Kvantorium-33/optimal_gripper/hardware/Документация/Для отбытия/List of things.docx

Наименование вещи | Количество, штука | Инвентарный номер (если имеется)
Ноутбук Lenovo
Ноутбук Lenovo
Паяльная станция <Название> | 1
