Kvantorium-33/optimal_gripper/hardware/Документация/Изображения/Структурная схема.jpg

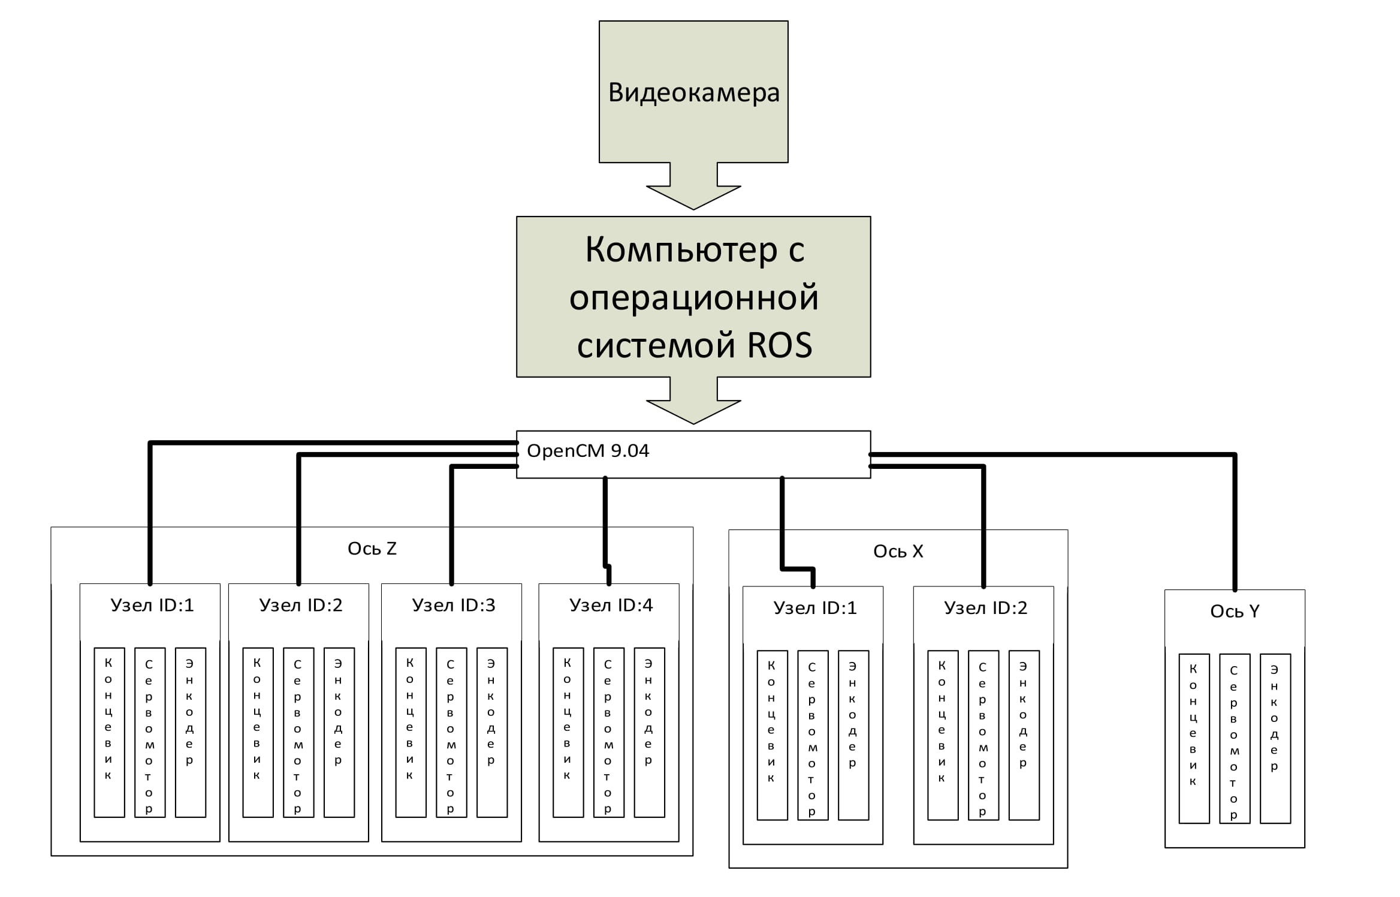
hardware/Документация/Изображения/Структурная схема.jpg
