Kvantorium-33/optimal_gripper/hardware/Документация/Чертежи/КВ33.044.000 - Сортирующая ячейка/КВ33.044.000 - Сортирующая ячейка.jpg

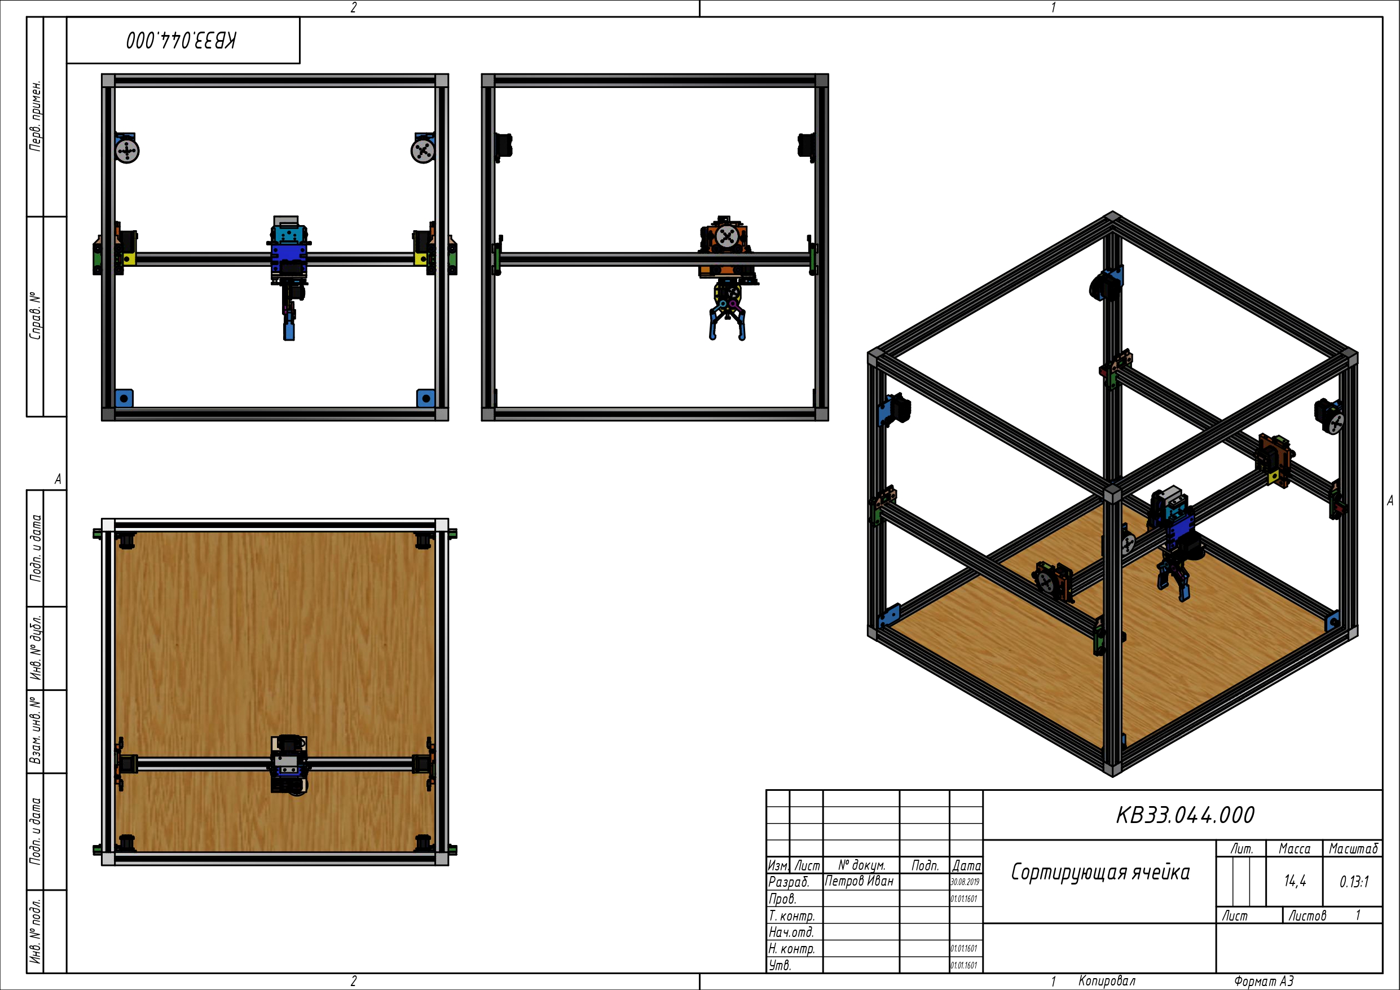
hardware/Документация/Чертежи/КВ33.044.000 - Сортирующая ячейка/КВ33.044.000 - Сортирующая ячейка.jpg
