Kvantorium-33/optimal_gripper/hardware/Документация/Чертежи/КВ33.044.300 - Каретка оси Z/КВ33.044.300 - Каретка оси Z_page-0001.jpg

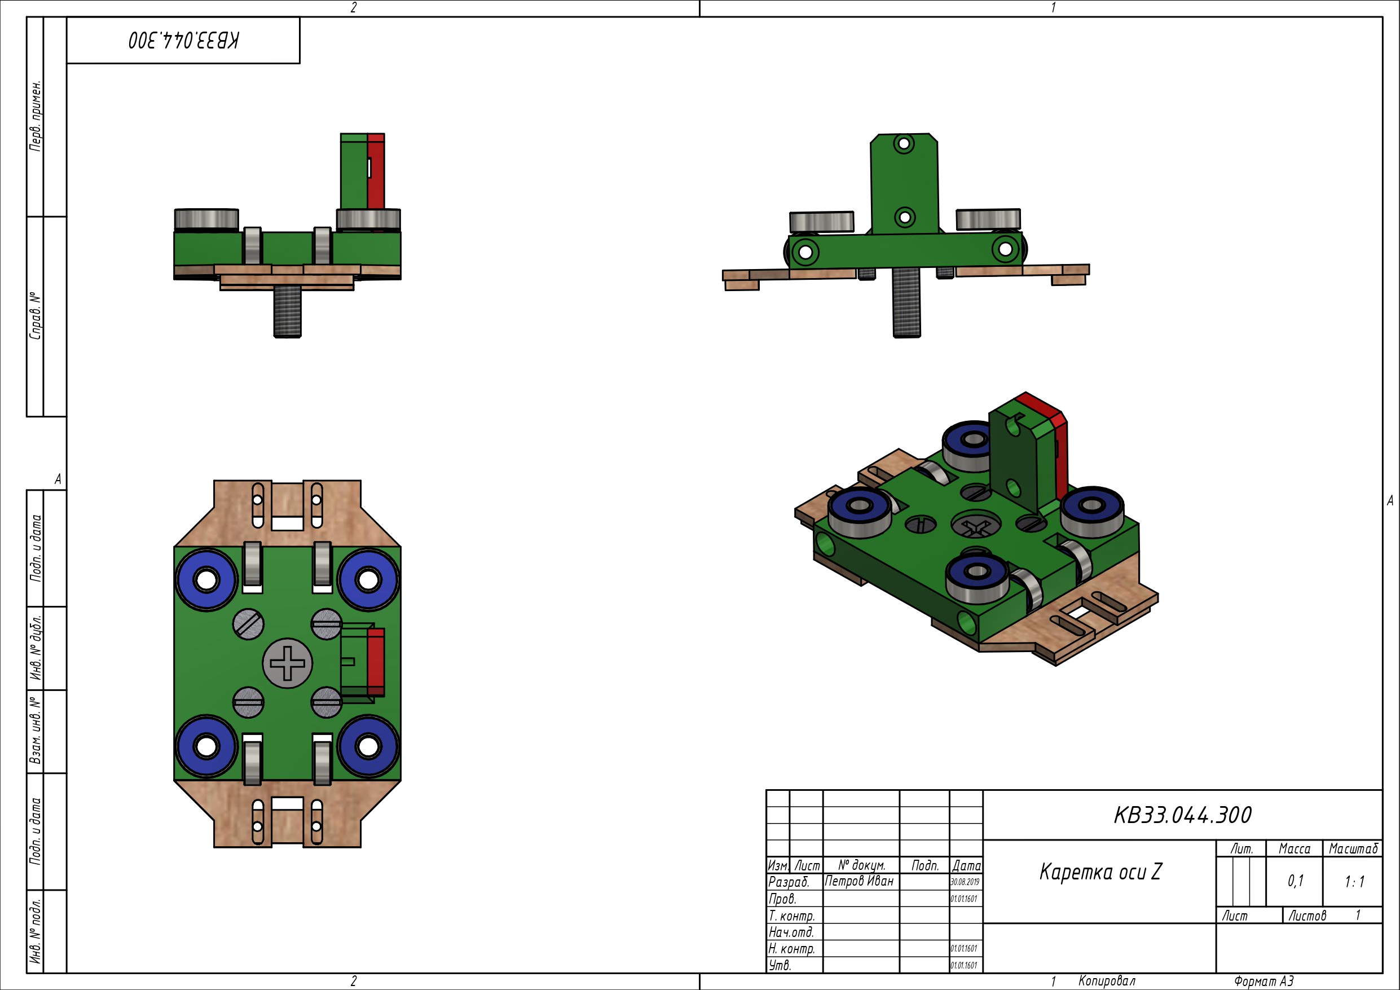
hardware/Документация/Чертежи/КВ33.044.300 - Каретка оси Z/КВ33.044.300 - Каретка оси Z_page-0001.jpg
