Kvantorium-33/optimal_gripper/hardware/Документация/Чертежи/КВ33.044.400 - Каретка оси Х/КВ33.044.400 - Каретка оси X_page-0001.jpg

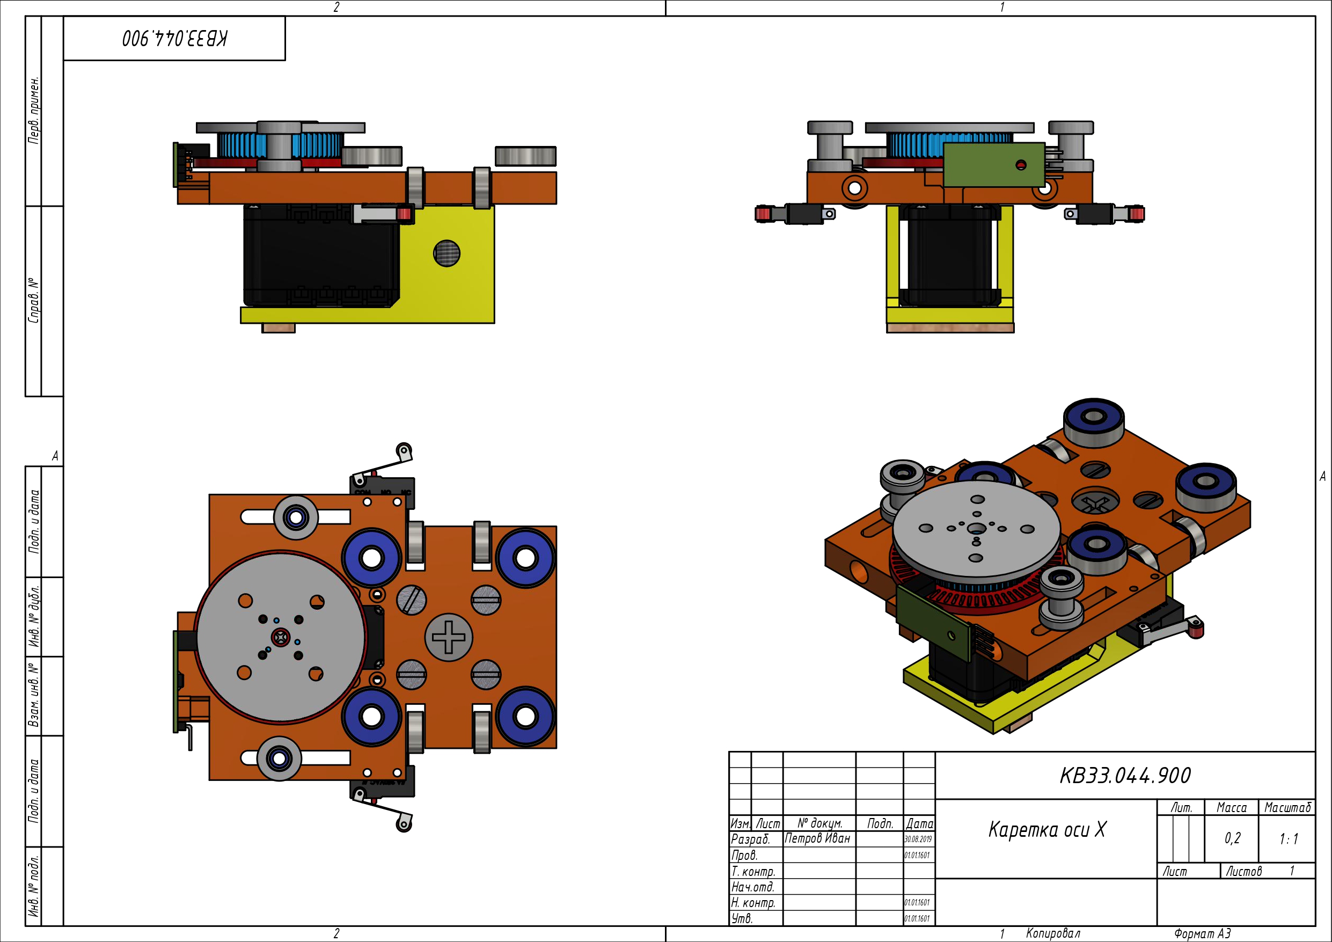
hardware/Документация/Чертежи/КВ33.044.400 - Каретка оси Х/КВ33.044.400 - Каретка оси X_page-0001.jpg
