Kvantorium-33/optimal_gripper/hardware/Документация/Чертежи/КВ33.044.500 - Сборка сервомотора с креплением/КВ33.044.500 -  Сборка сервомотора Dynamixel с крепление_page-0001.jpg

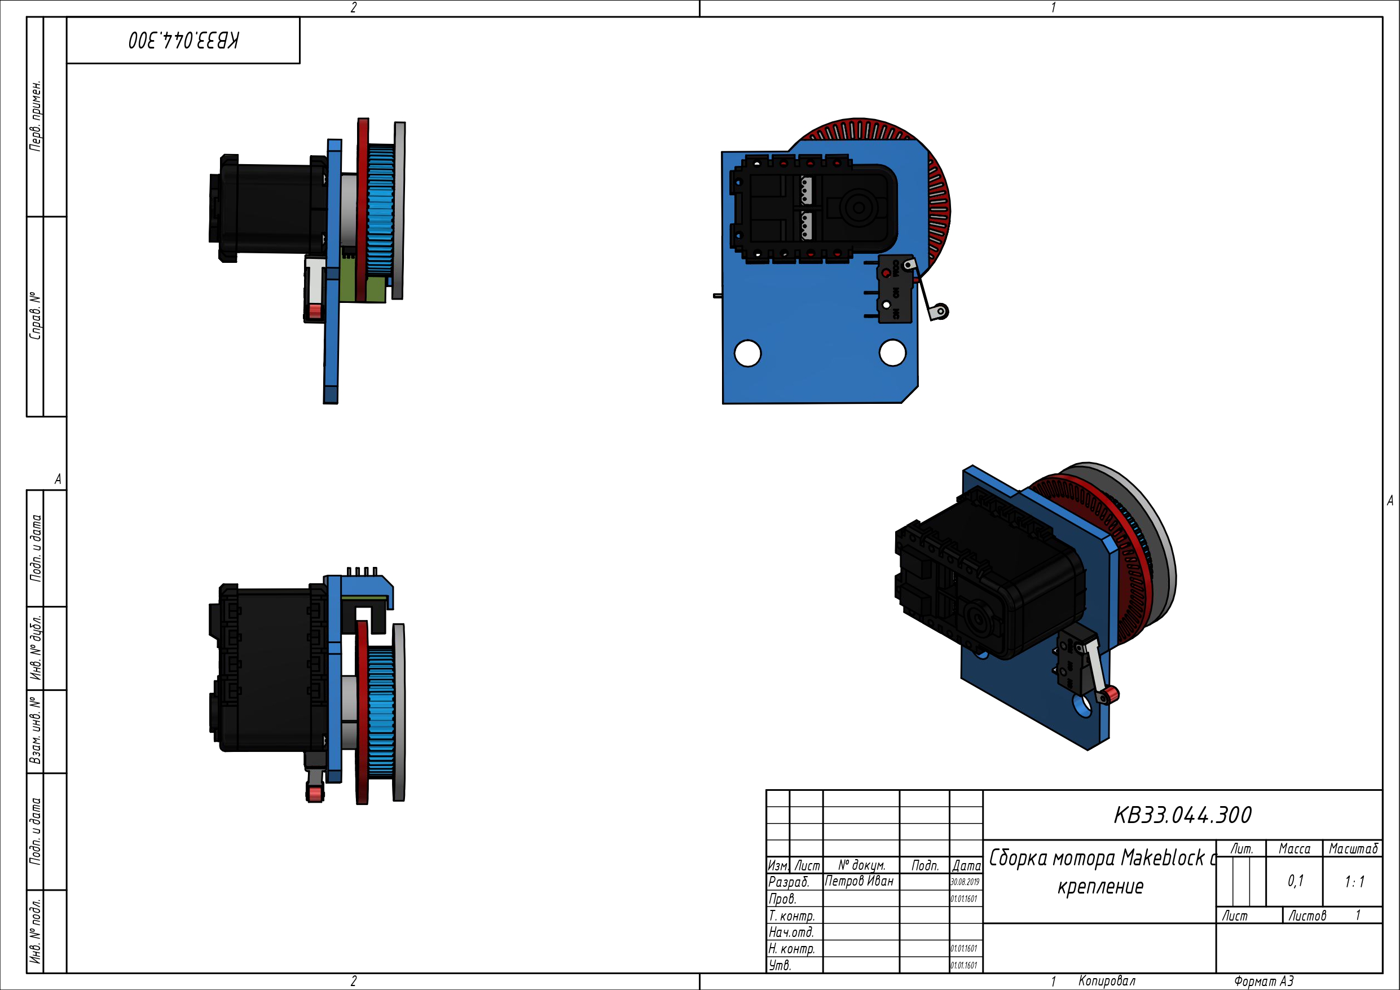
hardware/Документация/Чертежи/КВ33.044.500 - Сборка сервомотора с креплением/КВ33.044.500 - Сборка сервомотора Dynamixel с крепление_page-0001.jpg
