Kvantorium-33/optimal_gripper/hardware/Документация/Чертежи/КВ33.044.600 - Сборка сервомотора с креплением обратная/КВ33.044.600 -  Сборка сервомотора Dynamixel с крепление обратный_page-0001.jpg

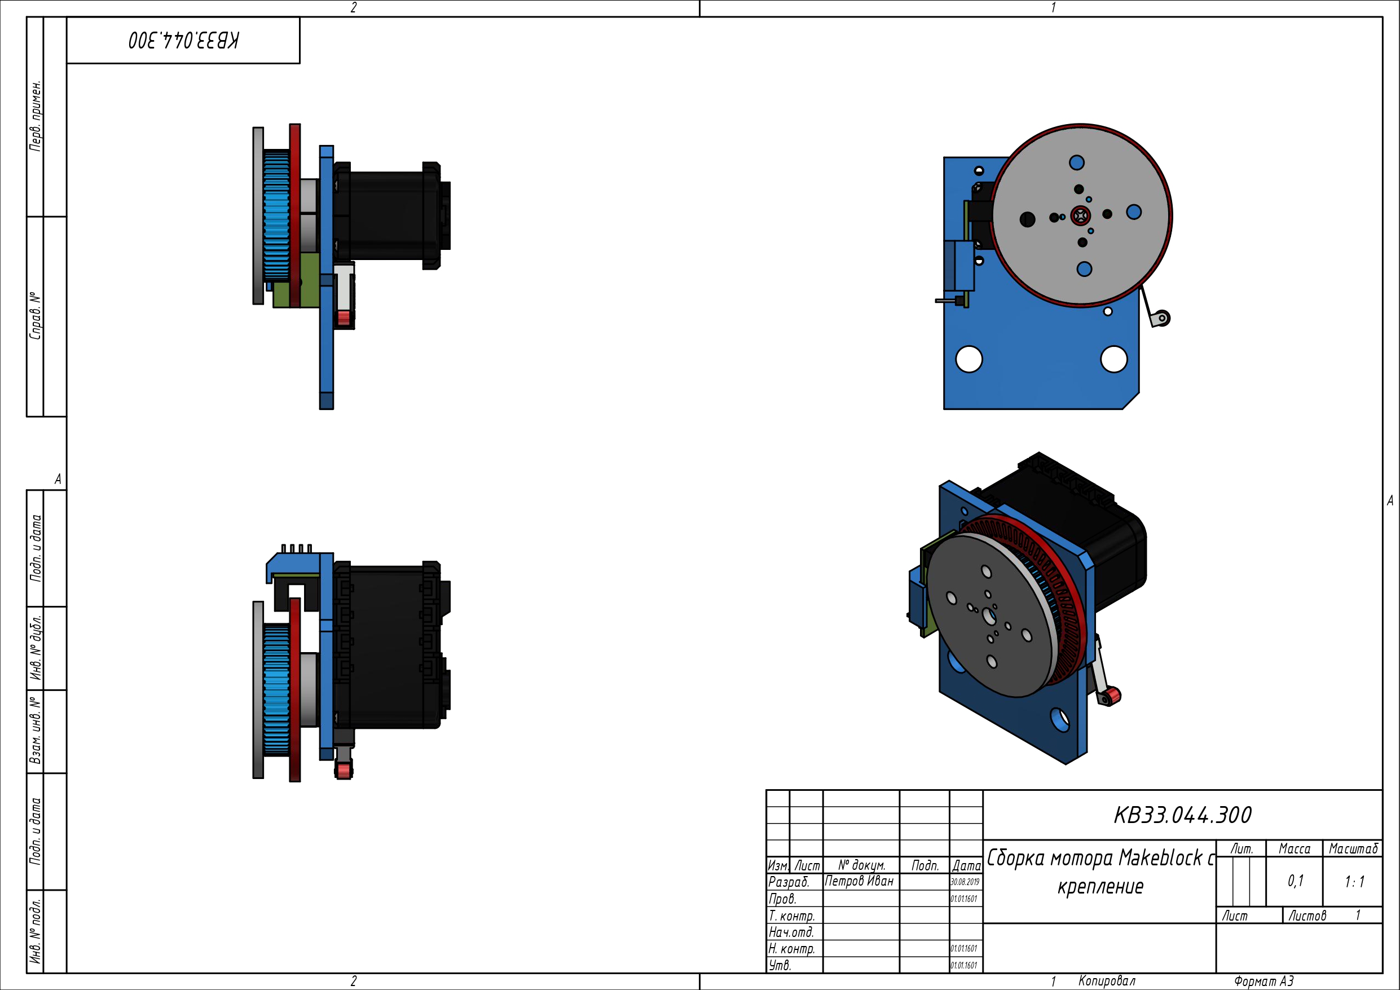
hardware/Документация/Чертежи/КВ33.044.600 - Сборка сервомотора с креплением обратная/КВ33.044.600 - Сборка сервомотора Dynamixel с крепление обратный_page-0001.jpg
