Kvantorium-33/optimal_gripper/hardware/Документация/Чертежи/КВ33.044.700 - Каретка оси Y/КВ33.044.700 - Каретка оси Y_page-0001.jpg

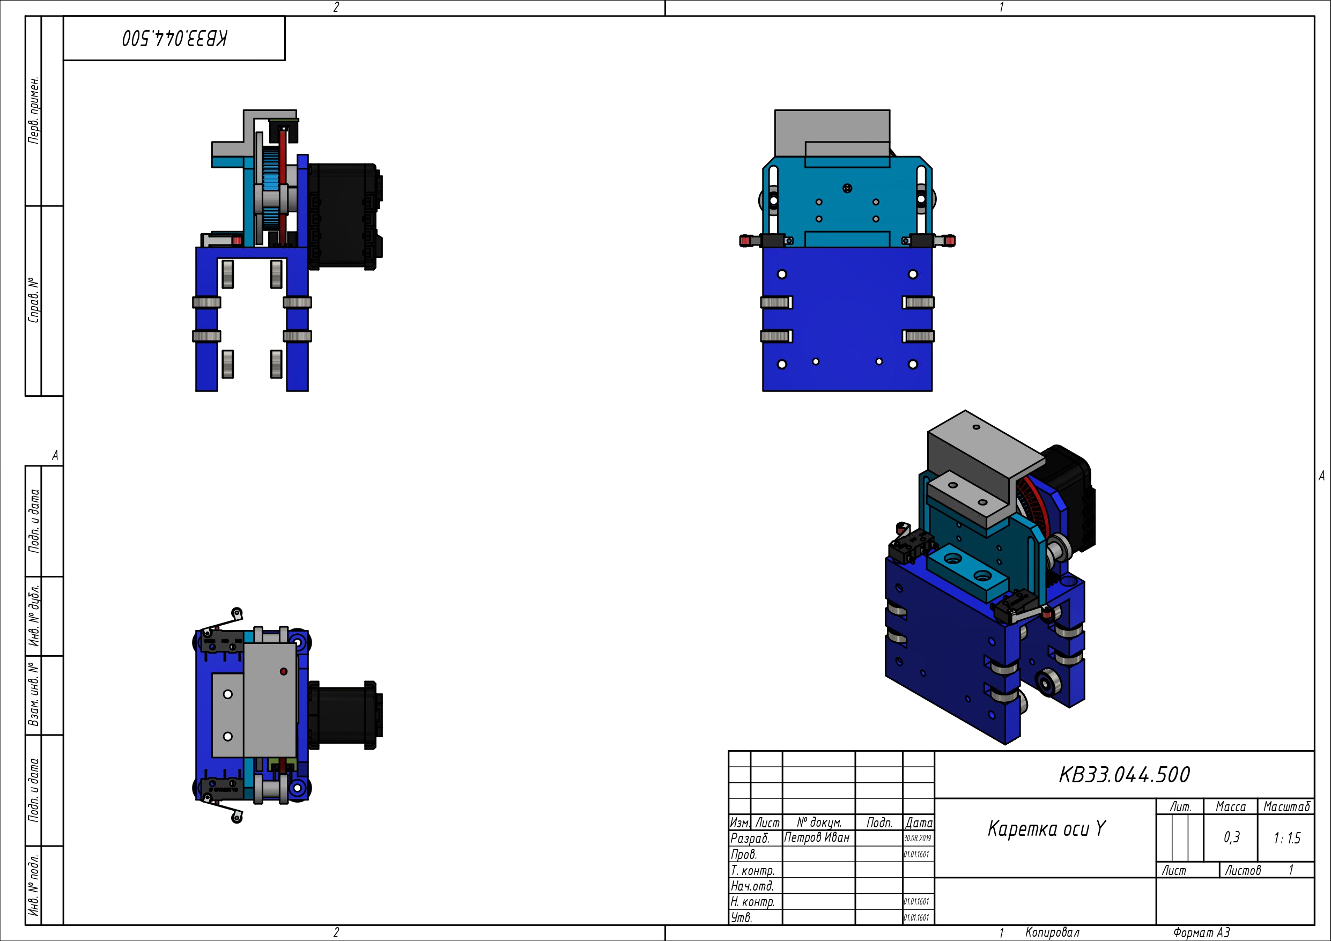
hardware/Документация/Чертежи/КВ33.044.700 - Каретка оси Y/КВ33.044.700 - Каретка оси Y_page-0001.jpg
