Kvantorium-33/optimal_gripper/hardware/Документация/Чертежи/КВ33.044.800 - Каретка оси Y/КВ33.044.800 - Сборка держателя катка_page-0001.jpg

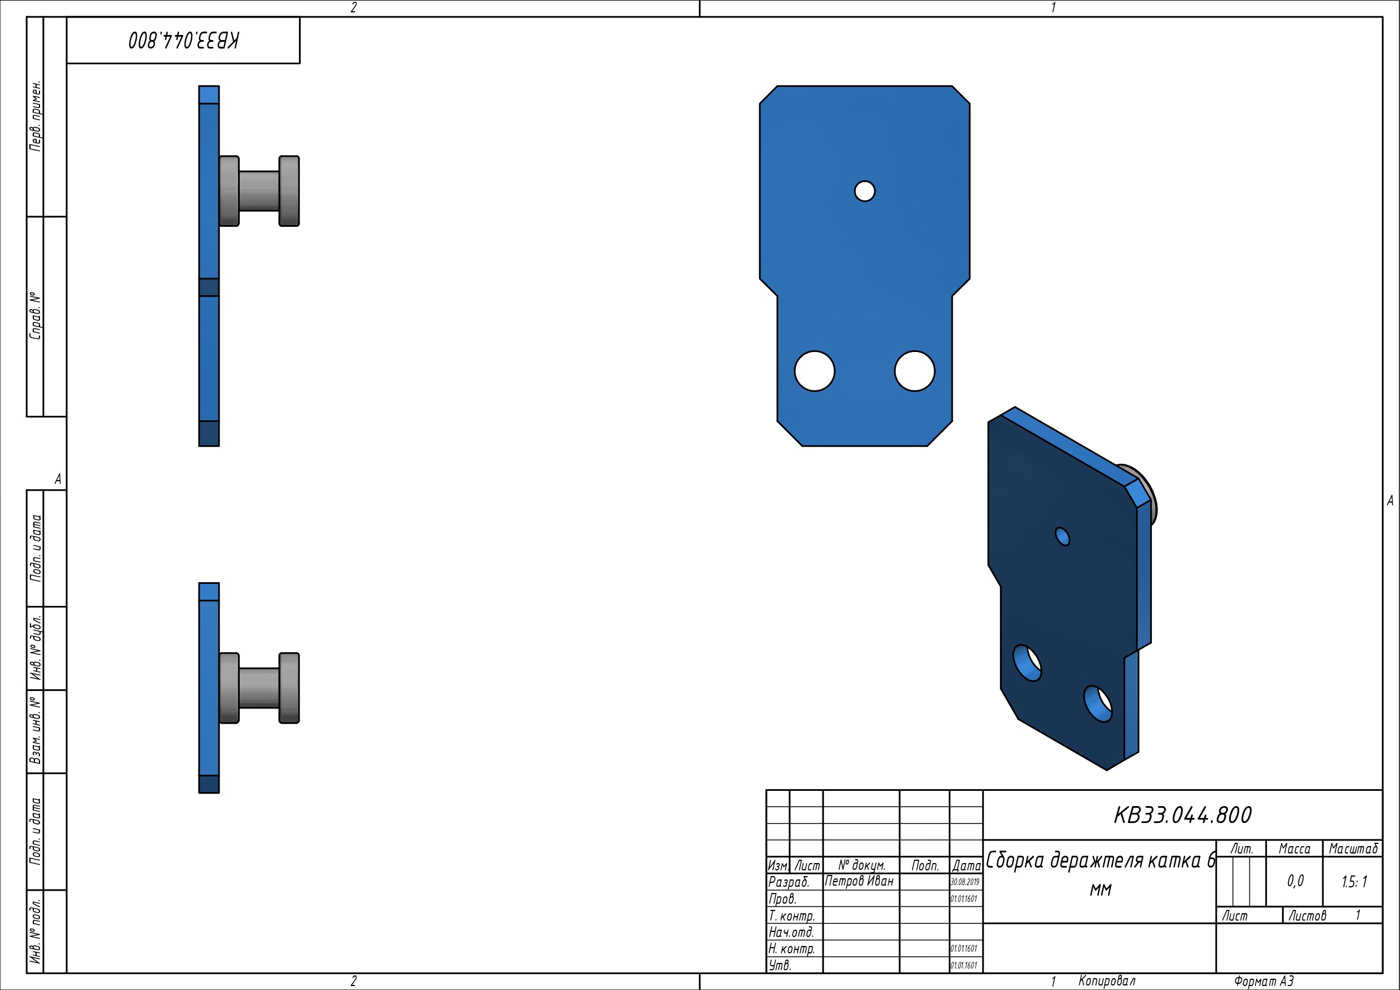
hardware/Документация/Чертежи/КВ33.044.800 - Каретка оси Y/КВ33.044.800 - Сборка держателя катка_page-0001.jpg
