Kvantorium-33/optimal_gripper/hardware/Документация/Чертежи/КВ33.044.900 - Клапан присоски впускной/КВ33.044.900 - Клапан присоски впускной_page-0001.jpg

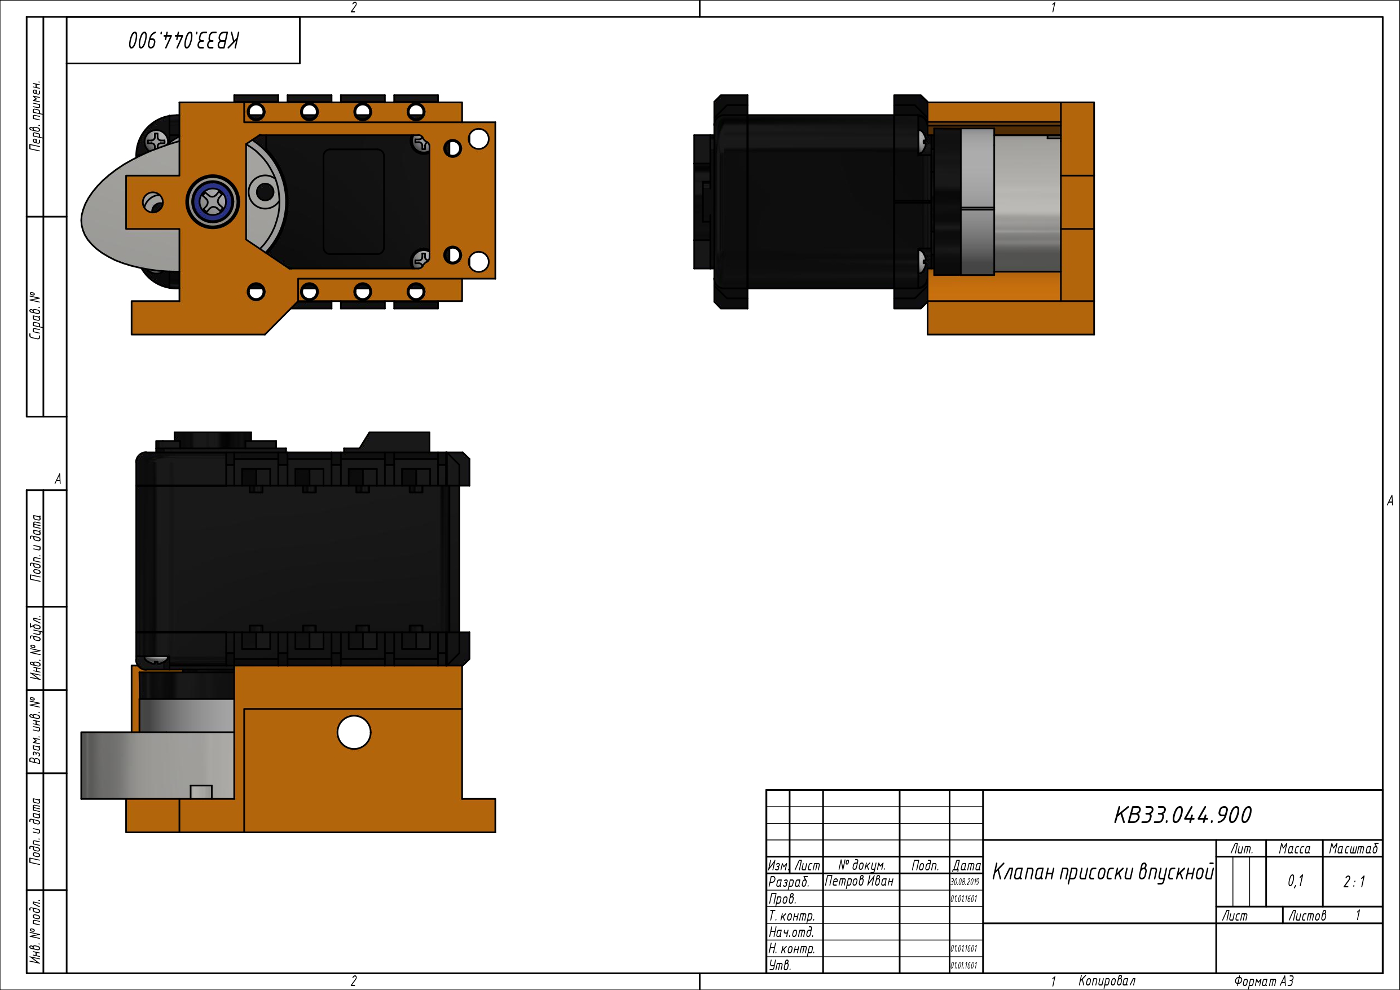
hardware/Документация/Чертежи/КВ33.044.900 - Клапан присоски впускной/КВ33.044.900 - Клапан присоски впускной_page-0001.jpg
