Kvantorium-33/optimal_gripper/hardware/Для изготовления/Cura проекты/UM2_КВ33_044_304  - Z KiT.3mf

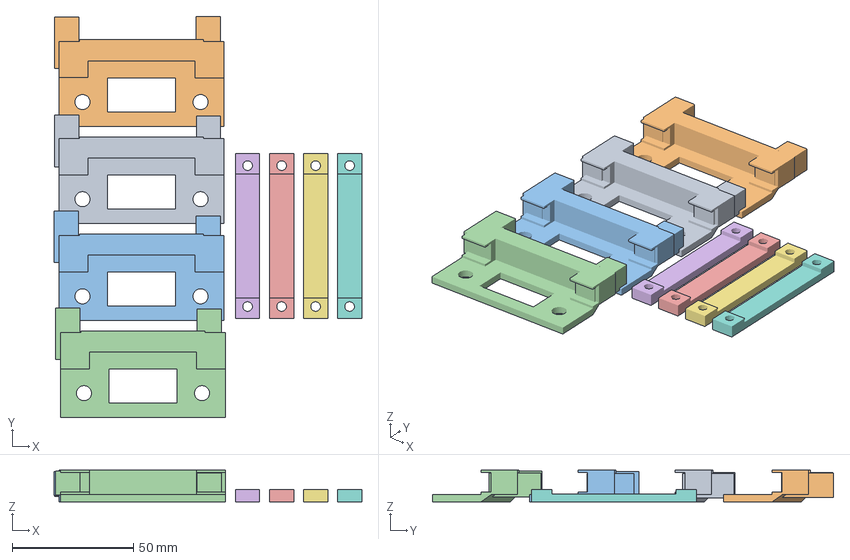
[picture p17: CAD file, 2019-10-25]
hardware/Для изготовления/Cura проекты/UM2_КВ33_044_304 - Z KiT.3mf
126.6 x 165.1 x 13.0 mm
