Kvantorium-33/optimal_gripper/hardware/Для изготовления/DXF (резка)/дно плат.dxf

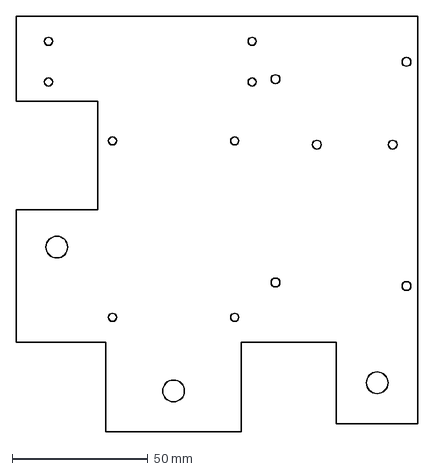
[picture p18: CAD file, 2019-10-30]
hardware/Для изготовления/DXF (резка)/дно плат.dxf
148.0 x 153.0 mm
