Kvantorium-33/optimal_gripper/hardware/Для изготовления/STL (печать)/КВ33.044.406 - Прижим ремня.stl

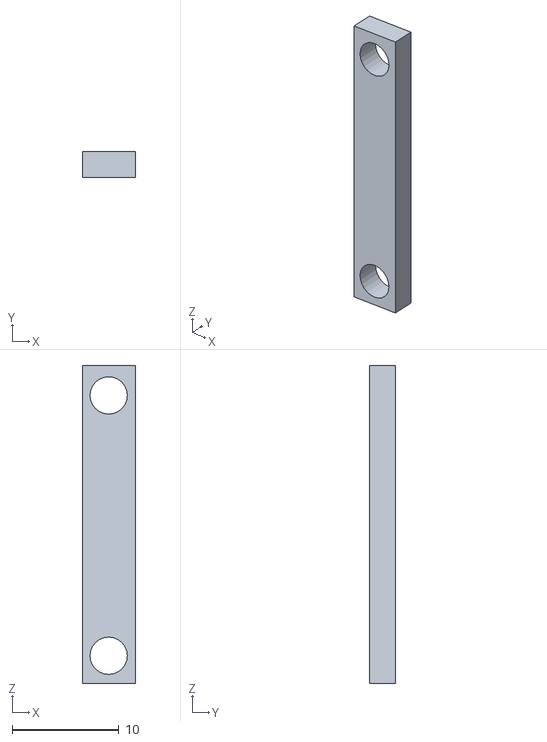
[picture p19: CAD file, 2019-10-25]
hardware/Для изготовления/STL (печать)/КВ33.044.406 - Прижим ремня.stl
5.00 x 2.40 x 29.8
