Kvantorium-33/optimal_gripper/hardware/Для изготовления/Печатная плата/Печатная плата управляющая/Печатная плата управляющая.dxf

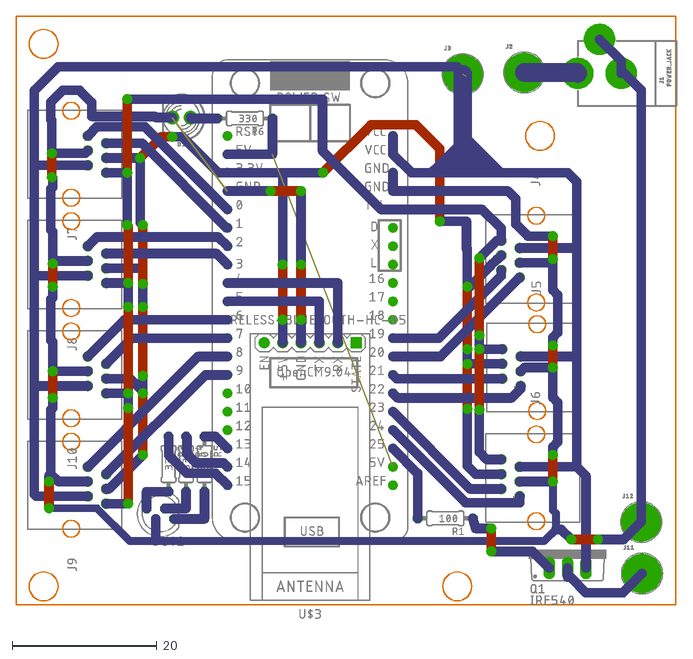
[picture p20: CAD file, 2019-10-25]
hardware/Для изготовления/Печатная плата/Печатная плата управляющая/Печатная плата управляющая.dxf
91.3 x 83.2
