Kvantorium-33/optimal_gripper/hardware/Для изготовления/Cura проекты/UM2_КВ33.044. - krepegi remna oci y.3mf

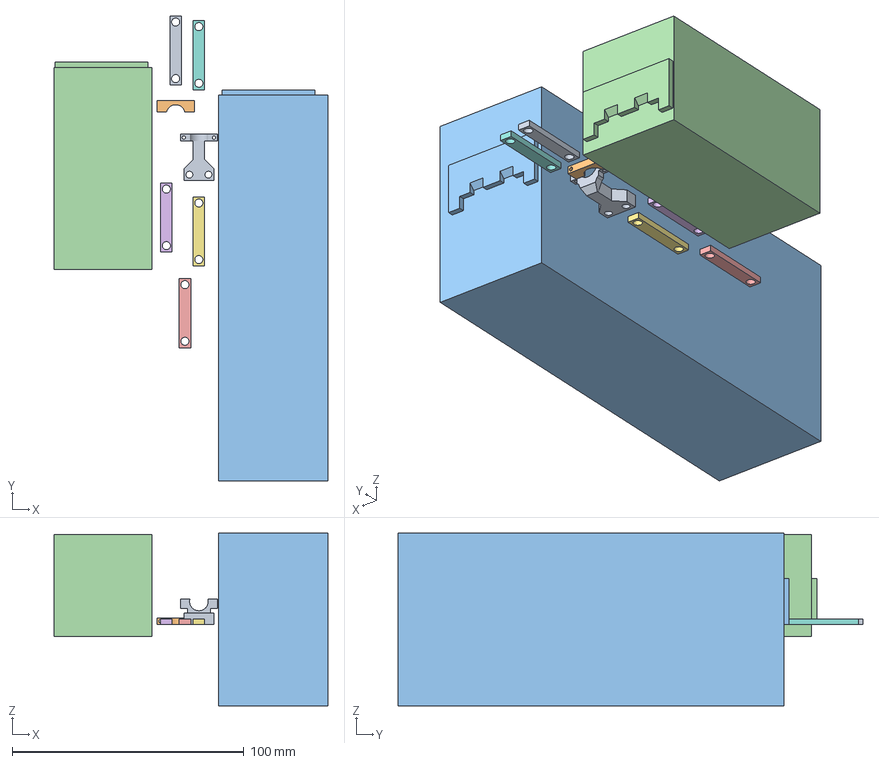
[picture p21: CAD file, 2019-10-25]
hardware/Для изготовления/Cura проекты/UM2_КВ33.044. - krepegi remna oci y.3mf
118.1 x 200.4 x 74.5 mm
