Kvantorium-33/optimal_gripper/hardware/Для изготовления/DXF (резка)/Боковина шкива уменьшанная.dxf

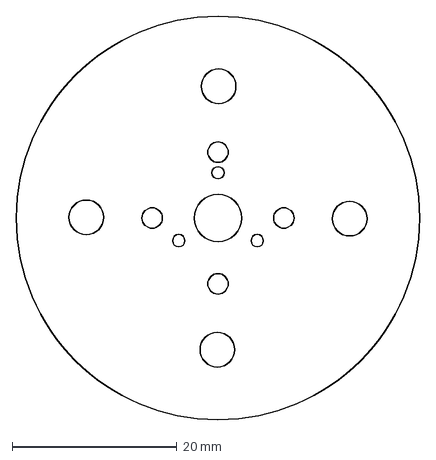
[picture p22: CAD file, 2019-08-26]
hardware/Для изготовления/DXF (резка)/Боковина шкива уменьшанная.dxf
49.0 x 49.0 mm
