Kvantorium-33/optimal_gripper/hardware/Для изготовления/STL (печать)/КВ33.044.208 - Зажим вакумной присоски.stl

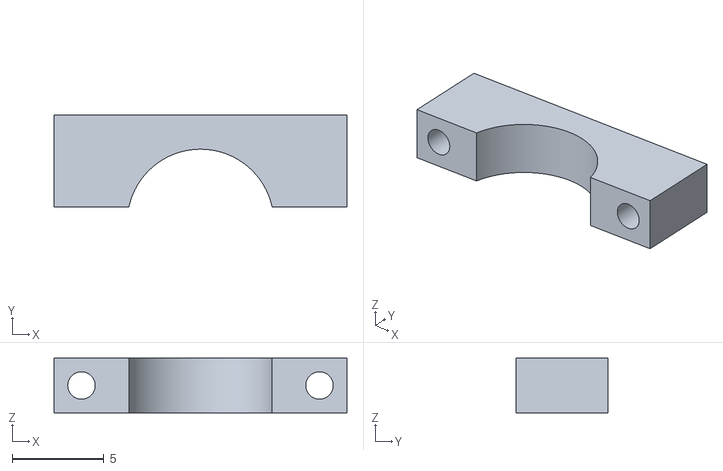
[picture p23: CAD file, 2019-10-25]
hardware/Для изготовления/STL (печать)/КВ33.044.208 - Зажим вакумной присоски.stl
16.0 x 5.00 x 3.00
