Kvantorium-33/optimal_gripper/hardware/Для изготовления/Cura проекты/UM2_КВ33.044.304 - Держатель ремня.3mf

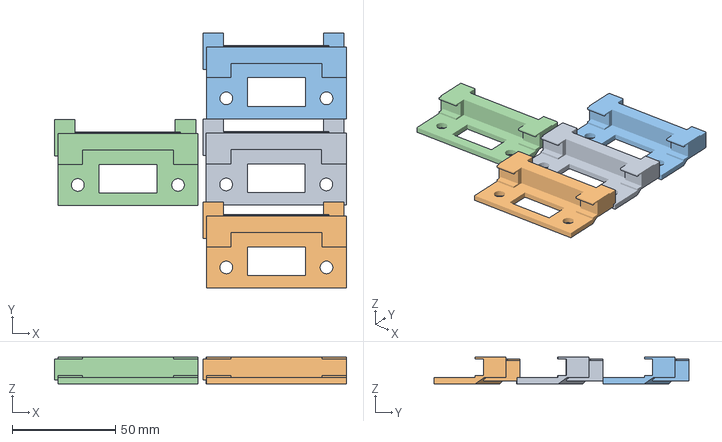
[picture p24: CAD file, 2019-10-25]
hardware/Для изготовления/Cura проекты/UM2_КВ33.044.304 - Держатель ремня.3mf
141.6 x 123.7 x 13.0 mm
