Kvantorium-33/optimal_gripper/hardware/Для изготовления/DXF (резка)/КВ33.044.204 - Крепеж ремня.dxf

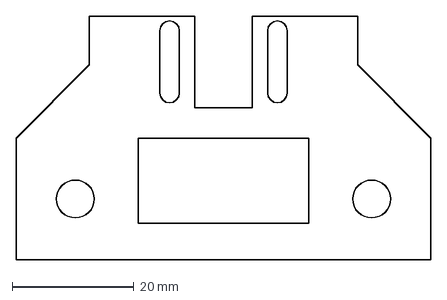
[picture p25: CAD file, 2019-08-19]
hardware/Для изготовления/DXF (резка)/КВ33.044.204 - Крепеж ремня.dxf
68.0 x 40.0 mm
