Kvantorium-33/optimal_gripper/hardware/Для изготовления/STL (печать)/КВ33.044.305 - Прижим ремня.stl

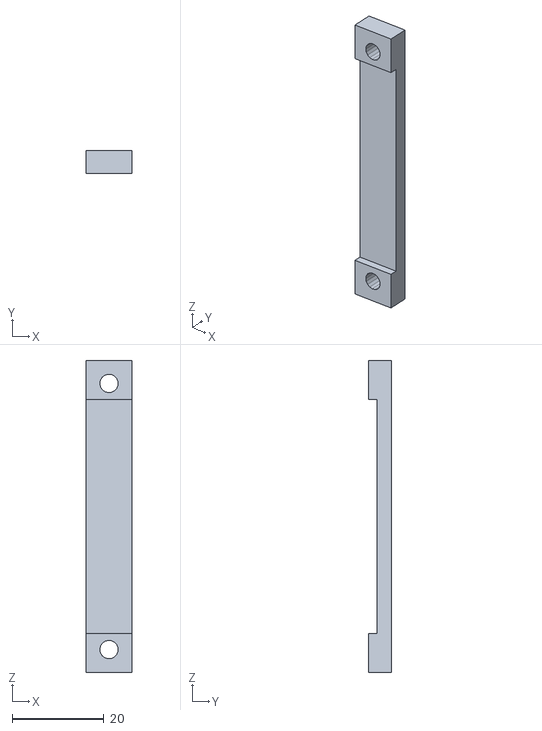
[picture p26: CAD file, 2019-10-25]
hardware/Для изготовления/STL (печать)/КВ33.044.305 - Прижим ремня.stl
10.0 x 5.00 x 68.0
