Kvantorium-33/optimal_gripper/hardware/Для изготовления/Cura проекты/UM2_КВ33.044.900 - Клапан впускной.3mf

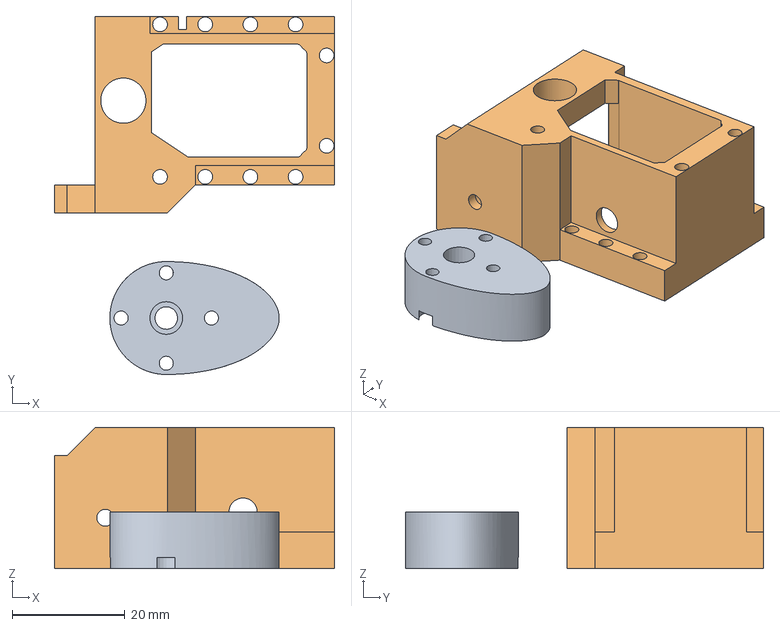
[picture p27: CAD file, 2019-08-25]
hardware/Для изготовления/Cura проекты/UM2_КВ33.044.900 - Клапан впускной.3mf
49.6 x 63.4 x 25.0 mm
