Kvantorium-33/optimal_gripper/hardware/Для изготовления/DXF (резка)/Боковина шкива.dxf

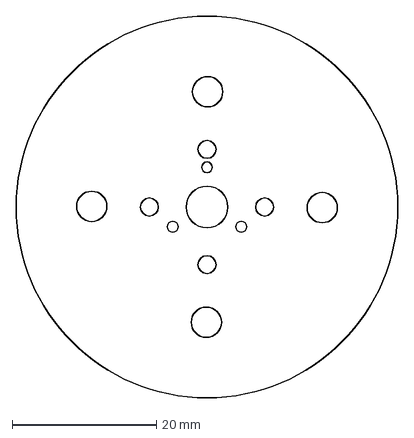
[picture p28: CAD file, 2019-08-08]
hardware/Для изготовления/DXF (резка)/Боковина шкива.dxf
53.0 x 53.0 mm
