Kvantorium-33/optimal_gripper/hardware/Для изготовления/STL (печать)/КВ33.044.405 - Крепеж ремня оси Y.stl

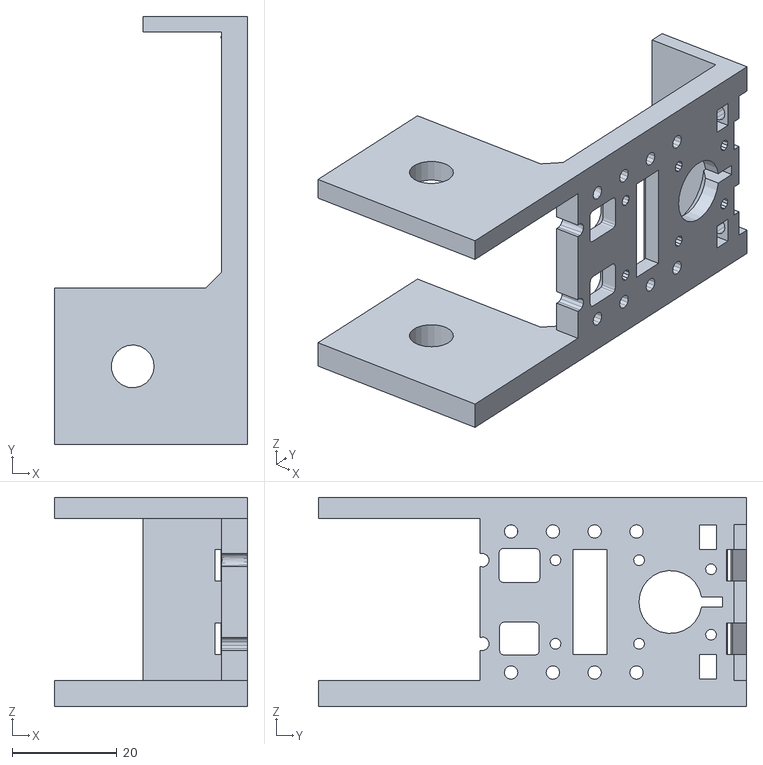
[picture p29: CAD file, 2019-10-25]
hardware/Для изготовления/STL (печать)/КВ33.044.405 - Крепеж ремня оси Y.stl
37.0 x 82.0 x 40.0
