Kvantorium-33/optimal_gripper/hardware/Для изготовления/Cura проекты/UM2_KV33_044 - zahvat.3mf

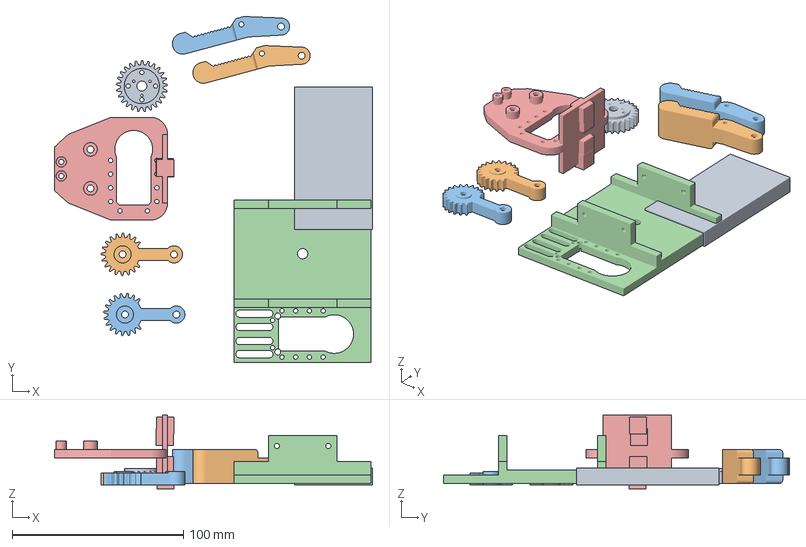
[picture p30: CAD file, 2019-08-22]
hardware/Для изготовления/Cura проекты/UM2_KV33_044 - zahvat.3mf
185.6 x 202.0 x 43.0 mm
