Kvantorium-33/optimal_gripper/hardware/Для изготовления/DXF (резка)/Колесо оптического датчика.dxf

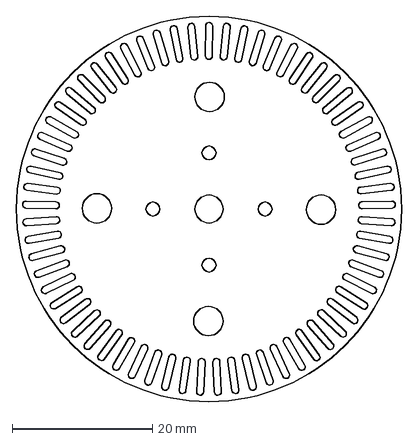
[picture p31: CAD file, 2019-08-08]
hardware/Для изготовления/DXF (резка)/Колесо оптического датчика.dxf
55.0 x 55.0 mm
