Kvantorium-33/optimal_gripper/hardware/Для изготовления/STL (печать)/КВ33.044.207 - Крепление вакумной присоски.stl

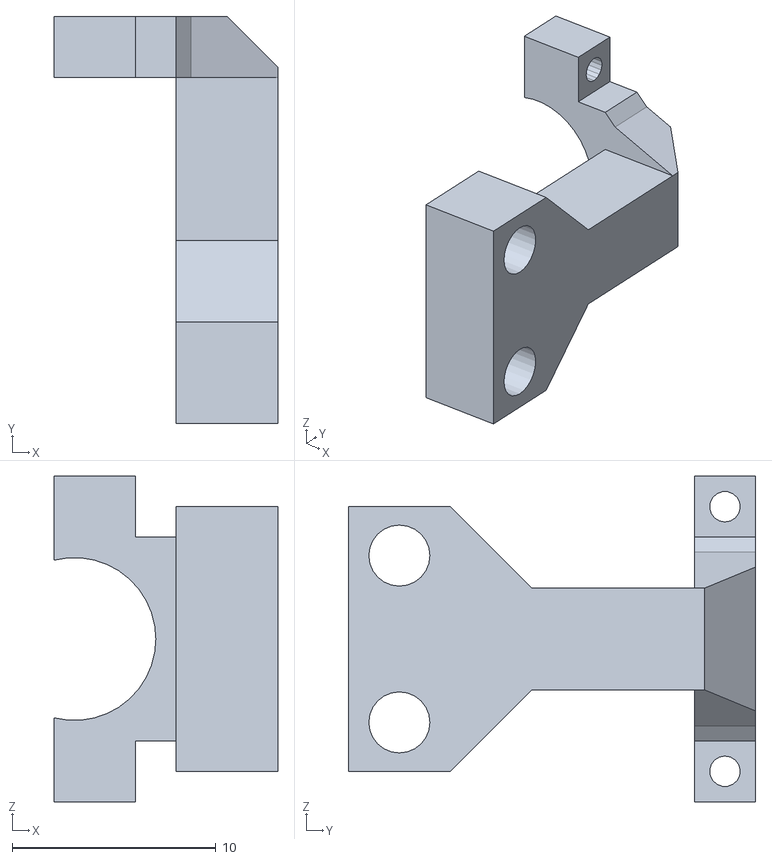
[picture p32: CAD file, 2019-10-25]
hardware/Для изготовления/STL (печать)/КВ33.044.207 - Крепление вакумной присоски.stl
11.0 x 20.0 x 16.0
