Kvantorium-33/optimal_gripper/hardware/Для изготовления/Cura проекты/UM2_КВ33.044.701 - Щека каретка оси Y.3mf

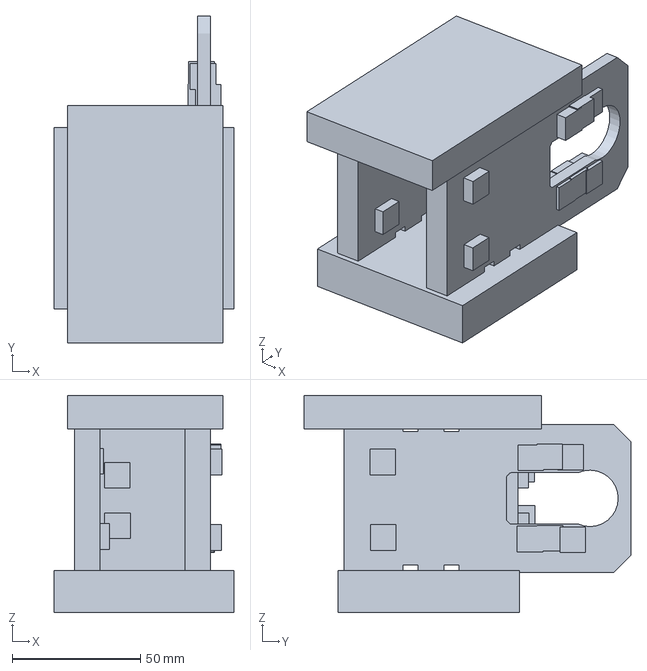
[picture p33: CAD file, 2019-08-19]
hardware/Для изготовления/Cura проекты/UM2_КВ33.044.701 - Щека каретка оси Y.3mf
70.1 x 127.5 x 84.7 mm
