Kvantorium-33/optimal_gripper/hardware/Для изготовления/STL (печать)/КВ33.044.304 - Держатель ремня.stl

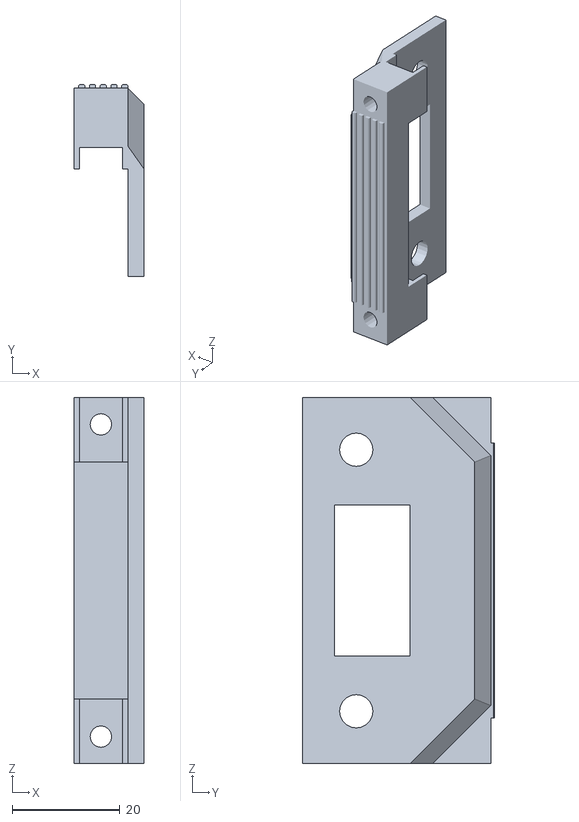
[picture p34: CAD file, 2019-10-25]
hardware/Для изготовления/STL (печать)/КВ33.044.304 - Держатель ремня.stl
13.0 x 35.7 x 68.0
