Kvantorium-33/optimal_gripper/hardware/Для изготовления/Cura проекты/UM2_КВ33.044.601 - Щека каретка оси Y.3mf

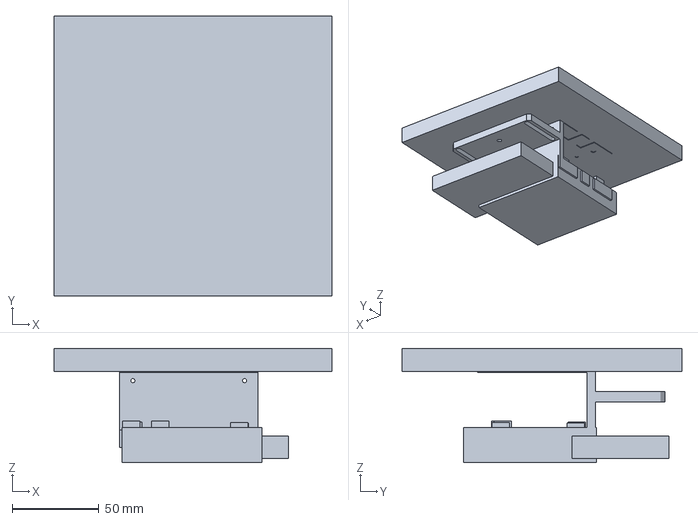
[picture p35: CAD file, 2019-08-15]
hardware/Для изготовления/Cura проекты/UM2_КВ33.044.601 - Щека каретка оси Y.3mf
160.2 x 161.3 x 65.8 mm
