Kvantorium-33/optimal_gripper/hardware/Для изготовления/STL (печать)/КВ33.044.703 - Стойка оптического датчика оси Y.stl

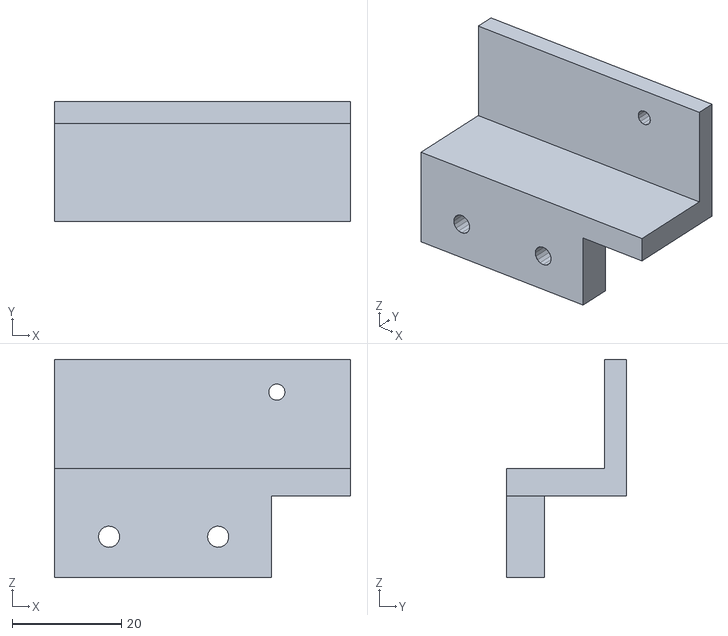
[picture p36: CAD file, 2019-08-26]
hardware/Для изготовления/STL (печать)/КВ33.044.703 - Стойка оптического датчика оси Y.stl
54.2 x 22.0 x 40.0
