Kvantorium-33/optimal_gripper/hardware/Для изготовления/Cura проекты/UM2_КВ33.044.201 - Щека каретки Z.3mf

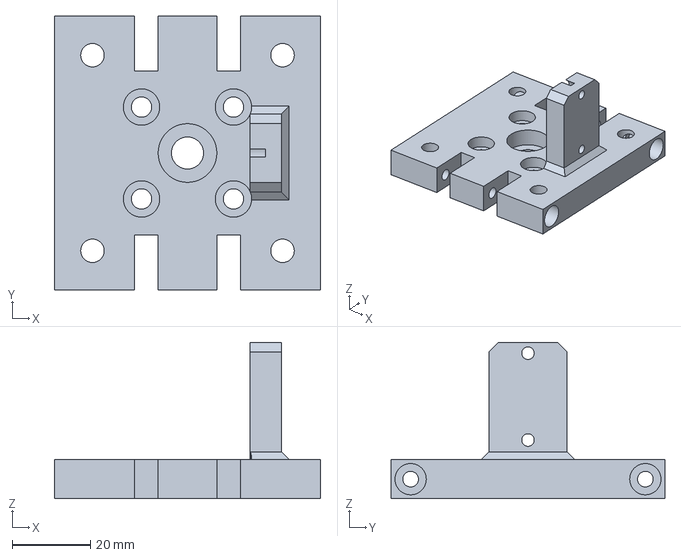
[picture p37: CAD file, 2019-08-14]
hardware/Для изготовления/Cura проекты/UM2_КВ33.044.201 - Щека каретки Z.3mf
68.0 x 70.0 x 40.0 mm
