Kvantorium-33/optimal_gripper/hardware/Для изготовления/STL (печать)/КВ33.044.702 - Стойка натягивающих роликов оси Y.stl

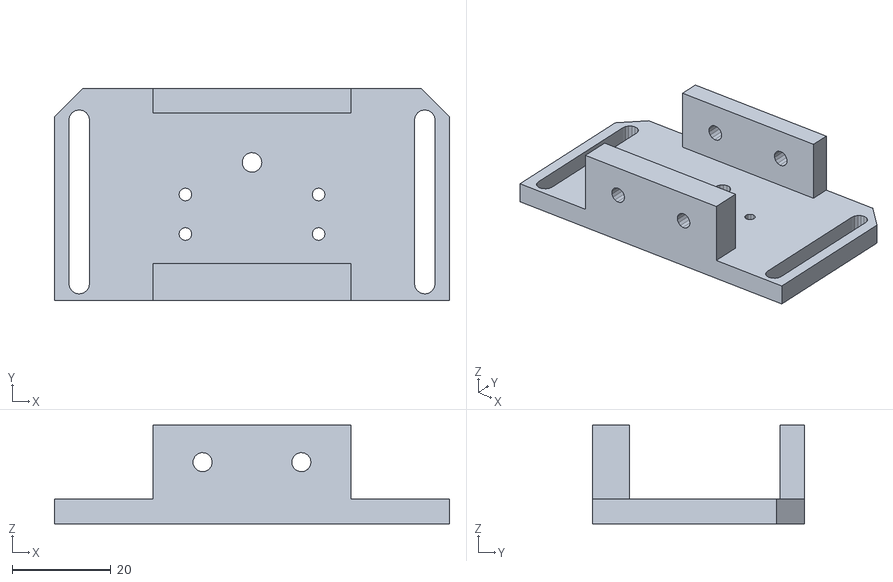
[picture p38: CAD file, 2019-08-26]
hardware/Для изготовления/STL (печать)/КВ33.044.702 - Стойка натягивающих роликов оси Y.stl
80.0 x 43.0 x 20.0
