Kvantorium-33/optimal_gripper/hardware/Для изготовления/STL (печать)/КВ33.044.901  - Опора клапана присоски.stl

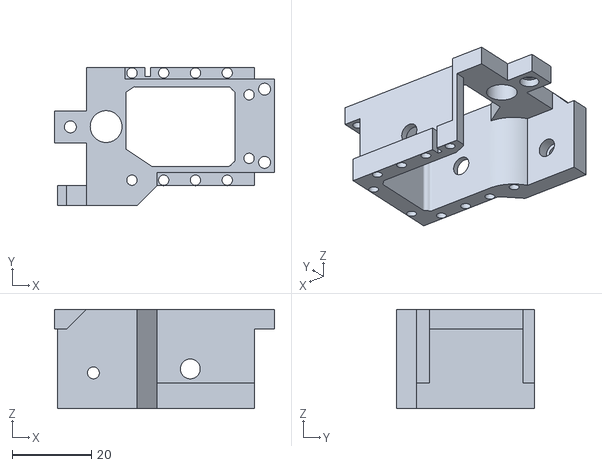
[picture p39: CAD file, 2019-08-26]
hardware/Для изготовления/STL (печать)/КВ33.044.901 - Опора клапана присоски.stl
55.4 x 34.8 x 25.0
