Kvantorium-33/optimal_gripper/hardware/Для изготовления/STL (печать)/КВ33.044.902 - Кулачок дисковый.stl

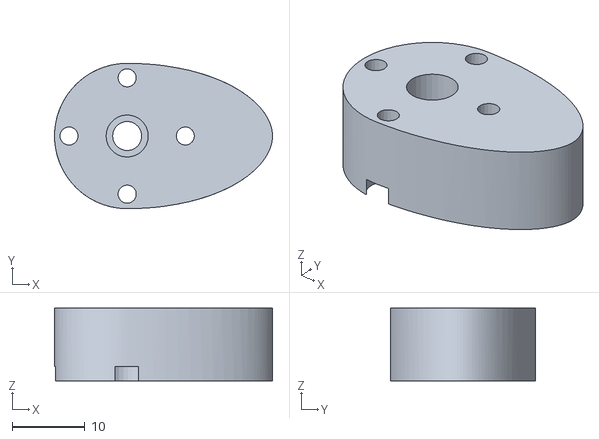
[picture p40: CAD file, 2019-08-25]
hardware/Для изготовления/STL (печать)/КВ33.044.902 - Кулачок дисковый.stl
30.0 x 20.0 x 10.0
