Kvantorium-33/optimal_gripper/hardware/Для изготовления/STL (печать)/КВ33.044.205-  Рычаг приводной 17 зубьев.stl

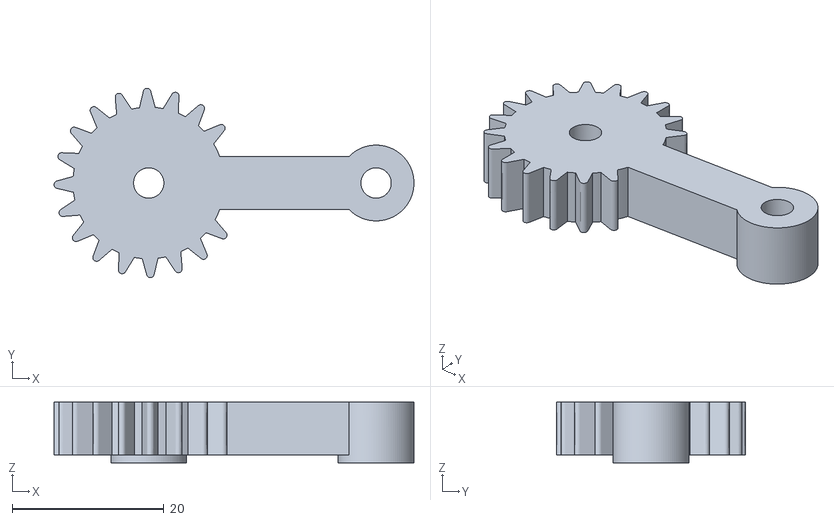
[picture p41: CAD file, 2019-08-22]
hardware/Для изготовления/STL (печать)/КВ33.044.205- Рычаг приводной 17 зубьев.stl
47.5 x 25.0 x 8.00
