Kvantorium-33/optimal_gripper/hardware/Для изготовления/STL (печать)/КВ33.044.102 - Колесо зубчатое сервомотора.stl

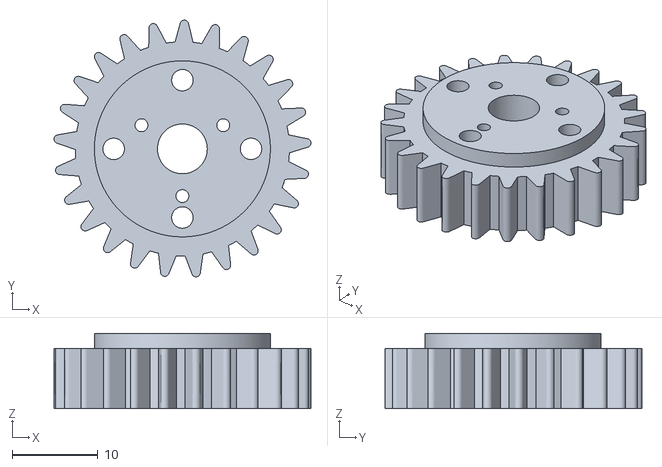
[picture p42: CAD file, 2019-08-22]
hardware/Для изготовления/STL (печать)/КВ33.044.102 - Колесо зубчатое сервомотора.stl
29.9 x 29.9 x 8.76
