Kvantorium-33/optimal_gripper/hardware/Для изготовления/STL (печать)/КВ33.044.202 - Прихват.stl

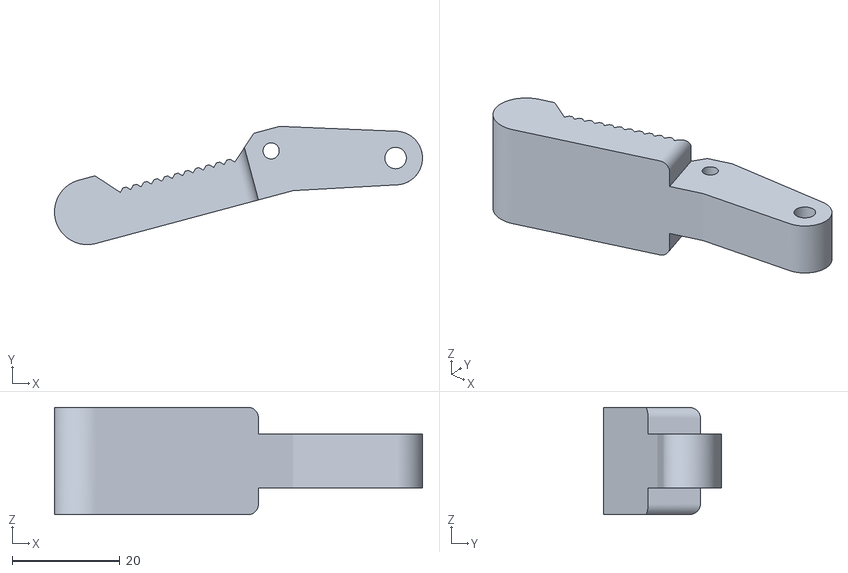
[picture p43: CAD file, 2019-08-22]
hardware/Для изготовления/STL (печать)/КВ33.044.202 - Прихват.stl
68.5 x 22.0 x 20.0
