Kvantorium-33/optimal_gripper/hardware/Для изготовления/STL (печать)/КВ33.044.203 - Рычаг толстый.stl

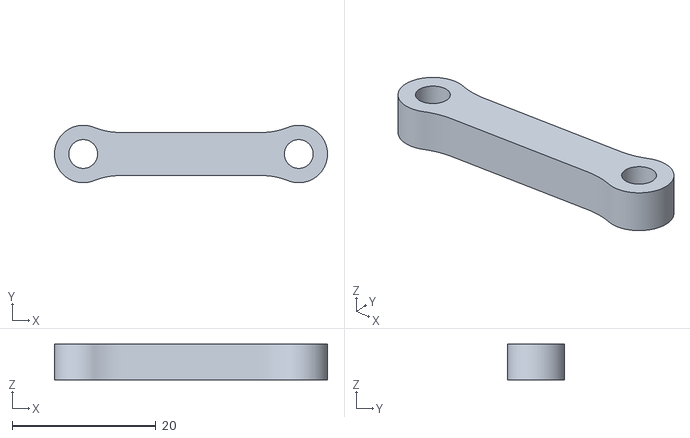
[picture p44: CAD file, 2019-08-22]
hardware/Для изготовления/STL (печать)/КВ33.044.203 - Рычаг толстый.stl
38.0 x 8.00 x 5.00
