Kvantorium-33/optimal_gripper/hardware/Для изготовления/STL (печать)/КВ33.044.201 - Опора прижимного захвата.stl

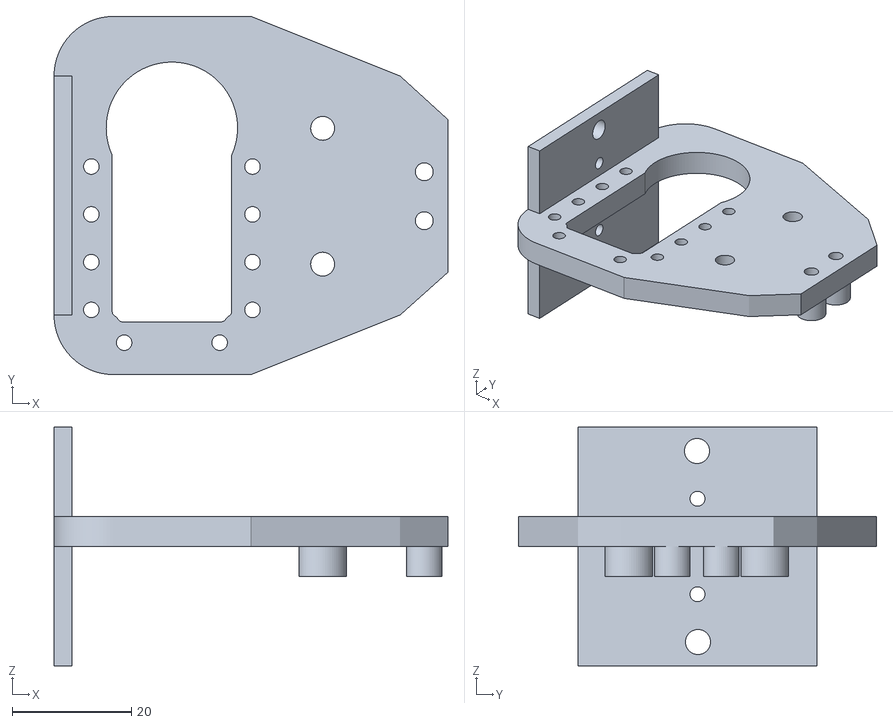
[picture p45: CAD file, 2019-08-22]
hardware/Для изготовления/STL (печать)/КВ33.044.201 - Опора прижимного захвата.stl
66.0 x 60.0 x 40.0
