Kvantorium-33/optimal_gripper/hardware/Для изготовления/STL (печать)/КВ33.044.204 - Рычг тонкий.stl

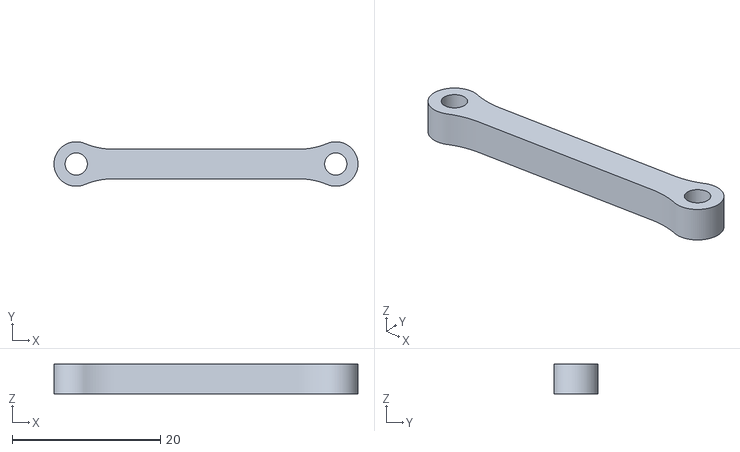
[picture p46: CAD file, 2019-08-22]
hardware/Для изготовления/STL (печать)/КВ33.044.204 - Рычг тонкий.stl
41.0 x 6.00 x 4.00
