Kvantorium-33/optimal_gripper/hardware/Для изготовления/STL (печать)/КВ33.044.101 - Опора захвата.stl

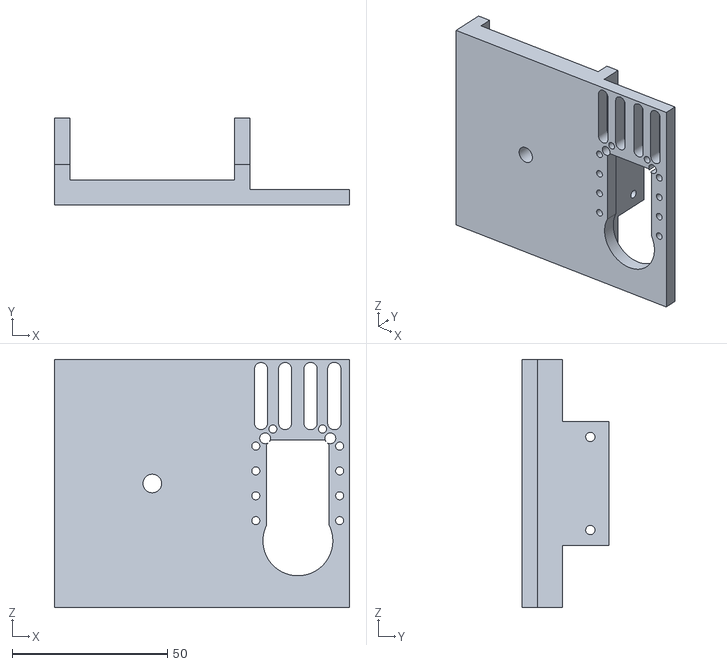
[picture p47: CAD file, 2019-08-22]
hardware/Для изготовления/STL (печать)/КВ33.044.101 - Опора захвата.stl
95.0 x 28.0 x 80.0
