Kvantorium-33/optimal_gripper/hardware/Для изготовления/STL (печать)/КВ33.044.206 - Рычаг приводной 16 зубьев.stl

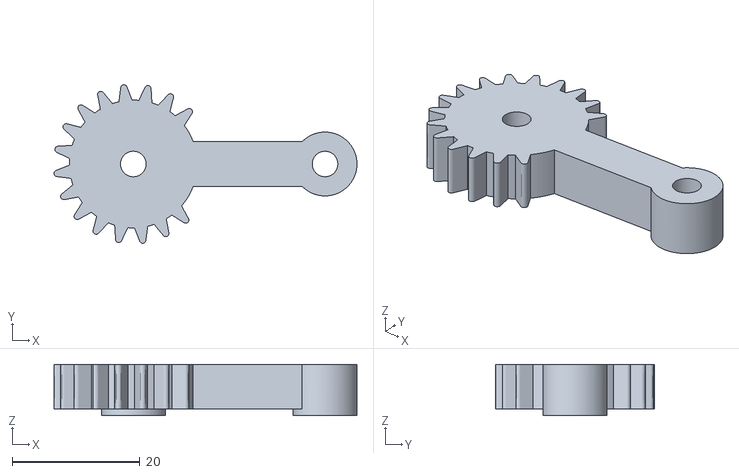
[picture p48: CAD file, 2019-08-22]
hardware/Для изготовления/STL (печать)/КВ33.044.206 - Рычаг приводной 16 зубьев.stl
47.4 x 24.8 x 8.00
