Kvantorium-33/optimal_gripper/hardware/Для изготовления/STL (печать)/Проставка 5.5 мм.stl

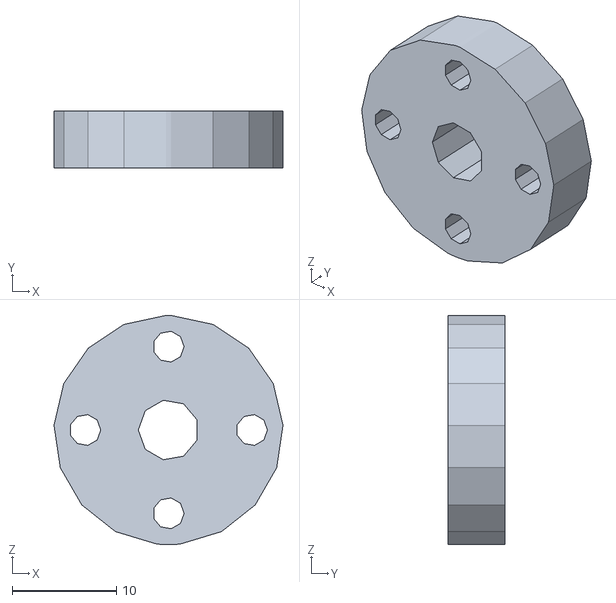
[picture p49: CAD file, 2019-08-19]
hardware/Для изготовления/STL (печать)/Проставка 5.5 мм.stl
22.0 x 5.50 x 22.0
