Kvantorium-33/optimal_gripper/hardware/Для изготовления/STL (печать)/Проставка 6.5 мм.stl

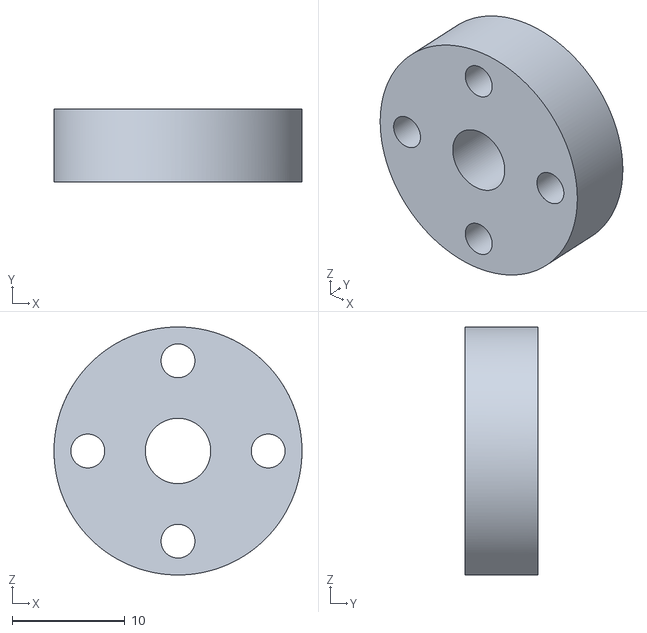
[picture p50: CAD file, 2019-08-12]
hardware/Для изготовления/STL (печать)/Проставка 6.5 мм.stl
22.0 x 6.50 x 22.0
