Kvantorium-33/optimal_gripper/hardware/Для изготовления/STL (печать)/КВ33.044.203 - Прижим ремня каретки X.stl

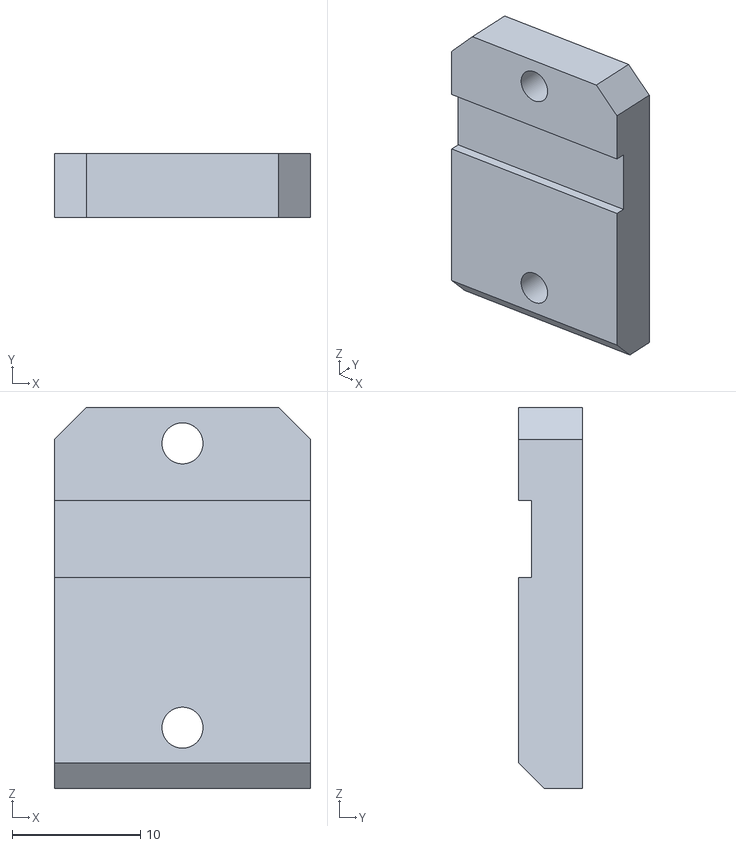
[picture p51: CAD file, 2019-08-08]
hardware/Для изготовления/STL (печать)/КВ33.044.203 - Прижим ремня каретки X.stl
20.0 x 5.00 x 29.8
