Kvantorium-33/optimal_gripper/hardware/Для изготовления/STL (печать)/Проставка 4 мм.stl

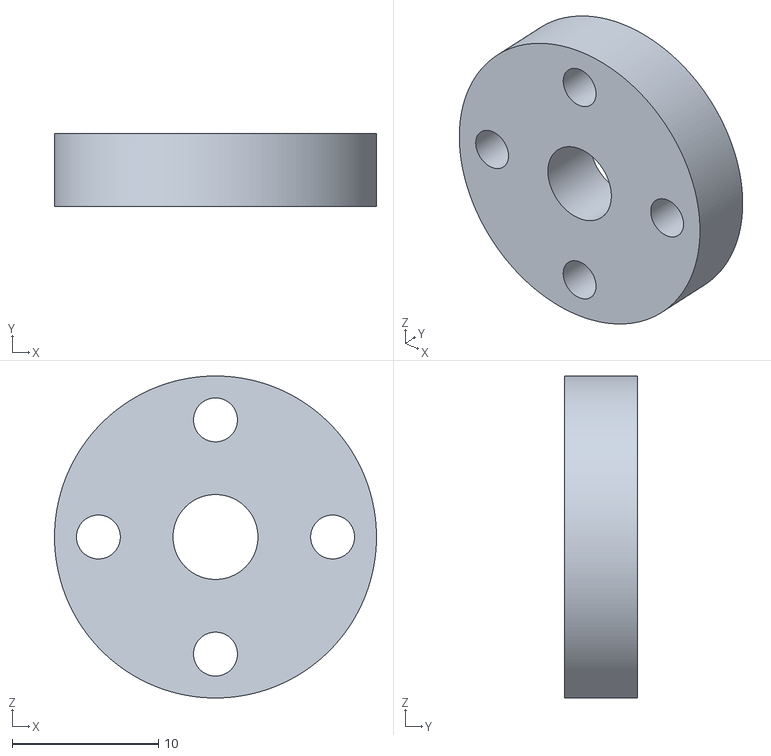
[picture p52: CAD file, 2019-08-08]
hardware/Для изготовления/STL (печать)/Проставка 4 мм.stl
22.0 x 5.00 x 22.0
