Kvantorium-33/optimal_gripper/(list of files, cad)

Other CAD files:
hardware/Документация/Чертежи/КВ33.044.100 - Захват/КВ33.044.100 - Захват.dwg
hardware/Документация/Чертежи/КВ33.044.200 - Сборка зажима/КВ33.044.203 - Рычаг толстый.dwg
hardware/Документация/Чертежи/КВ33.044.300 - Каретка оси Z/КВ33.044.300 - Каретка оси Z.dwg
hardware/Документация/Чертежи/КВ33.044.400 - Каретка оси Х/КВ33.044.400 - Каретка оси X.dwg
hardware/Документация/Чертежи/КВ33.044.500 - Сборка сервомотора с креплением/КВ33.044.500 - Сборка сервомотора Dynamixel с крепление.dwg
hardware/Документация/Чертежи/КВ33.044.600 - Сборка сервомотора с креплением обратная/КВ33.044.600 - Сборка сервомотора Dynamixel с крепление обратный.dwg
hardware/Документация/Чертежи/КВ33.044.700 - Каретка оси Y/КВ33.044.700 - Каретка оси Y.dwg
hardware/Документация/Чертежи/КВ33.044.800 - Каретка оси Y/КВ33.044.800 - Сборка держателя катка.dwg
hardware/Документация/Чертежи/КВ33.044.900 - Клапан присоски впускной/КВ33.044.900 - Клапан присоски впускной.dwg
hardware/Документация/Чертежи/Проставка 5 мм.dwg
hardware/Документация/Чертежи/КВ33.044.100 - Захват/Боковина шкива уменьшанная.dwg
hardware/Документация/Чертежи/КВ33.044.200 - Сборка зажима/КВ33.044.201 - Опора зажимного механизма.dwg
hardware/Документация/Чертежи/КВ33.044.400 - Каретка оси Х/КВ33.044.401 - Щека каретки X.dwg
hardware/Документация/Чертежи/КВ33.044.900 - Клапан присоски впускной/КВ33.044.902 - Кулачок дисковый.dwg
hardware/Документация/Чертежи/КВ33.044.200 - Сборка зажима/КВ33.044.206 - Рычаг приводной 16 зубьев.dwg
hardware/Документация/Чертежи/КВ33.044.900 - Клапан присоски впускной/КВ33.044.901 - Опора клапана присоски.dwg
hardware/Документация/Чертежи/КВ33.044.200 - Сборка зажима/КВ33.044.205 - Рычаг приводной 17 зубьев.dwg
hardware/Документация/Чертежи/КВ33.044.200 - Сборка зажима/КВ33.044.102 - Колесо зубчатое сервомотора.dwg
hardware/Документация/Чертежи/КВ33.044.200 - Сборка зажима/КВ33.044.202 -Прихват.dwg
hardware/Документация/Чертежи/КВ33.044.200 - Сборка зажима/КВ33.044.200 - Сборка зажима.dwg
hardware/Документация/Чертежи/КВ33.044.200 - Сборка зажима/КВ33.044.204 -Рычаг тонкий.dwg
hardware/Для изготовления/STL (печать)/КВ33.044.201 - Щека каретки Z.stl
hardware/Для изготовления/Печатная плата/Печатная плата управляющая/Печатная плата управляющая.ipt
hardware/Документация/Чертежи/OldVersions/Проставка 5 мм.0001.dwg
hardware/Документация/Чертежи/КВ33.044.100 - Захват/OldVersions/Боковина шкива уменьшанная.0001.dwg
hardware/Документация/Чертежи/КВ33.044.100 - Захват/OldVersions/КВ33.044.100 - Захват.0001.dwg
hardware/Документация/Чертежи/КВ33.044.100 - Захват/КВ33.044.101 - Опора захвата.idw
hardware/Документация/Чертежи/КВ33.044.200 - Сборка зажима/OldVersions/КВ33.044.102 - Колесо зубчатое сервомотора.0002.dwg
hardware/Документация/Чертежи/КВ33.044.200 - Сборка зажима/OldVersions/КВ33.044.201 - Опора зажимного механизма.0005.dwg
hardware/Документация/Чертежи/КВ33.044.200 - Сборка зажима/OldVersions/КВ33.044.202 -Прихват.0001.dwg
hardware/Документация/Чертежи/КВ33.044.200 - Сборка зажима/OldVersions/КВ33.044.203 - Рычаг толстый.0001.dwg
hardware/Документация/Чертежи/КВ33.044.200 - Сборка зажима/OldVersions/КВ33.044.206 - Рычаг приводной 16 зубьев.0001.dwg
hardware/Документация/Чертежи/КВ33.044.400 - Каретка оси Х/OldVersions/КВ33.044.401 - Щека каретки X.0002.dwg
hardware/Документация/Чертежи/КВ33.044.700 - Каретка оси Y/OldVersions/КВ33.044.700 - Каретка оси Y.0001.dwg
hardware/Документация/Чертежи/КВ33.044.800 - Каретка оси Y/OldVersions/КВ33.044.800 - Сборка держателя катка.0001.dwg
hardware/Документация/Чертежи/КВ33.044.900 - Клапан присоски впускной/OldVersions/КВ33.044.902 - Кулачок дисковый.0001.dwg
hardware/КВ33.044.000 - Сортирующая ячейка.iam
hardware/КВ33.044.001 - Дно.ipt
hardware/КВ33.044.002 - ограничитель перемещения по оси Z.ipt
hardware/КВ33.044.100 - Захват.iam
hardware/КВ33.044.1000 - Блок управления.iam
hardware/КВ33.044.1001 - Дно платы.ipt
hardware/КВ33.044.1002 - Плата распределительная.ipt
hardware/КВ33.044.1003 - Плата контроля сервомоторами.ipt
hardware/КВ33.044.101 - Опора захвата.ipt
hardware/КВ33.044.102 - Колесо зубчатое сервомотора.ipt
hardware/КВ33.044.200 - Сборка зажима.iam
hardware/КВ33.044.201 - Опора зажимного механизма.ipt
hardware/КВ33.044.202 -Прихват.ipt
hardware/КВ33.044.203 - Рычаг толстый.ipt
hardware/КВ33.044.204 -Рычаг тонкий.ipt
hardware/КВ33.044.205 - Рычаг приводной 17 зубьев.ipt
hardware/КВ33.044.206 - Рычаг приводной 16 зубьев.ipt
hardware/КВ33.044.207 - Крепление вакумной присоски.ipt
hardware/КВ33.044.208 - Зажим вакумной присоски.ipt
hardware/КВ33.044.300 - Каретка оси Z.iam
hardware/КВ33.044.301 - Щека каретки Z.ipt
hardware/КВ33.044.303 - Прижим ремня каретки Z.ipt
hardware/КВ33.044.304 - Держатель ремня.ipt
hardware/КВ33.044.305 - Прижим ремня.ipt
hardware/КВ33.044.400 - Каретка оси X.iam
hardware/КВ33.044.401 - Щека каретки X.ipt
hardware/КВ33.044.405 - Крепеж ремня оси Y.ipt
hardware/КВ33.044.406 - Прижим ремня.ipt
hardware/КВ33.044.407 - Заглушка разъема.ipt
hardware/КВ33.044.500 - Сборка сервомотора Dynamixel с крепление.iam
hardware/КВ33.044.501 - Деражатель мотора.ipt
hardware/КВ33.044.600 - Сборка сервомотора Dynamixel с крепление обратный.iam
hardware/КВ33.044.601 - Деражатель мотора обратный.ipt
hardware/КВ33.044.700 - Каретка оси Y.iam
hardware/КВ33.044.701 - Щека каретка оси Y.ipt
hardware/КВ33.044.702 - Стойка натягивающих роликов оси Y.ipt
hardware/КВ33.044.703 - Стойка оптического датчика оси Y.ipt
hardware/КВ33.044.704 - Панель установки принимающей платы оси Y.ipt
hardware/КВ33.044.800 - Сборка держателя катка.iam
hardware/КВ33.044.800 - Шкив плоский Makeblock сборка.iam
hardware/КВ33.044.801 - Держатель катка.ipt
hardware/КВ33.044.900 - Клапан присоски впускной.iam
hardware/КВ33.044.901 - Опора клапана присоски.ipt
hardware/КВ33.044.902 - Кулачок дисковый.ipt
hardware/Стандартные изделия/OldVersions/Боковина шкива уменьшанная.0009.ipt
hardware/Стандартные изделия/OldVersions/Боковина шкива.0004.ipt
hardware/Стандартные изделия/OldVersions/Винт М5х10 с потайной головкой.0004.ipt
hardware/Стандартные изделия/OldVersions/Винт М8х25 с потайной головкой.0004.ipt
hardware/Стандартные изделия/OldVersions/Датчик оптический (с контактами с противоположной стороны).0005.ipt
hardware/Стандартные изделия/OldVersions/Датчик оптический (стандартный).0005.ipt
hardware/Стандартные изделия/OldVersions/Датчик оптический с измененными контактами.0006.ipt
hardware/Стандартные изделия/OldVersions/Датчик оптический стандартный.0006.ipt
hardware/Стандартные изделия/OldVersions/Колесо оптического датчика.0019.ipt
hardware/Стандартные изделия/OldVersions/Концевик механический.0007.ipt
hardware/Стандартные изделия/OldVersions/Оптический датчик (с контактами с противоположной стороны).0004.ipt
hardware/Стандартные изделия/OldVersions/Оптический датчик.0002.ipt
hardware/Стандартные изделия/OldVersions/Подшипник 4x8x3.0011.ipt
hardware/Стандартные изделия/OldVersions/Подшипник 624Z.0008.ipt
hardware/Стандартные изделия/OldVersions/Подшипник 626Z.0006.ipt
hardware/Стандартные изделия/OldVersions/Проставка 4 мм.0006.ipt
hardware/Стандартные изделия/OldVersions/Проставка 5 мм.0002.ipt
hardware/Стандартные изделия/OldVersions/Проставка 5.5 мм.0003.ipt
hardware/Стандартные изделия/OldVersions/Проставка 6.5 мм.0010.ipt
hardware/Стандартные изделия/OldVersions/Профиль станочный 30x30x717.0008.ipt
hardware/Стандартные изделия/OldVersions/Профиль станочный 30x30x720.0006.ipt
hardware/Стандартные изделия/OldVersions/Профиль станочный 30x30x728.0003.ipt
hardware/Стандартные изделия/OldVersions/Профиль станочный 30x30x740.0006.ipt
hardware/Стандартные изделия/OldVersions/Угол соединительный 30х30х30.0009.ipt
hardware/Стандартные изделия/OldVersions/Шаговый двигатель Makeblock.0001.ipt
hardware/Стандартные изделия/OldVersions/Шаговый двигатель Makeblock.ipt
hardware/Стандартные изделия/OldVersions/Шаговый двигатель Nema 17.ipt
hardware/Стандартные изделия/OldVersions/Шкив большой Makeblock.0003.ipt
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
