Kvantorium-33/optimal_gripper/hardware/Документация/Чертежи/КВ33.044.300 - Каретка оси Z/КВ33.044.300 - Каретка оси Z.pdf

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

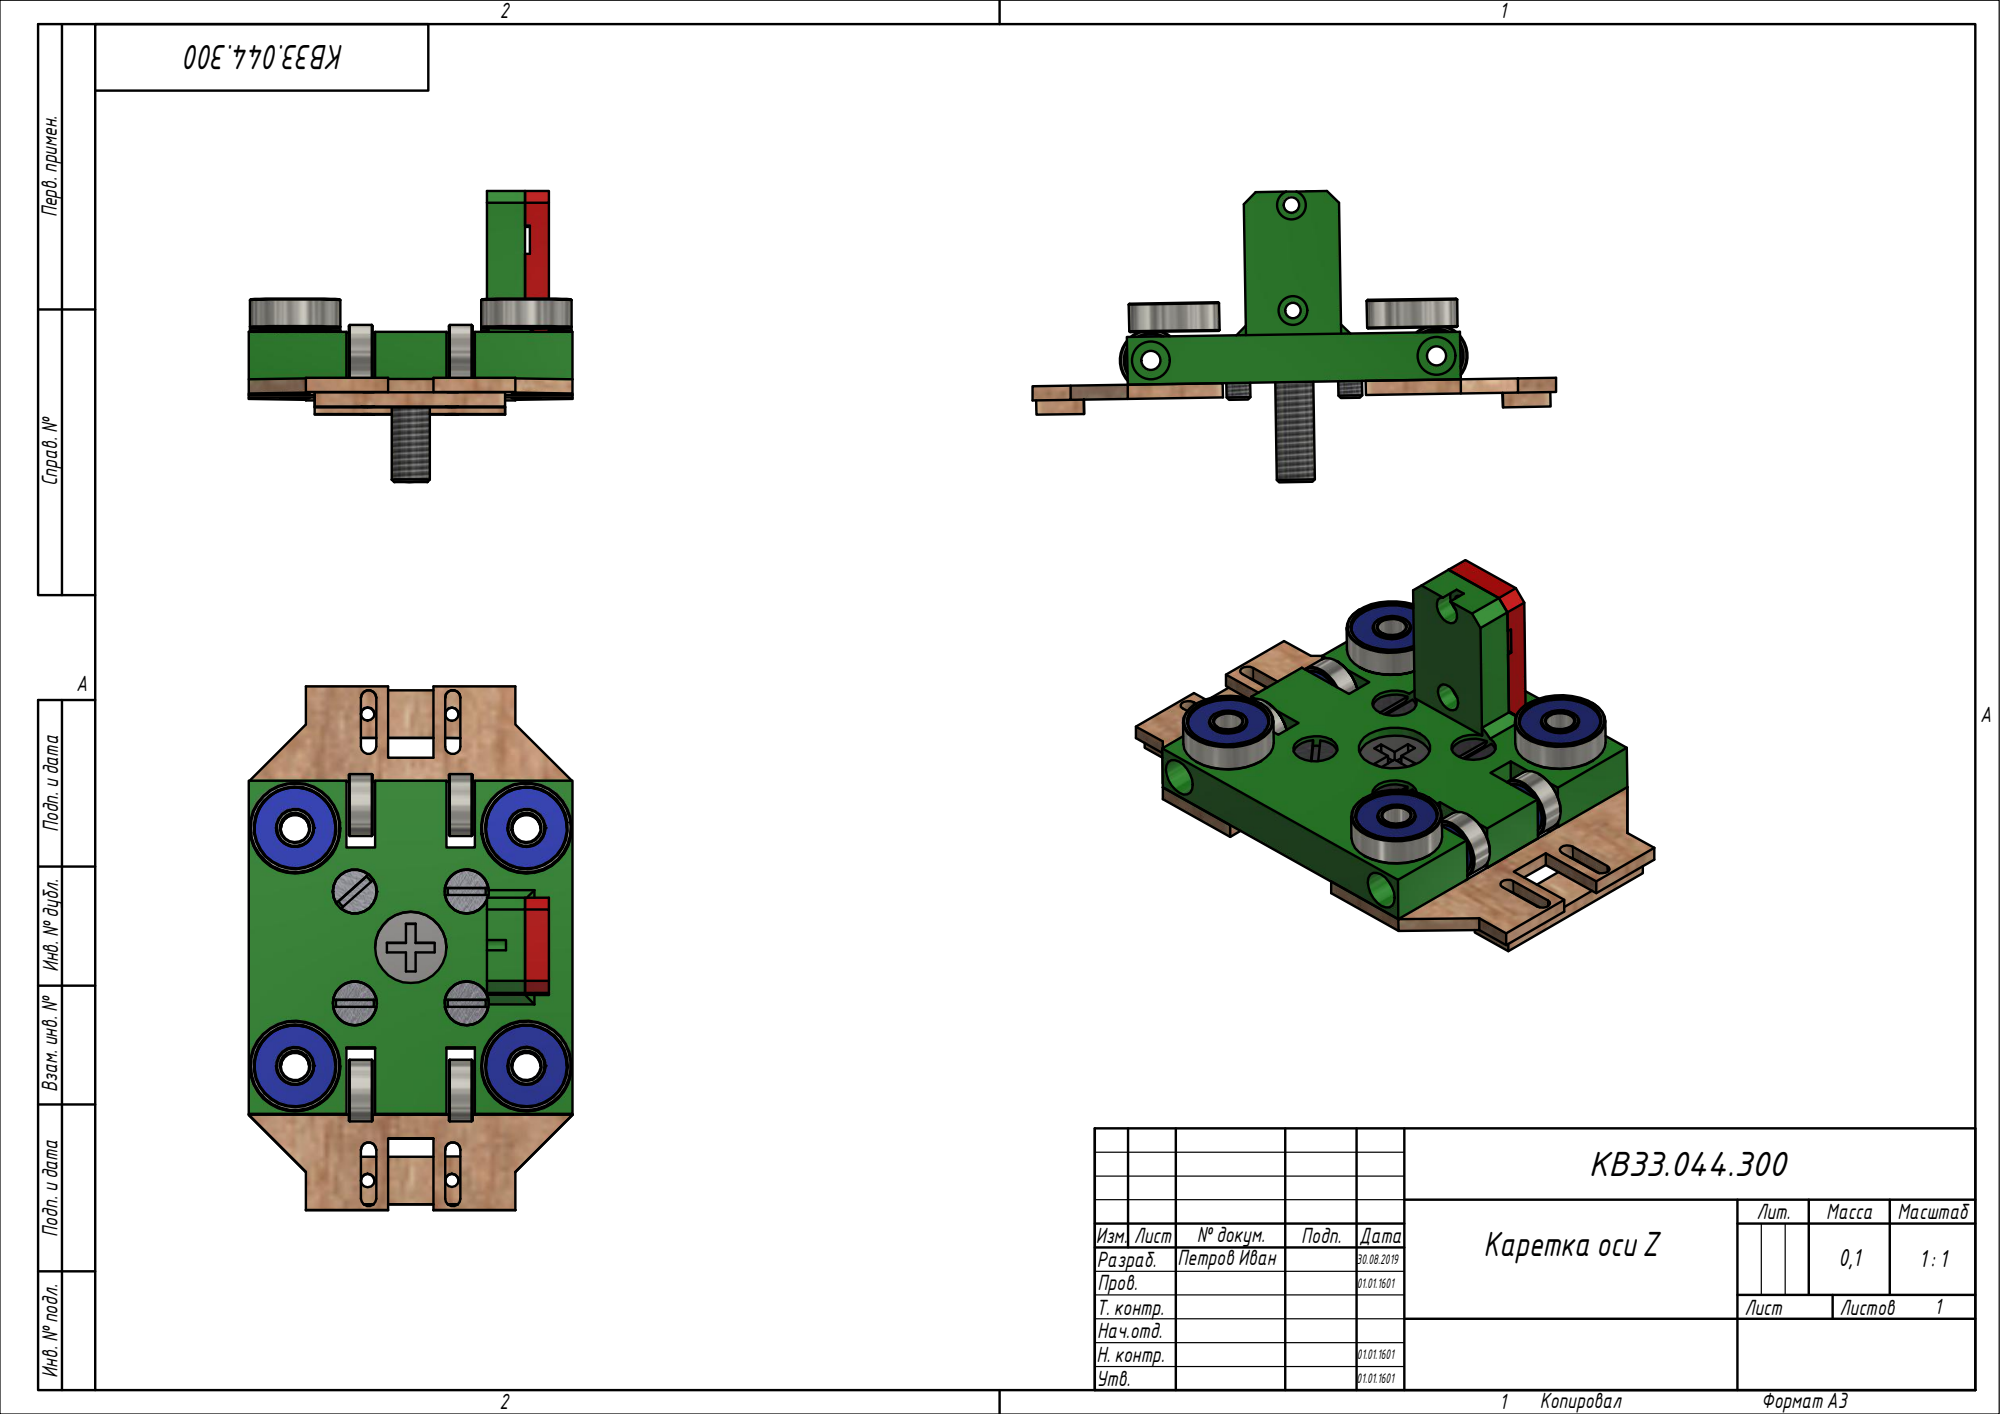
[picture p58: page 1]
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
