Kvantorium-33/optimal_gripper/hardware/Документация/Чертежи/КВ33.044.400 - Каретка оси Х/КВ33.044.400 - Каретка оси X.pdf

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

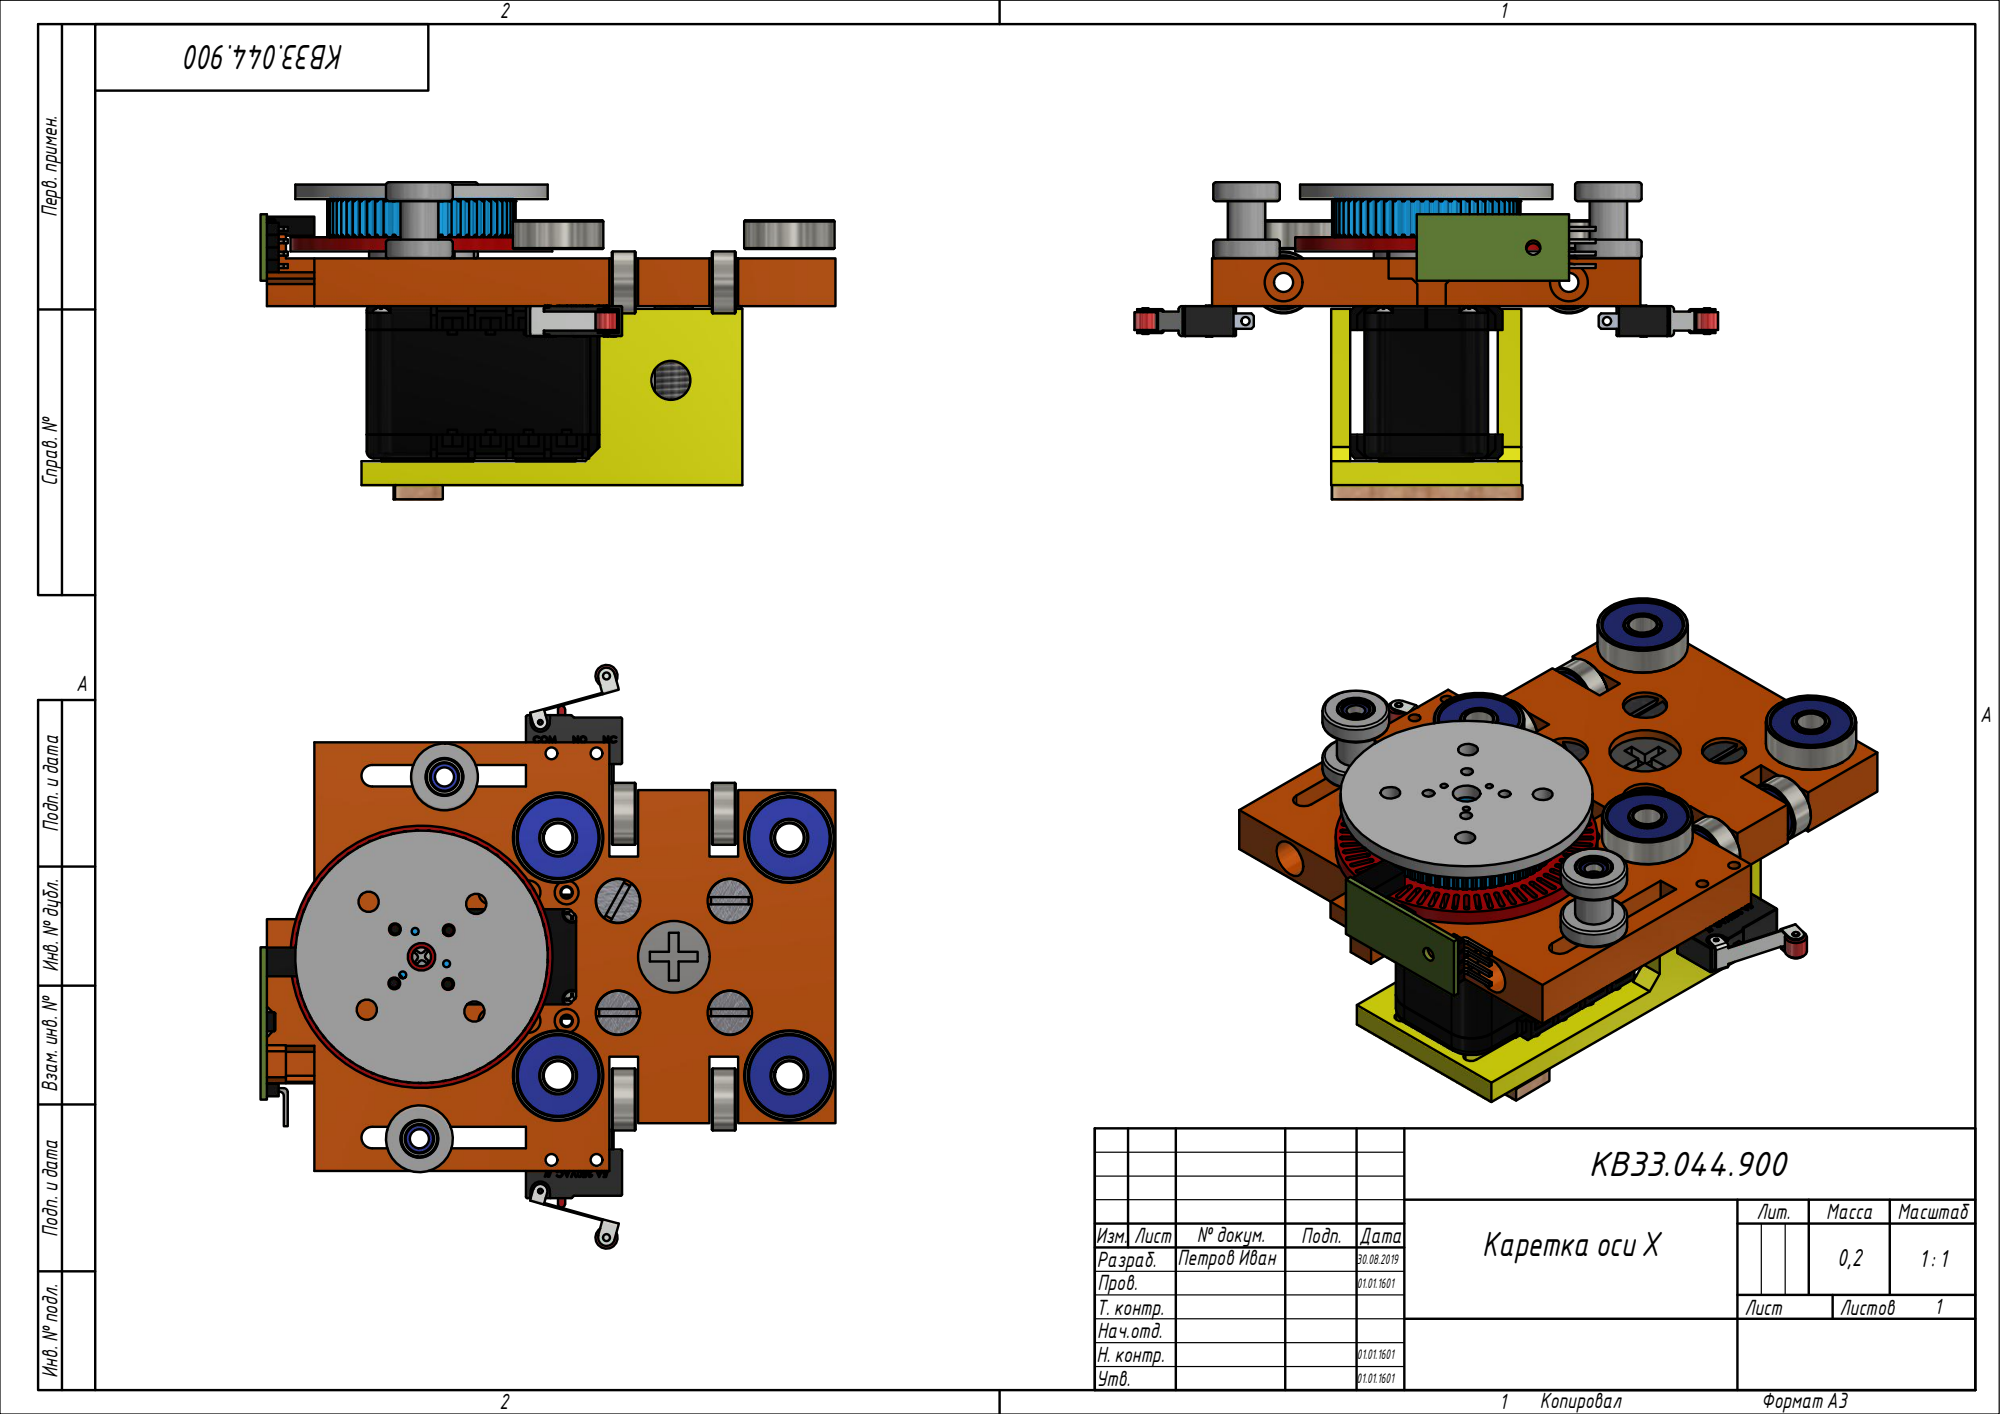
[picture p59: page 1]
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
