Kvantorium-33/optimal_gripper/hardware/Документация/Чертежи/КВ33.044.500 - Сборка сервомотора с креплением/КВ33.044.500 -  Сборка сервомотора Dynamixel с крепление.pdf

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

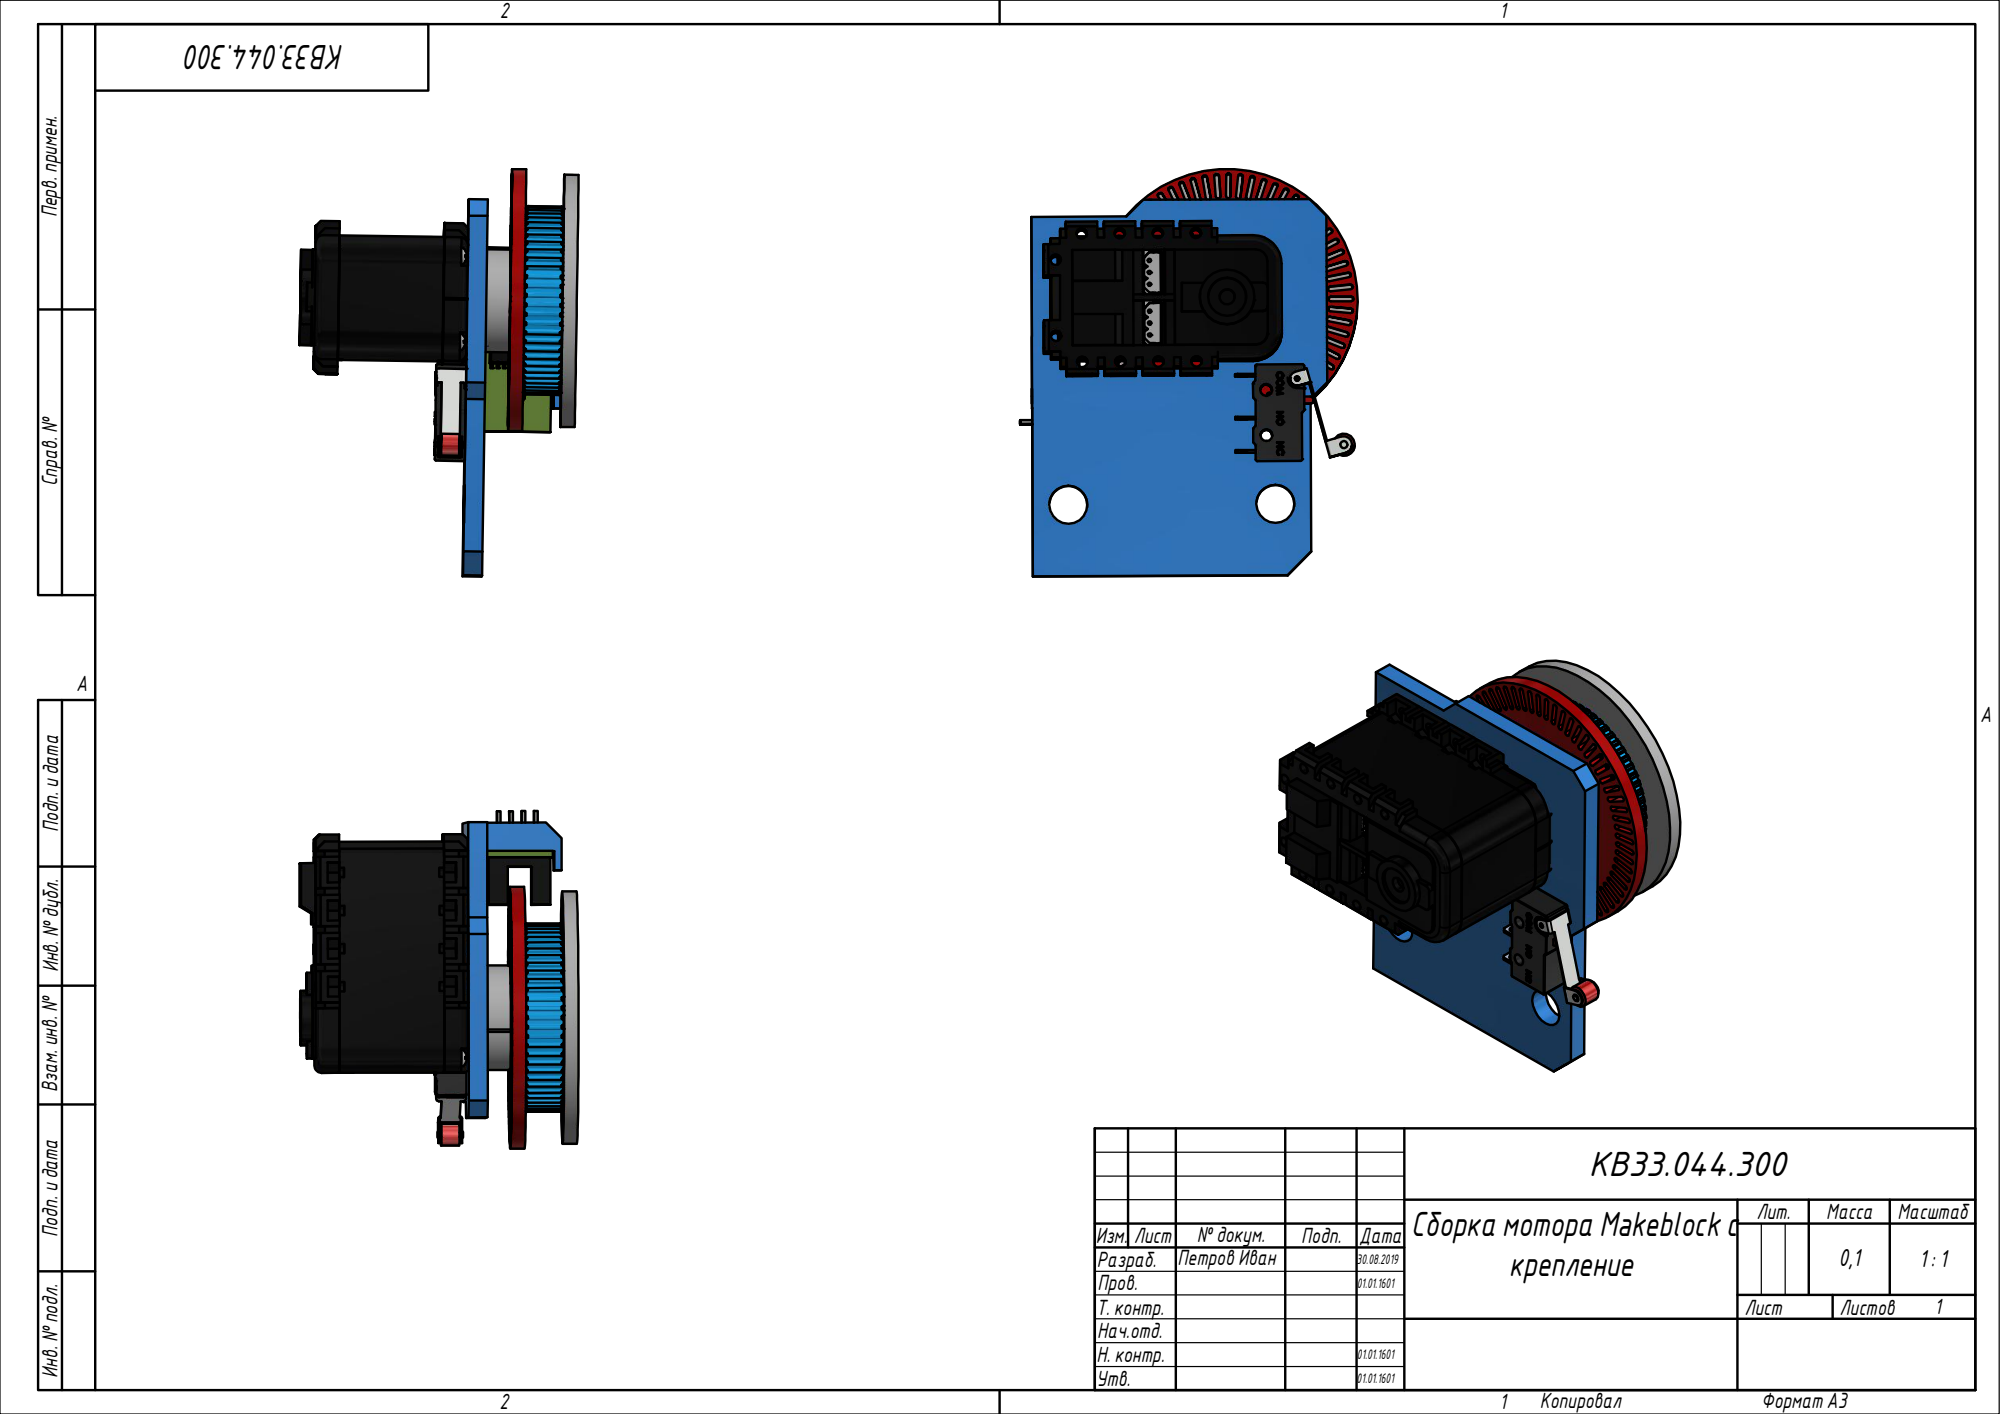
[picture p60: page 1]
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
