Kvantorium-33/optimal_gripper/hardware/Документация/Чертежи/КВ33.044.600 - Сборка сервомотора с креплением обратная/КВ33.044.600 -  Сборка сервомотора Dynamixel с крепление обратный.pdf

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

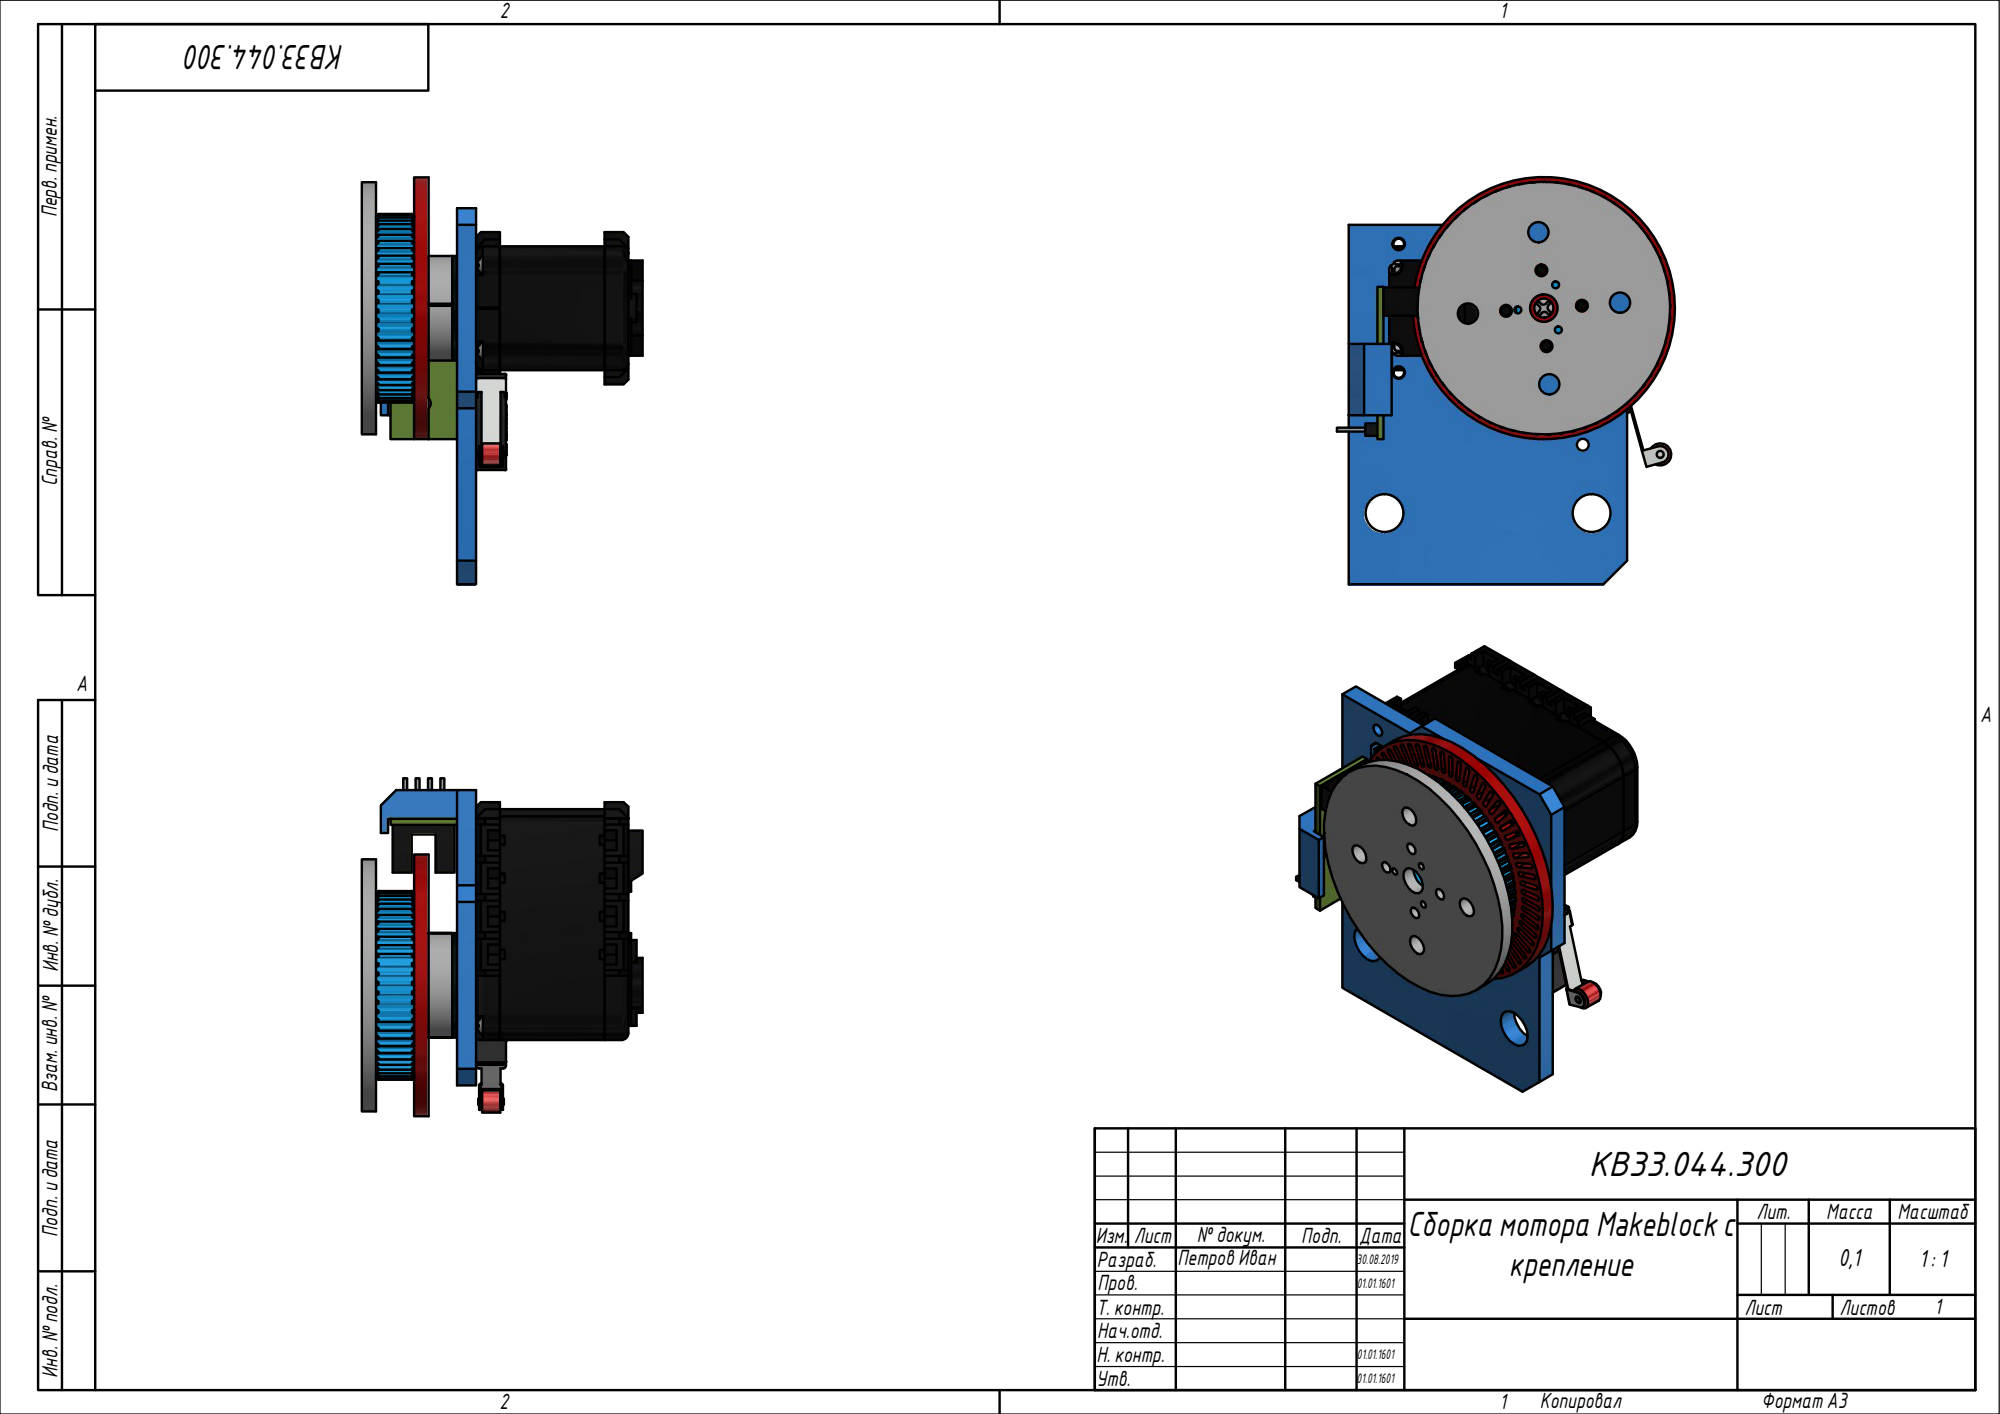
[picture p61: page 1]
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
