Kvantorium-33/optimal_gripper/hardware/Документация/Чертежи/КВ33.044.700 - Каретка оси Y/КВ33.044.700 - Каретка оси Y.pdf

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

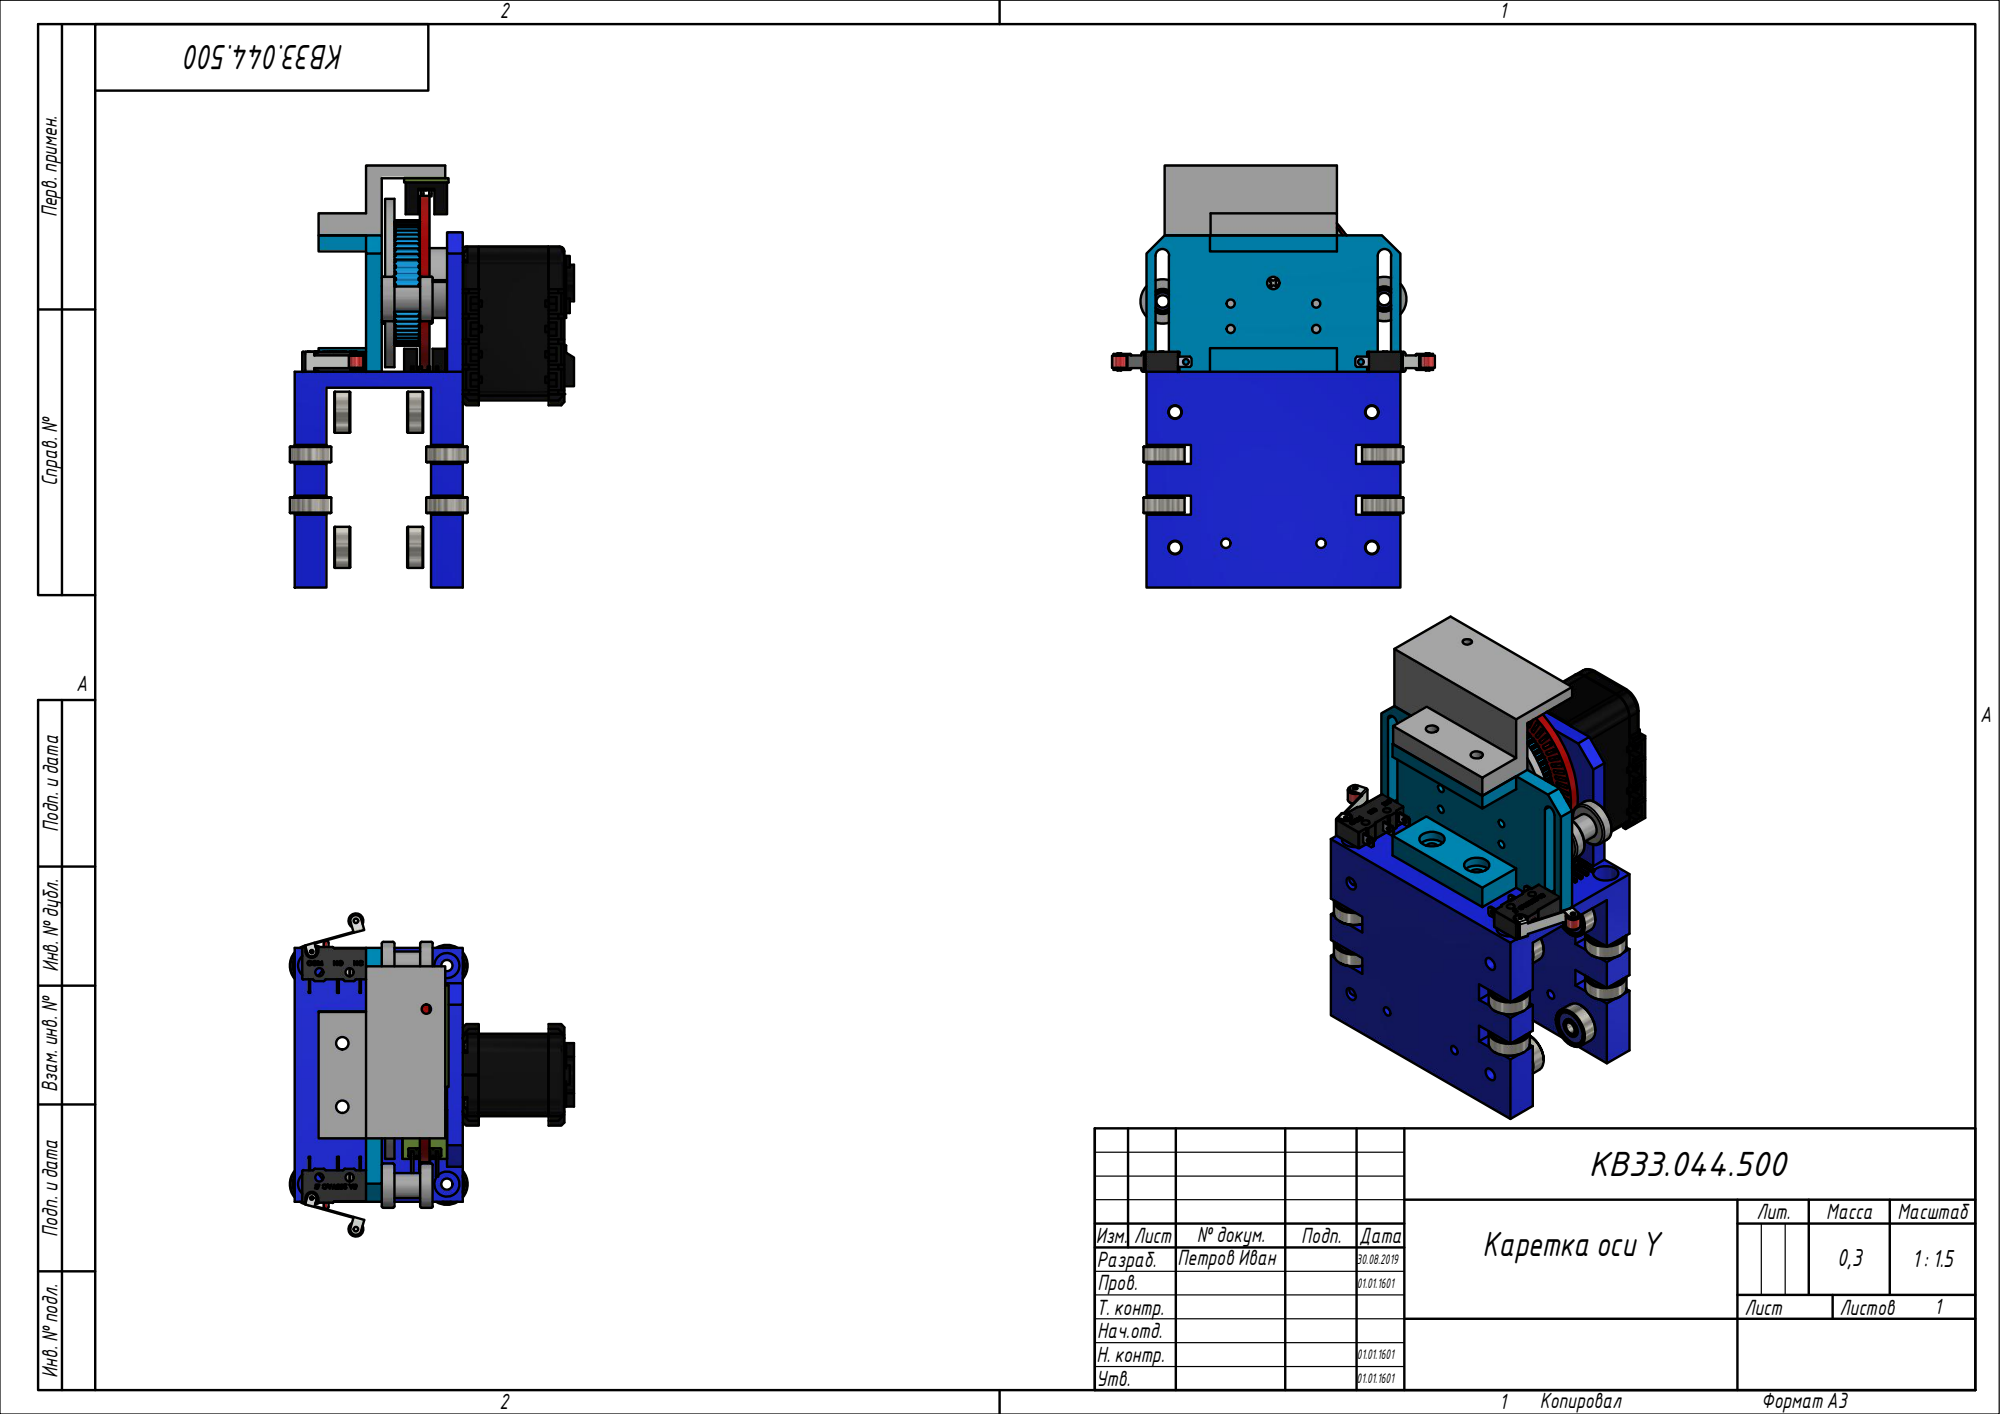
[picture p62: page 1]
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
