Kvantorium-33/optimal_gripper/hardware/Документация/Чертежи/КВ33.044.800 - Каретка оси Y/КВ33.044.800 - Сборка держателя катка.pdf

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

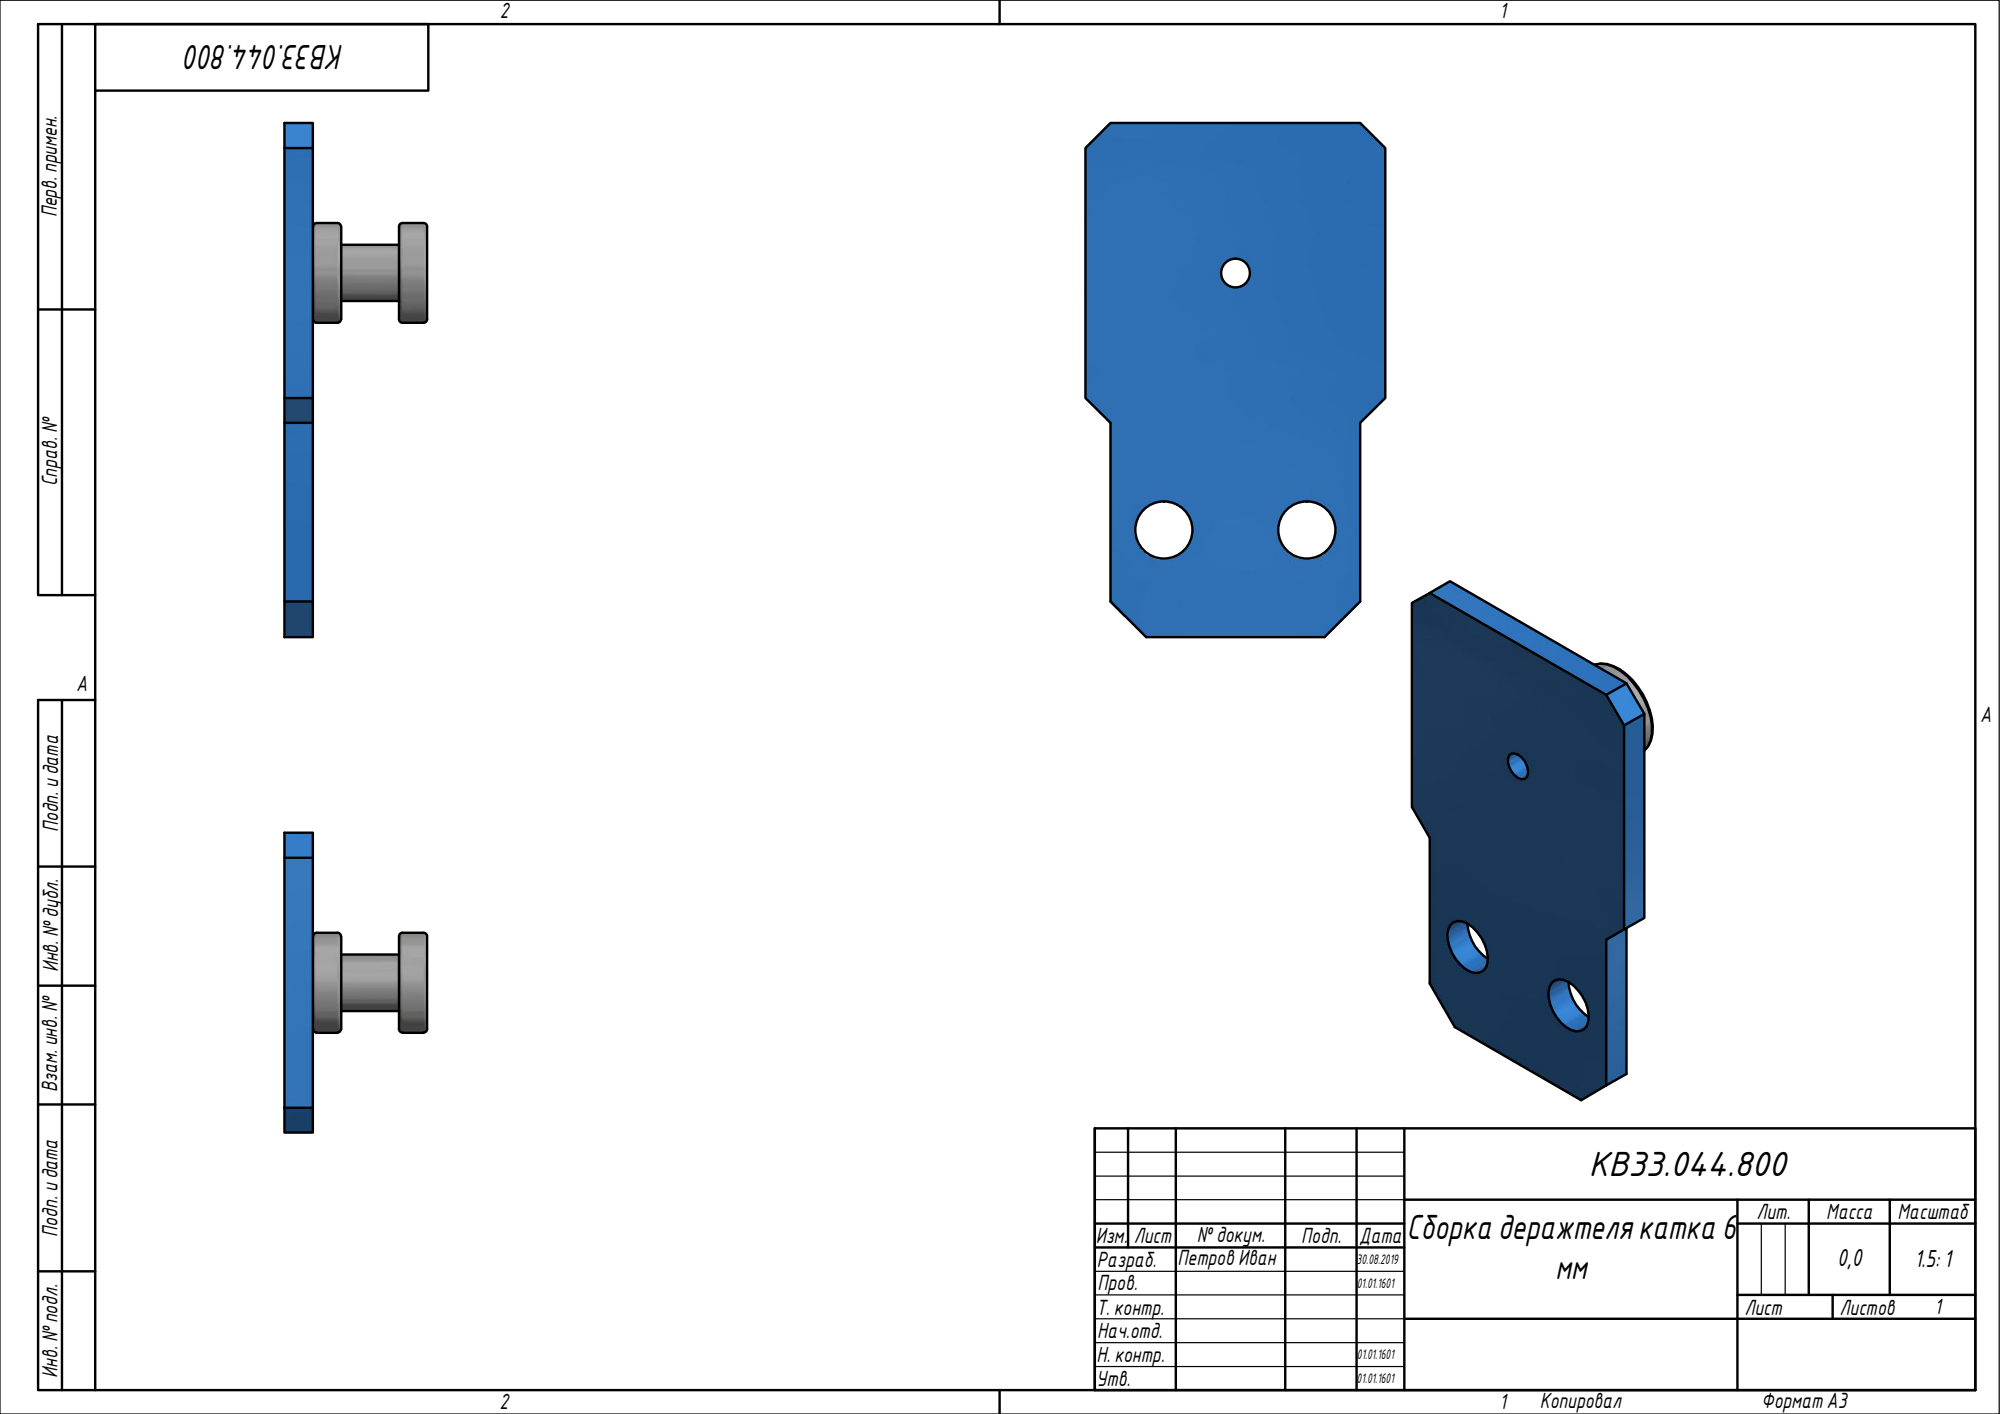
[picture p63: page 1]
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
