Kvantorium-33/optimal_gripper/hardware/Документация/Чертежи/КВ33.044.900 - Клапан присоски впускной/КВ33.044.900 - Клапан присоски впускной.pdf

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

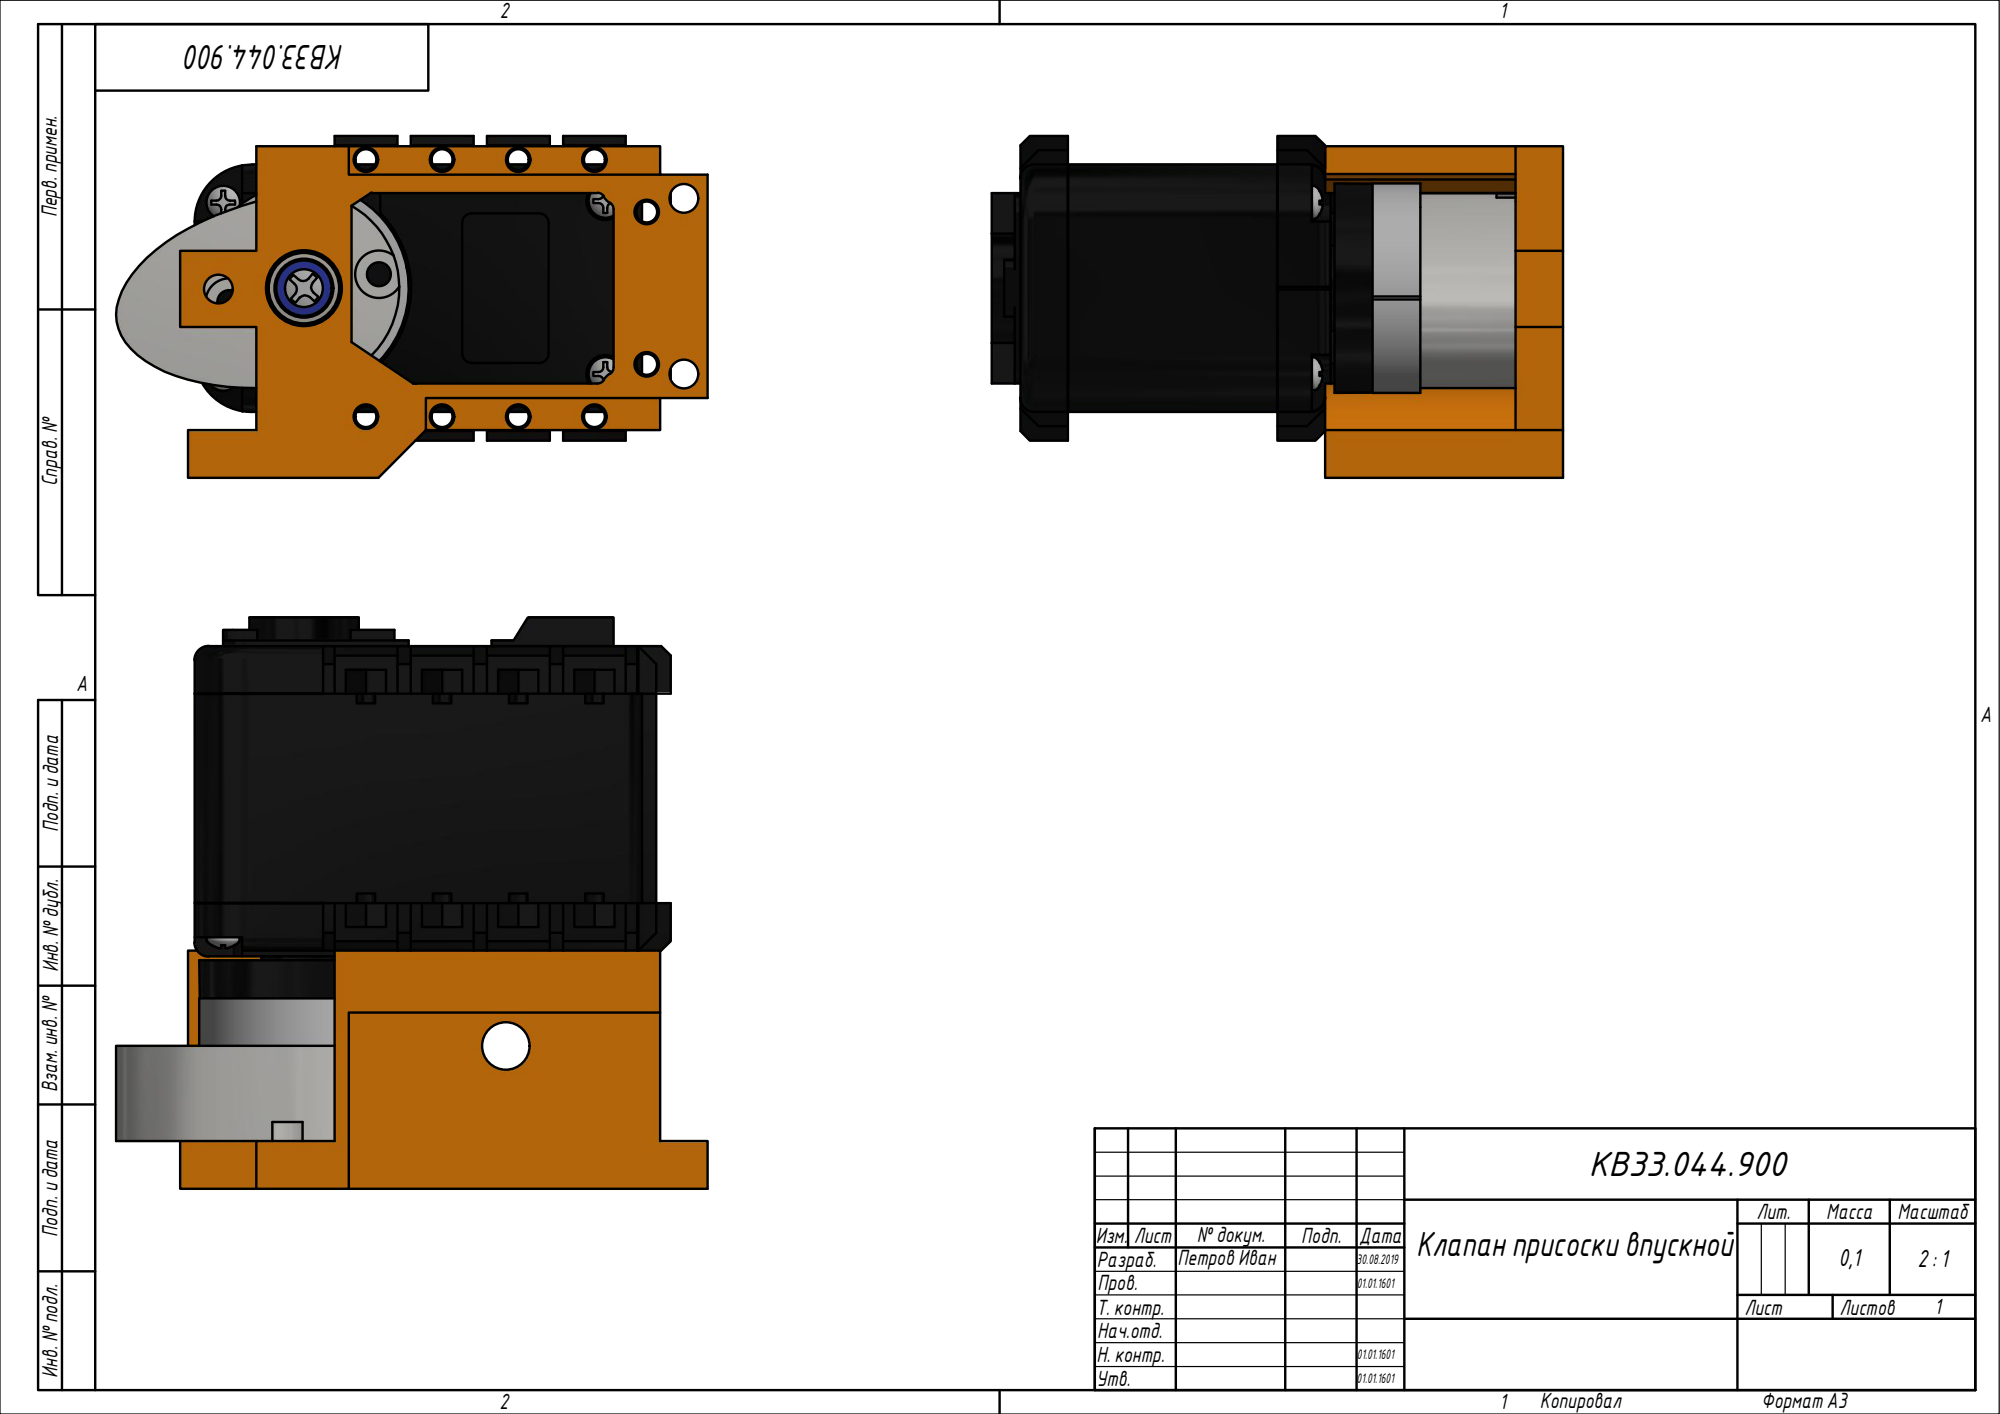
[picture p64: page 1]
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
