Kvantorium-33/optimal_gripper/hardware/Для изготовления/Печатная плата/Mega shield/untitled.brd

## EAGLE design hardware/Для изготовления/Печатная плата/Mega shield/untitled.brd (2019-10-30)

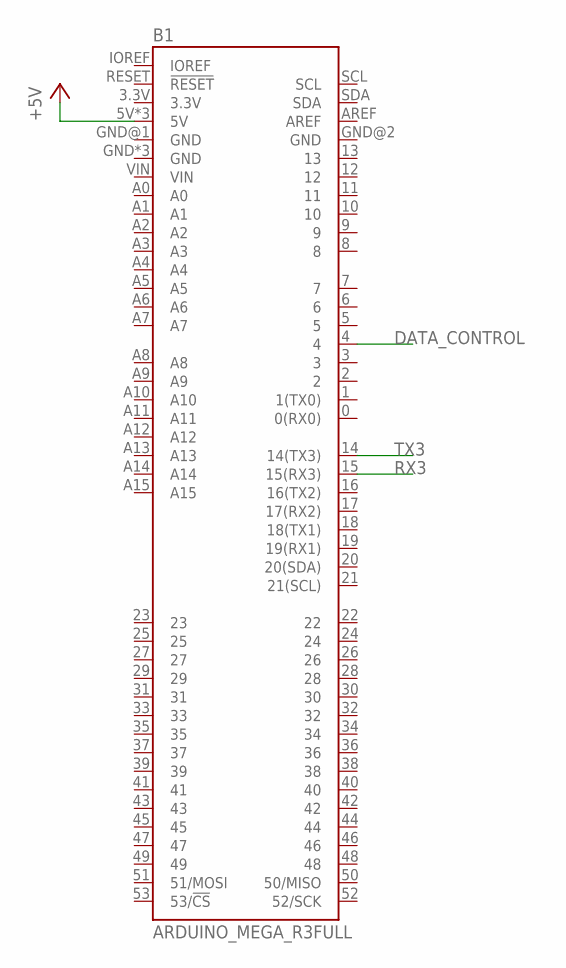
[picture p65: schematic untitled.sch, sheet 1]

Parts:
B1: ARDUINO_MEGA_R3FULL; ARDUINO_MEGA_NO_SILK

Connections:
+5V: B1.5V, B1.5V@1 (5V), B1.5V@2 (5V); also elsewhere on the board
DATA_CONTROL: B1.4; also elsewhere on the board
RX3: B1.15 (15(RX3)); also elsewhere on the board
TX3: B1.14 (14(TX3)); also elsewhere on the board

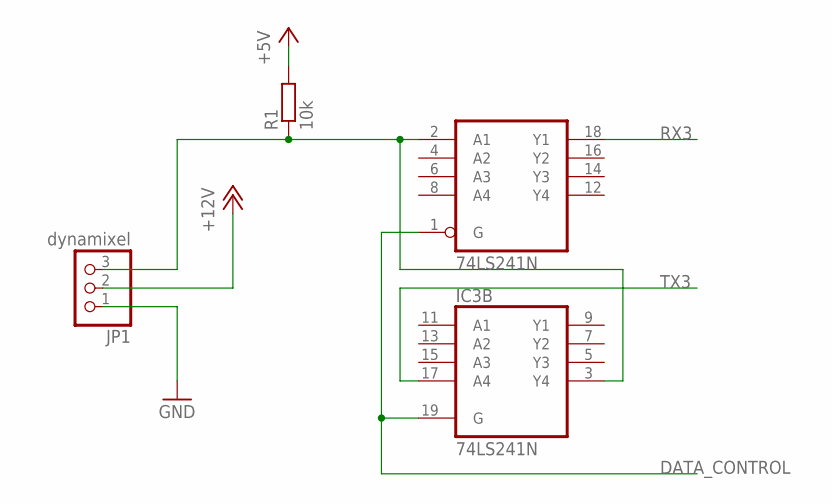
[picture p66: schematic untitled.sch, sheet 2]

Parts:
IC3: 74LS241N; DIL20
JP1: dynamixel; 1X03
R1: 10k; 0207/10

Connections:
+5V: R1.2; also elsewhere on the board
+12V: JP1.2
DATA_CONTROL: IC3.1 (G), IC3.19 (G); also elsewhere on the board
GND: IC3.10 (GND), JP1.1
unnamed: IC3.2 (A1), IC3.3 (Y4), JP1.3, R1.1
RX3: IC3.18 (Y1); also elsewhere on the board
TX3: IC3.17 (A4); also elsewhere on the board
VCC: IC3.20 (VCC)

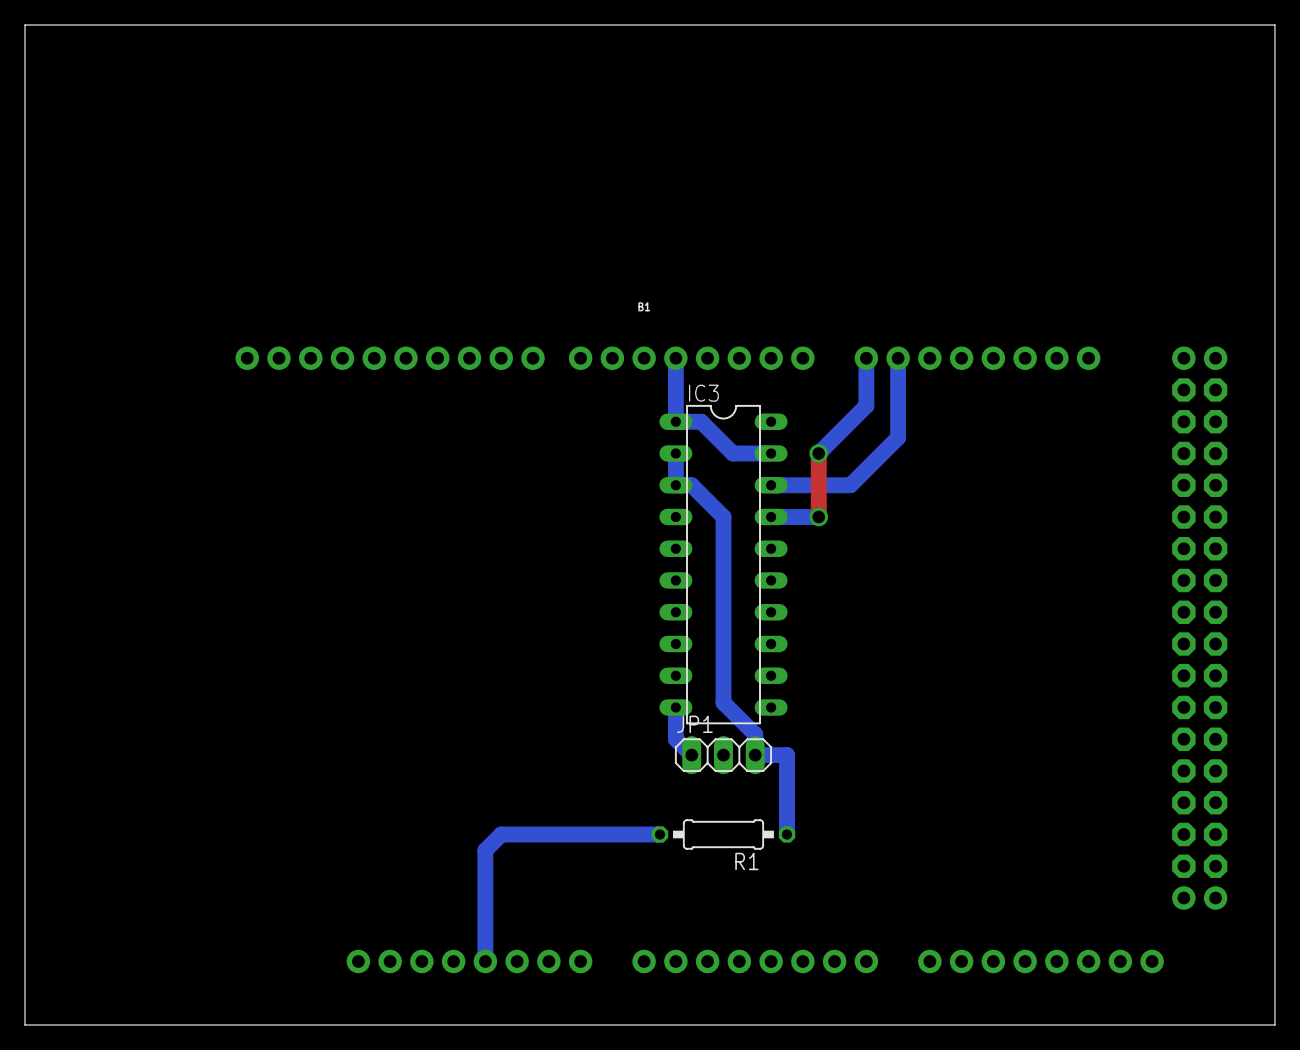
[picture p67: board untitled.brd from above]

Board: 2 copper layers, 100.0 x 80.0 mm, 4 parts (0 on the bottom side), 6 nets.
