Kvantorium-33/optimal_gripper/hardware/Для изготовления/Печатная плата/Печатная плата принимающая ось Y/Печатная плата принимающая ось Y.brd

## EAGLE design hardware/Для изготовления/Печатная плата/Печатная плата принимающая ось Y/Печатная плата принимающая ось Y.brd (2019-10-25)

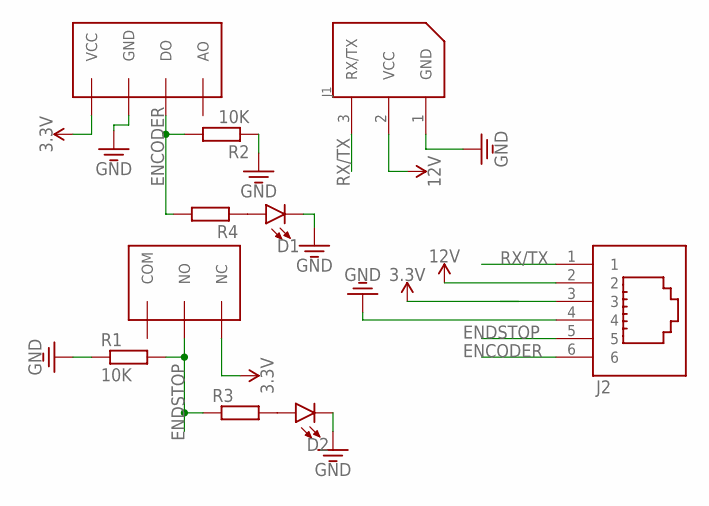
[picture p68: schematic Печатная плата принимающая ось Y.sch]

Parts:
D1, D2: LED5MM; LED_5MM
J1: 22-03-5035; 5267-3
J2: 615006138421
R1, R2: 10K; 0204/7
R3, R4: R-EU_0204/7; 0204/7
U$1: OPTICAL_ENCODER_FC-01
U$2: ENDSTOP

Connections:
3.3V: J2.3, U$1.VCC, U$2.NC
12V: J1.2 (VCC), J2.2
ENCODER: J2.6, R2.2, R4.2, U$1.DO
ENDSTOP: J2.5, R1.2, R3.1, U$2.NO
GND: D1.K (C), D2.K (C), J1.1 (GND), J2.4, R1.1, R2.1, U$1.GND
unnamed: D2.A, R3.2
unnamed: D1.A, R4.1
RX/TX: J1.3 (RX/TX), J2.1

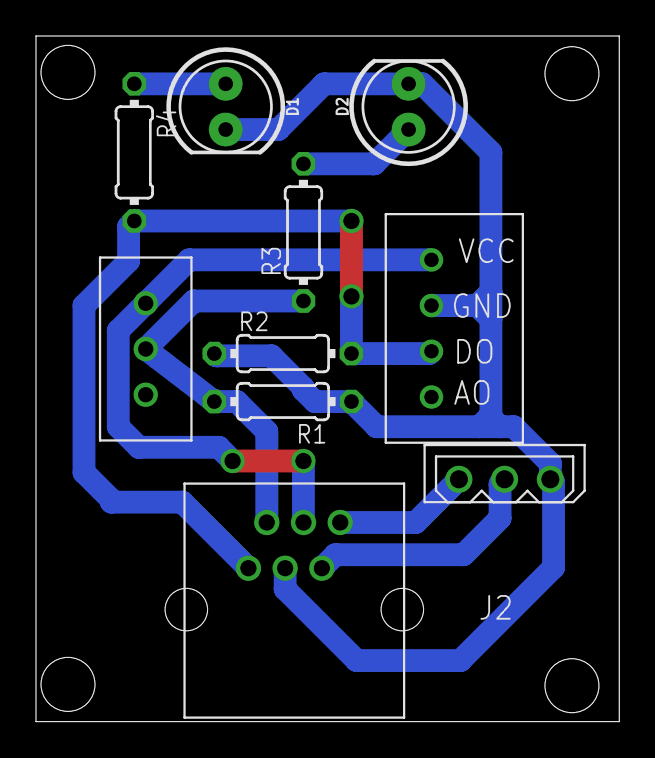
[picture p69: board Печатная плата принимающая ось Y.brd from above]

Board: 2 copper layers, 32.4 x 38.1 mm, 10 parts (0 on the bottom side), 8 nets.
