Kvantorium-33/optimal_gripper/hardware/Для изготовления/Печатная плата/Печатная плата управляющая/Печатная плата управляющая.brd

## EAGLE design hardware/Для изготовления/Печатная плата/Печатная плата управляющая/Печатная плата управляющая.brd (2019-08-27)

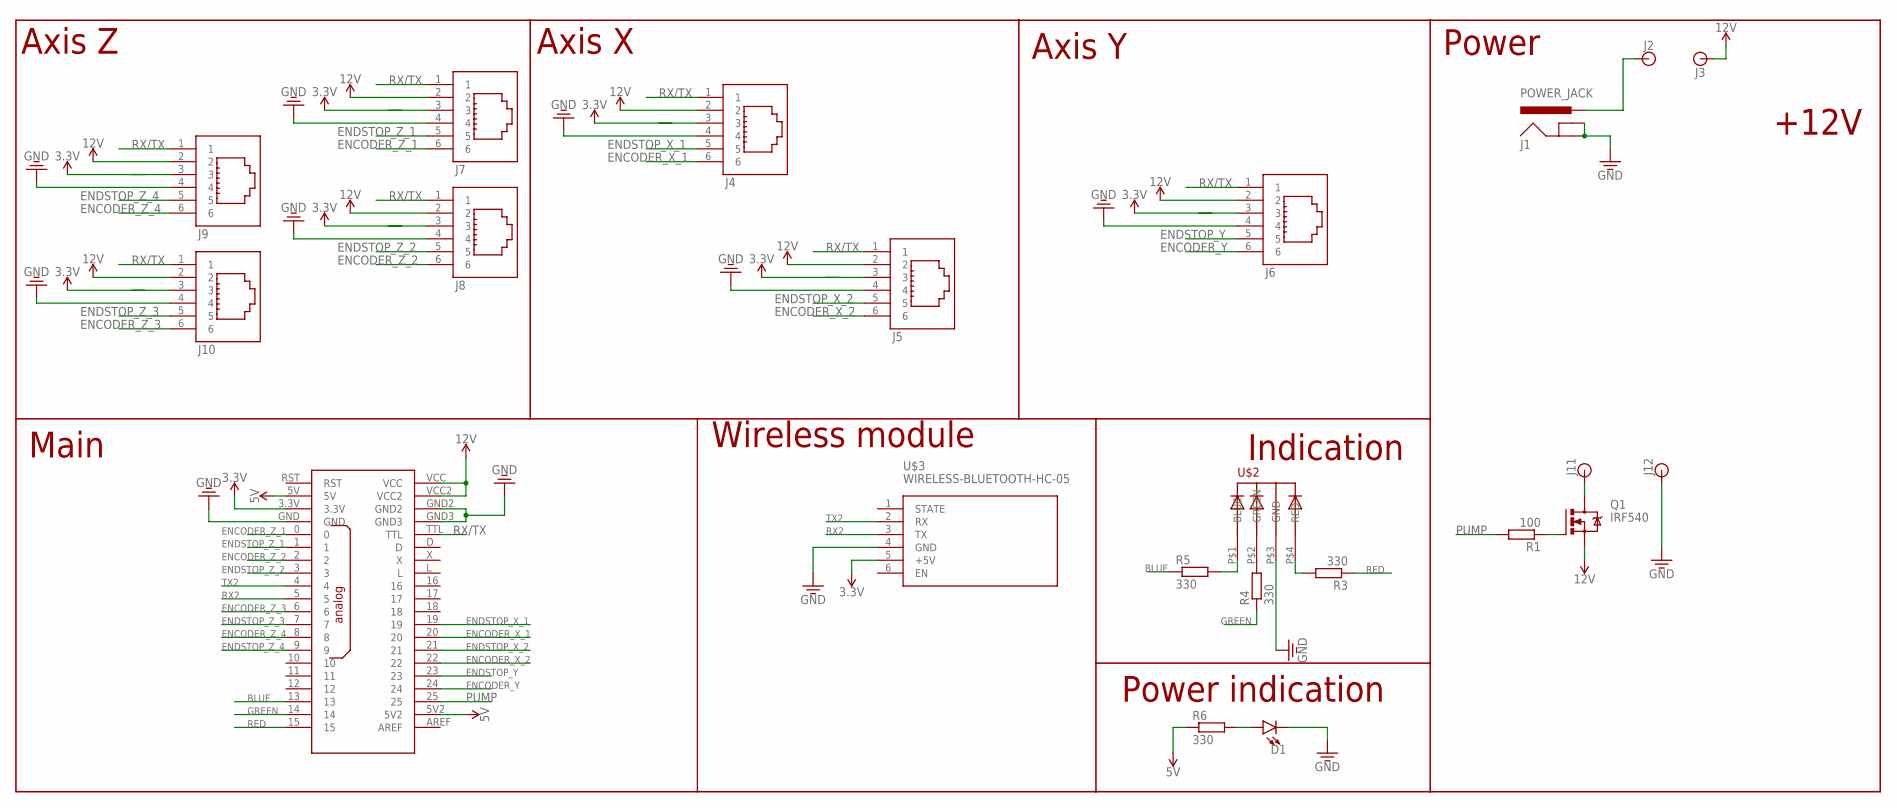
[picture p70: schematic Печатная плата управляющая.sch]

Parts:
D1: LED5MM; LED_5MM
J1: POWER_JACK; POWER_JACK_PTH
J2, J3, J11, J12: BANANA_CONN
J4, J5, J6, J7, J8, J9, J10: 615006138421
Q1: IRF540; TO220BV
R1: 100; 0204/7
R3, R4, R5, R6: 330; 0204/7
U$1: OPENCM9.04
U$2: 5MMRGBLED; LED5MMRGB
U$3: WIRELESS-BLUETOOTH-HC-05

Connections:
3.3V: J4.3, J5.3, J6.3, J7.3, J8.3, J9.3, J10.3, U$1.3.3V, U$3.5 (+5V)
5V: R6.1, U$1.5V, U$1.5V2
12V: J3.P$1, J4.2, J5.2, J6.2, J7.2, J8.2, J9.2, J10.2, Q1.S, U$1.VCC, U$1.VCC2
BLUE: R5.1, U$1.13
ENCODER_X_1: J4.6, U$1.20
ENCODER_X_2: J5.6, U$1.22
ENCODER_Y: J6.6, U$1.24
ENCODER_Z_1: J7.6, U$1.0
ENCODER_Z_2: J8.6, U$1.2
ENCODER_Z_3: J10.6, U$1.6
ENCODER_Z_4: J9.6, U$1.8
ENDSTOP_X_1: J4.5, U$1.19
ENDSTOP_X_2: J5.5, U$1.21
ENDSTOP_Y: J6.5, U$1.23
ENDSTOP_Z_1: J7.5, U$1.1
ENDSTOP_Z_2: J8.5, U$1.3
ENDSTOP_Z_3: J10.5, U$1.7
ENDSTOP_Z_4: J9.5, U$1.9
GND: D1.K (C), J1.GND, J1.GNDBREAK, J4.4, J5.4, J6.4, J7.4, J8.4, J9.4, J10.4, J12.P$1, U$1.GND, U$1.GND2, U$1.GND3, U$2.P$3 (GND), U$3.4 (GND)
GREEN: R4.1, U$1.14
unnamed: J11.P$1, Q1.D
unnamed: R4.2, U$2.P$2 (GREEN)
unnamed: Q1.G, R1.1
unnamed: R5.2, U$2.P$1 (BLUE)
unnamed: R3.2, U$2.P$4 (RED)
unnamed: D1.A, R6.2
unnamed: J1.PWR, J2.P$1
PUMP: R1.2, U$1.25
RED: R3.1, U$1.15
RX2: U$1.5, U$3.3 (TX)
RX/TX: J4.1, J5.1, J6.1, J7.1, J8.1, J9.1, J10.1, U$1.TTL
TX2: U$1.4, U$3.2 (RX)

Notes on the sheet:
Axis Z
Axis X
Axis Y
Main
Power
+12V
Indication
Power indication
Wireless module

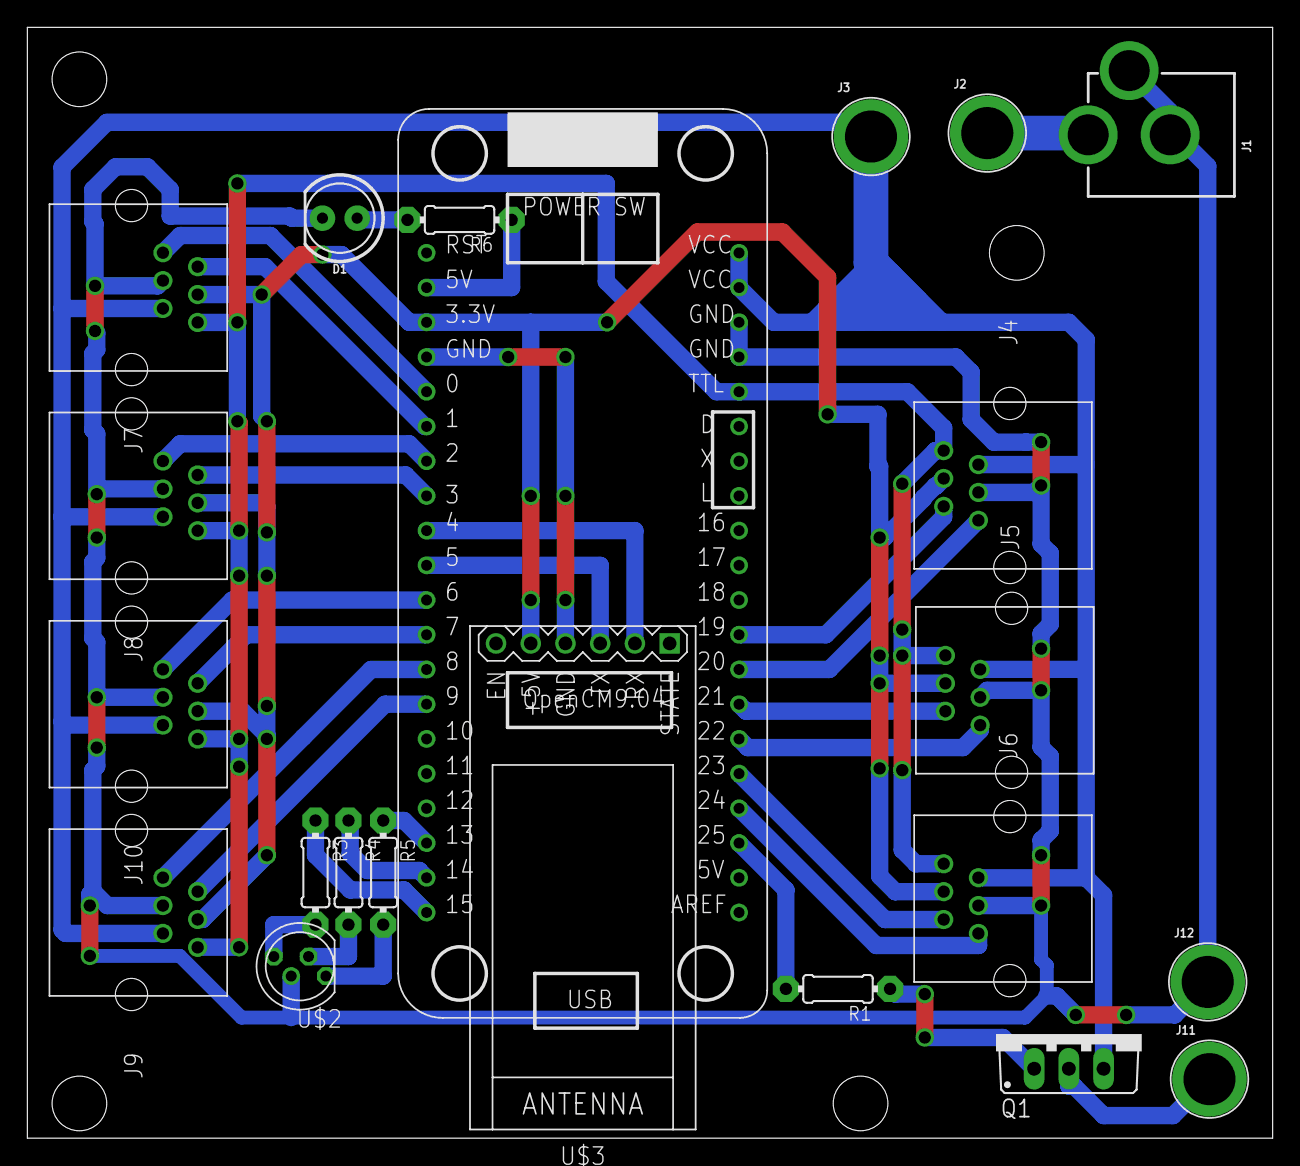
[picture p71: board Печатная плата управляющая.brd from above]

Board: 2 copper layers, 91.1 x 81.3 mm, 22 parts (0 on the bottom side), 32 nets.
