Kvantorium-33/optimal_gripper/firmware/Kvantoriada_STM32duino/Kvantoriada_STM32duino.ino

#include <ros.h> //  БИБЛИОТЕКА ПОДКЛЮЧЕНИЯ К ВЫСШЕЙ СИЛЕ (ROS)
#include <DynamixelSerial3.h> // БИБЛИОТЕКА ДЛЯ УПРАВЛЕНИЯ ДИНАМИКСЕЛЯМИ
#define DXL_baud 1000000 // СКОРОСТЬ СВЯЗИ С ДИНАМИКСЕЛЯМИ
// ВЫБОР ПОСЛЕДОВАТЕЛЬНО ПОРТА ДЛЯ ОТЛАДКИ
#define COM Serial
//#define COM Serial1
#define COM_baud 115200 // СКОРОСТЬ ПОСЛЕДОВАТЕЛЬНОГО ПОРТА

// ПАРАМЕТРЫ РАБОЧЕГО ПРОСТРАНСТВА
#define WS_X_size 710 // РАЗМЕР РАБОЧЕГО ПРОСТРАНСТВА ПО ОСИ X
#define WS_Y_size 635 // РАЗМЕР РАБОЧЕГО ПРОСТРАНСТВА ПО ОСИ Y
#define WS_Z_size 740 // РАЗМЕР РАБОЧЕГО ПРОСТРАНСТВА ПО ОСИ Z


#define Wheel_deametr 55 // ДИАМЕТР КОЛЕСА ЭНКОДЕРА
#define Wheel_tiks 65 // КОЛИЧЕСТВО ТИКОВ КОЛЕСА ЭНКОДЕРА НА ОБОРОТ
const double Wheel_long = Wheel_deametr * PI;

const int ws_Size[3] = {WS_X_size, WS_Y_size, WS_Z_size};         // МАССИВ РАЗМЕРОВ РАБОЧЕГО ПРОСТРАНСТВА (ФОРМАТ: XYZ)

float lenth[3] = {0.0, 0.0, 0.0}; 

float nextPos[3] = {0.0, 0.0, 0.0}; // МАССИВ СЛЕДУЮЩЕЙ ПОЗИЦИИ ГОЛОВЫ РОБОТА (ФОРМАТ: XYZ)
float currPos[3] = {0.0, 0.0, 0.0}; // МАССИВ ТЕКУЩЕЙ ПОЗИЦИИ ГОЛОВЫ РОБОТА (ФОРМАТ: XYZ)
float lastPos[3] = {0.0, 0.0, 0.0}; // МАССИВ ПРЕДЫДУЩЕЙ ПОЗИЦИИ ГОЛОВЫ РОБОТА (ФОРМАТ: XYZ)

// ПЕРЕМЕННЫЕ ДЛЯ ВЫБОРА ОСЕЙ В ФУНКЦИЯХ И ТРОЙНЫХ МАССИВАХ
#define _X_ 0
#define _Y_ 1
#define _Z_ 2
// ПЕРЕМЕННЫЕ ДЛЯ ВЫБОРА РЕЖИМА ПЕРЕМЕЩЕНИЯ ОСЕЙ (МАКС, МИН, ПАРКОВКА)
#define _MAX_ 0
#define _MIN_ 1
#define _PARK_ 2

// ПЕРЕМЕННЫЕ ДЛЯ ВЫБОРА ЯЧЕЕК В МАССИВАХ
#define Z1_arcell 0 // ЯЧЕЙКА ОСИ Z1
#define Z2_arcell 1 // ЯЧЕЙКА ОСИ Z2
#define Z3_arcell 2 // ЯЧЕЙКА ОСИ Z3
#define Z4_arcell 3 // ЯЧЕЙКА ОСИ Z4

#define X1_arcell 4 // ЯЧЕЙКА ОСИ X1
#define X2_arcell 5 // ЯЧЕЙКА ОСИ X2

#define Y_arcell 6 // ЯЧЕЙКА ОСИ Y

#define ROT_GRIP_arcell 8 // ЯЧЕЙКА ПОВОРОТА ЗАХВАТА
#define POS_GRIP_arcell 9 // ЯЧЕЙКА ОТКРЫТИЯ/ЗАКРЫТИЯ ЗАХВАТА
#define Valve_arcell 7 // ЯЧЕЙКА КЛАПАНА

// ID СЕРВОМОТОРОВ
#define Dynamixel_count 10 //КОЛИЧЕСТВО СЕРВОМОТОРОВ В СИСТЕМЕ
#define Z1_dyn_id 1 // ID ДИНАМИКСЕЛЯ ОСИ Z1
#define Z2_dyn_id 2 // ID ДИНАМИКСЕЛЯ ОСИ Z2
#define Z3_dyn_id 3 // ID ДИНАМИКСЕЛЯ ОСИ Z3
#define Z4_dyn_id 4 // ID ДИНАМИКСЕЛЯ ОСИ Z4

#define X1_dyn_id 5 // ID ДИНАМИКСЕЛЯ ОСИ X1
#define X2_dyn_id 6 // ID ДИНАМИКСЕЛЯ ОСИ X2

#define Y_dyn_id 7 // ID ДИНАМИКСЕЛЯ ОСИ Y

#define valve_dyn_id 8 // ID ДИНАМИКСЕЛЯ КЛАПАНА
#define rot_grip_dyn_id 9 // ID ДИНАМИКСЕЛЯ ПОВОРОТА КЛЕШНИ
#define grip_pos_dyn_id 10 // ID ДИНАМИКСЕЛЯ ОТКРЫТИЯ/ЗАКРЫТИЯ ЗАХВАТА

#define com_dir_pin PB1 // ПИН УПРАВЛЕНИЯ МИКРОСХЕМОЙ

int dyn_id_ar[Dynamixel_count] = // МАССИВ ID СЕРВОМОТОРОВ
{
  Z1_dyn_id,
  Z2_dyn_id,
  Z3_dyn_id,
  Z4_dyn_id,
  X1_dyn_id,
  X2_dyn_id,
  Y_dyn_id,
  valve_dyn_id,
  rot_grip_dyn_id,
  grip_pos_dyn_id
};

// ПИНЫ ЭНКОДЕРОВ ОСЕЙ
#define encoder_count 7 // КОЛИЧЕСТВО ЭНКОДЕРОВ В СИСТЕМЕ

#define Z1_encoder_pin  PA0 // ПИН ЭНКОДЕРА ОСИ Z1
#define Z2_encoder_pin  PA1  // ПИН ЭНКОДЕРА ОСИ Z2
#define Z3_encoder_pin  PA2 // ПИН ЭНКОДЕРА ОСИ Z3
#define Z4_encoder_pin  PA3 // ПИН ЭНКОДЕРА ОСИ Z4

#define X16_encoder_pin PB5 // ПИН ЭНКОДЕРА ОСИ X1
#define X15_encoder_pin PB4 // ПИН ЭНКОДЕРА ОСИ X2

#define Y_encoder_pin   PB15 // ПИН ЭНКОДЕРА ОСИ Y


const int encoder_pins_array[encoder_count] = // МАССИВ ПИНОВ ЭНКОДЕРОВ ОСЕЙ
{
  Z1_encoder_pin,
  Z2_encoder_pin,
  Z3_encoder_pin,
  Z4_encoder_pin,
  X15_encoder_pin,
  X16_encoder_pin,
  Y_encoder_pin
};
int Z1_enc_value = 0; // ЗНАЧЕНИЕ ЕКОДЕРА Z1
int Z2_enc_value = 0; // ЗНАЧЕНИЕ ЕКОДЕРА Z2
int Z3_enc_value = 0; // ЗНАЧЕНИЕ ЕКОДЕРА Z3
int Z4_enc_value = 0; // ЗНАЧЕНИЕ ЕКОДЕРА Z4

int X1_enc_value = 0; // ЗНАЧЕНИЕ ЕКОДЕРА X1
int X2_enc_value = 0; // ЗНАЧЕНИЕ ЕКОДЕРА X2

int Y_enc_value = 0; // ЗНАЧЕНИЕ ЕКОДЕРА Y

// ПИНЫ КОНЦЕВИКОВ ОСЕЙ
#define endstop_count 7 // КОЛИЧЕСТВО КОНЦЕВИКОВ В СИСТЕМЕ

#define Z1_endstop_pin  PA6 // ПИН КОНЦЕВИКА ОСИ Z1
#define Z2_endstop_pin  PA4 // ПИН КОНЦЕВИКА ОСИ Z2
#define Z3_endstop_pin  PB0 // ПИН КОНЦЕВИКА ОСИ Z3
#define Z4_endstop_pin  PB12 // ПИН КОНЦЕВИКА ОСИ Z4

#define X15_endstop_pin PA5 // ПИН КОНЦЕВИКА ОСИ X1
#define X16_endstop_pin PA7 // ПИН КОНЦЕВИКА ОСИ X2

#define Y_endstop_pin PB13 // ПИН КОНЦЕВИКА ОСИ Y

bool endstop_read[endstop_count] = {false, false, false, false, false, false, false}; // МАССИВ СОСТОЯНИЙ КОНЦЕВИКОВ

const int endstops_pins_array[endstop_count] =  //МАССИВ ПИНОВ КОНЦЕВИКОВ
{
  Z1_endstop_pin,
  Z2_endstop_pin,
  Z3_endstop_pin,
  Z4_endstop_pin,
  X15_endstop_pin,
  X16_endstop_pin,
  Y_endstop_pin
};

#define KpX 0 // ПРОПОРЦИОНАЛЬНЫЙ КОЭФФИЦЕНТ РЕГУЛЯТОРА ОСИ Х
#define KpZ12 0 // ПРОПОРЦИОНАЛЬНЫЙ КОЭФФИЦЕНТ РЕГУЛЯТОРА ОСИ Z1 И Z2
#define KpZ34 0 // ПРОПОРЦИОНАЛЬНЫЙ КОЭФФИЦЕНТ РЕГУЛЯТОРА ОСИ Z3 И Z4
#define KpZ 0 // ПРОПОРЦИОНАЛЬНЫЙ КОЭФФИЦЕНТ РЕГУЛЯТОРА ОСИ 

#define move_up 1     // ДВИЖЕНИЕ ОСИ ПО УВЕЛЕЧЕНИЮ КООРДИНАТ
#define move_stop 0   // НЕДВИЖЕНИЕ ОСИ
#define move_down -1  // ДВИЖЕНИЕ ОСИ ПО УМЕНЬШЕНИЮ КООРДИНАТ

int goMode_ = 0;

int Z1_speed[3] = {1020, 0, 600}; // СКОРОСТЬ ДИНАМИКСЕЛЯ КАРЕТКИ Z1
int Z2_speed[3] = {1020, 0, 600}; // СКОРОСТЬ ДИНАМИКСЕЛЯ КАРЕТКИ Z2
int Z3_speed[3] = {1020, 0, 600}; // СКОРОСТЬ ДИНАМИКСЕЛЯ КАРЕТКИ Z3
int Z4_speed[3] = {1020, 0, 600}; // СКОРОСТЬ ДИНАМИКСЕЛЯ КАРЕТКИ Z4

int X1_speed[3] = {1020, 0, 600}; // СКОРОСТЬ ДИНАМИКСЕЛЯ КАРЕТКИ X1
int X2_speed[3] = {1020, 0, 600}; // СКОРОСТЬ ДИНАМИКСЕЛЯ КАРЕТКИ X2

int Y_speed[3] = {1020, 0, 600};  // СКОРОСТЬ ДИНАМИКСЕЛЯ КАРЕТКИ Y

int valve_speed = 1020;  // СКОРОСТЬ ДИНАМИКСЕЛЯ КЛАПАНА
int rot_grip_speed = 1020; // СКОРОСТЬ ДИНАМИКСЕЛЯ ПОВОРОТА ЗАХВАТА
int grip_pos_speed = 1020; // СКОРОСТЬ ДИНАМИКСЕЛЯ ЗАХВАТА

const int grip_max_pos = 0;
const int grip_min_pos = 0;

int speed_ar[Dynamixel_count] = 
{
  Z1_speed[goMode_], 
  Z2_speed[goMode_], 
  Z3_speed[goMode_], 
  Z4_speed[goMode_], 
  X1_speed[goMode_], 
  X2_speed[goMode_], 
  Y_speed[goMode_], 
  valve_speed, 
  rot_grip_speed, 
  grip_pos_speed
};

#define valve_close 512 // ЗНАЧЕНИЕ ДЛЯ ДИНАМИКСЛЕЯ КЛАПАНА ПРИ ЕГО ПОЛНОМ ЗАКРЫТИИ
#define valve_open 512  // ЗНАЧЕНИЕ ДЛЯ ДИНАМИКСЛЕЯ КЛАПАНА ПРИ ЕГО ПОЛНОМ ОТКРЫТИИ
#define pump_pin PB6    // НПИН УПРАВЛЕНИЯ ТРАНЗИСТОРОМ ПОМПЫ

#define HOLD 2 // РЕЖИМ ФУНКЦИИ pump "УДЕРЖАТЬ"
#define TAKE 1 // РЕЖИМ ФУНКЦИИ pump "ВЗЯТЬ"
#define PUT  0 // РЕЖИМ ФУНКЦИИ pump "ПОЛОЖИТЬ"

#define LEFT false // ПЕРЕМЕННАЯ ЗАДАЮЩАЯ НАПРАВЛЕНИЕ ВРАЩЕНИЕ МОТОРА
#define RIGHT true // ПЕРЕМЕННАЯ ЗАДАЮЩАЯ НАПРАВЛЕНИЕ ВРАЩЕНИЕ МОТОРА    !!!!!ПРИМЕЧАНИЕ: ЕСТЬ И БИБЛИОТЕКЕ НО РАБОТАЮТ НЕКОРРЕКТНО

///////////////////////////////////////////////////////////////////////////////////////////////////////////////////////////////////////////////////////////////////////////////////


void setup()
{
  com_init(); // ИНИЦИАЛИЗЯЦИЯ ПОСЛЕДОВАТЕЛЬНОГО ПОРТА
  pins_init();// ИНИЦИАЛИЗЯЦИЯ ПИНОВ
  encoders_init(); // ИНИЦИАЛИЗАЦИЯ ЭНКОДЕРОВ
  Dynamixel_init(); // ИНИЦИАЛИЗЯЦИЯ СИСТЕМЫ ДЛЯ ДИНАМИКСЕЛЕЙ
  go_home();
  encoder_reset();
}
///////////////////////////////////////////////////////////////////////////////////////////////////////////////////////////////////////////////////////////////////////////////////
void pins_init() // ФУНКЦИЯ ИНИЦИАЛИЗАЦИИ ПИНОВ
{
  for (int i = 0; i < endstop_count; i++)
  {
    pinMode(endstops_pins_array[i], INPUT);
    delay(5);
  }
  for (int i = 0; i < encoder_count; i++)
  {
    pinMode(encoder_pins_array[i], INPUT);
    delay(5);
  }

  pinMode(pump_pin, OUTPUT);

}

void com_init() // ФУНКЦИЯ ИНИЦИАЛИЗАЦИИ ПОСЛЕДОВАТЕЛЬНОГО ПОРТА
{
  COM.begin(COM_baud);
  while (!COM);
  COM.println("Ready");
  while((char) COM.read() != '1');
}

void encoders_init() // ФУНКЦИЯ ИНИЦИАЛИЗАЦИИ ПРЕРЫВАНИЙ ЭНКОДЕРОВ
{
  attachInterrupt(digitalPinToInterrupt(encoder_pins_array[Z1_arcell]), Z1_counter, RISING);
  attachInterrupt(digitalPinToInterrupt(encoder_pins_array[Z2_arcell]), Z2_counter, RISING);
  attachInterrupt(digitalPinToInterrupt(encoder_pins_array[Z3_arcell]), Z3_counter, RISING);
  attachInterrupt(digitalPinToInterrupt(encoder_pins_array[Z4_arcell]), Z4_counter, RISING);

  attachInterrupt(digitalPinToInterrupt(encoder_pins_array[X1_arcell]), X1_counter, RISING);
  attachInterrupt(digitalPinToInterrupt(encoder_pins_array[X2_arcell]), X2_counter, RISING);

  attachInterrupt(digitalPinToInterrupt(encoder_pins_array[Y_arcell]), Y_counter, RISING);
}
void read_endstops() // ФУНКЦИЯ СЧИТЫВАНИЯ СОСТОЯНИЙ КОНЦЕВИКОВ
{
  for (int i = 0; i < endstop_count; i++)
  {
    endstop_read[i] = digitalRead(endstops_pins_array[i]);
  }
}

void print_endstops() // ФУНКЦИЯ ВЫВОДА СОСТОЯНИЙ КОНЦЕВИКОВ
{
  for (int i = 0; i < endstop_count; i++)
  {
    read_endstops();
    COM.print(endstop_read[i]);
    COM.print(" ");
  }
  COM.println();
}

void print_encoders() // ФУНКЦИЯ ВЫВОДА СЧЕТЧИКОВ ЭНКОДЕРОВ
{
  COM.print(Z1_enc_value);
  COM.print(" ");
  COM.print(Z2_enc_value);
  COM.print(" ");
  COM.print(Z3_enc_value);
  COM.print(" ");
  COM.print(Z4_enc_value);
  COM.print(" ");
  COM.print(X1_enc_value);
  COM.print(" ");
  COM.print(X2_enc_value);
  COM.print(" ");
  COM.print(Y_enc_value);
  COM.println();
}

void Dynamixel_init() // ФУНКЦИЯ ИНИЦИАЛИЗАЦИИ СЕРВОМОТОРОВ
{
  Dynamixel.begin(DXL_baud, com_dir_pin); // начинаем связь с динамикселями на скорости 1 Mbps

  Dynamixel.setEndless(dyn_id_ar[Z1_arcell], ON); // ОТКЛЮЧАЕМ ОГРАНИЧЕНИЕ ДИНАМИКСЕЛЯ Z1
  Dynamixel.setEndless(dyn_id_ar[Z2_arcell], ON); // ОТКЛЮЧАЕМ ОГРАНИЧЕНИЕ ДИНАМИКСЕЛЯ Z2
  Dynamixel.setEndless(dyn_id_ar[Z3_arcell], ON); // ОТКЛЮЧАЕМ ОГРАНИЧЕНИЕ ДИНАМИКСЕЛЯ Z3
  Dynamixel.setEndless(dyn_id_ar[Z4_arcell], ON); // ОТКЛЮЧАЕМ ОГРАНИЧЕНИЕ ДИНАМИКСЕЛЯ Z4

  Dynamixel.setEndless(dyn_id_ar[X1_arcell], ON); // ОТКЛЮЧАЕМ ОГРАНИЧЕНИЕ ДИНАМИКСЕЛЯ X1
  Dynamixel.setEndless(dyn_id_ar[X2_arcell], ON); // ОТКЛЮЧАЕМ ОГРАНИЧЕНИЕ ДИНАМИКСЕЛЯ X2

  Dynamixel.setEndless(dyn_id_ar[Y_arcell], ON); // ОТКЛЮЧАЕМ ОГРАНИЧЕНИЕ ДИНАМИКСЕЛЯ Y

  Dynamixel.turn(dyn_id_ar[Z1_arcell], RIGHT, 0); // ОСТАНАВЛИВАЕМ ДИНАМИКСЕЛЬ Z1
  Dynamixel.turn(dyn_id_ar[Z2_arcell], RIGHT, 0); // ОСТАНАВЛИВАЕМ ДИНАМИКСЕЛЬ Z2
  Dynamixel.turn(dyn_id_ar[Z3_arcell], RIGHT, 0); // ОСТАНАВЛИВАЕМ ДИНАМИКСЕЛЬ Z3
  Dynamixel.turn(dyn_id_ar[Z4_arcell], RIGHT, 0); // ОСТАНАВЛИВАЕМ ДИНАМИКСЕЛЬ Z4

  Dynamixel.turn(dyn_id_ar[X1_arcell], RIGHT, 0); // ОСТАНАВЛИВАЕМ ДИНАМИКСЕЛЬ X1
  Dynamixel.turn(dyn_id_ar[X2_arcell], RIGHT, 0); // ОСТАНАВЛИВАЕМ ДИНАМИКСЕЛЬ X2

  Dynamixel.turn(dyn_id_ar[Y_arcell], RIGHT, 0); // ОСТАНАВЛИВАЕМ ДИНАМИКСЕЛЬ Y
}

void move_X(int mode = 0, bool on1 = false, bool on2 = false) // ФУНКЦИЯ ПЕРЕМЕЩЕНИЯ ОСИ X
{
  int dX = X1_enc_value - X2_enc_value; // НАХОДИМ РАЗНОСТЬ ЭНКОДЕРОВ КАРЕТОК Х1 И Х2
  int dx_speed =  dX * KpX; // УМНОЖАЕМ НА ПРОПОРЦИОНАЛЬНЫЙ КОЭФФИЦЕНТ ОСИ Х
  int X1_sp = abs(speed_ar[X1_arcell] - dx_speed); // ВЫЧИТАЕМ ИЗ УСТАНВЛЕННОЙ СКОРОСТИ ДЛЯ КАРЕТКИ Х1 И ДЕЛАЕМ АБСОЛЮТНЫМ (ПО МОДУЛЮ)
  int X2_sp = abs(speed_ar[X2_arcell] + dx_speed); // ВЫЧИТАЕМ ИЗ УСТАНВЛЕННОЙ СКОРОСТИ ДЛЯ КАРЕТКИ Х2 И ДЕЛАЕМ АБСОЛЮТНЫМ (ПО МОДУЛЮ)
  X1_sp = constrain(X1_sp, 0, 1020);  // ОГРАНИЧИВАЕМ НУЖНУЮ СКОРОСТЬ В ПРЕДЕЛАХ МИНИМАЛЬНОЙ И МАКСИМАЛЬНОЙ ДЛЯ КАРЕТКИ Х1
  X2_sp = constrain(X2_sp, 0, 1020);  // ОГРАНИЧИВАЕМ НУЖНУЮ СКОРОСТЬ В ПРЕДЕЛАХ МИНИМАЛЬНОЙ И МАКСИМАЛЬНОЙ ДЛЯ КАРЕТКИ Х2

  switch (mode) // СМОТРИМ КАКОЙ РЕЖИМ У НАС ПРОСЯТ
  {
    case move_down: // ЕДЕМ ВПЕРЕД (В СТОРОНУ УВЕЛЕЧЕНИЯ КООРДИНАТЫ)
      if (on1 == true) // ЕСЛИ ЕСТЬ РАЗРЕШЕНИЕ ДВИГАТЬСЯ ТО ДВИГАЕМСЯ
        Dynamixel.turn(dyn_id_ar[X1_arcell], LEFT, X1_sp);
      else // ИНАЧЕ НЕ  ДВИГАЕМСЯ
        Dynamixel.turn(dyn_id_ar[X1_arcell], LEFT, 0);

      if (on2 == true) // ЕСЛИ ЕСТЬ РАЗРЕШЕНИЕ ДВИГАТЬСЯ ТО ДВИГАЕМСЯ
        Dynamixel.turn(dyn_id_ar[X2_arcell], RIGHT, X2_sp);
      else // ИНАЧЕ НЕ ДВИГАЕМСЯ
        Dynamixel.turn(dyn_id_ar[X2_arcell], RIGHT, 0);
      break;
    case move_stop: //ПОЛНЫЙ СТОП!!!!
      Dynamixel.turn(dyn_id_ar[X1_arcell], LEFT, 0);
      Dynamixel.turn(dyn_id_ar[X2_arcell], RIGHT, 0);
      break;
    case move_up: // ЕДЕМ НАЗАД (В СТОРОНУ УМЕНЬШЕНИЯ КООРДИНАТЫ)
      if (on1 == true) // ЕСЛИ ЕСТЬ РАЗРЕШЕНИЕ ДВИГАТЬСЯ ТО ДВИГАЕМСЯ
        Dynamixel.turn(dyn_id_ar[X1_arcell], RIGHT, X1_sp);
      else// ИНАЧЕ НЕ  ДВИГАЕМСЯ
        Dynamixel.turn(dyn_id_ar[X1_arcell], RIGHT, 0);

      if (on2 == true) // ЕСЛИ ЕСТЬ РАЗРЕШЕНИЕ ДВИГАТЬСЯ ТО ДВИГАЕМСЯ
        Dynamixel.turn(dyn_id_ar[X2_arcell], LEFT, X2_sp);
      else // ИНАЧЕ НЕ ДВИГАЕМСЯ
        Dynamixel.turn(dyn_id_ar[X2_arcell], LEFT, 0);
      break;
  }
}

void move_Z(int mode = 0, bool on1 = false, bool on2 = false, bool on3 = false, bool on4 = false) // ФУНКЦИЯ ПЕРЕМЕЩЕНИЯ ОСИ Z
{
  int dZ12 = Z1_enc_value - Z2_enc_value; // НАХОДИМ РАЗНОСТЬ 1-ОЙ И 2-ОЙ КАРЕТОК
  int dZ34 = Z3_enc_value - Z4_enc_value; // НАХОДИМ РАЗНОСТЬ 3-ОЙ И 4-ОЙ КАРЕТОК
  int dZ12_speed = KpZ12 * dZ12; // УМНОЖАЕМ НА ПРОПОРЦИОНАЛЬНЫЙ КОЭФФИЦЕНТ ДЛЯ КАРЕТОК Z1 И Z2
  int dZ34_speed = KpZ34 * dZ34; // УМНОЖАЕМ НА ПРОПОРЦИОНАЛЬНЫЙ КОЭФФИЦЕНТ ДЛЯ КАРЕТОК Z3 И Z4
  int dZmid_speed = round((dZ12_speed + dZ34_speed) / 2); // НАХОДИ СРЕДНЕЕ ЗАНЧЕНИЕ И ОКРУГЛЯЕМ ЕГО (НЕОБХОДИМО ДЛЯ УРАВНЕНИЯ ПЛАНКИ ОСИ Х)
  int Z1_sp = abs(speed_ar[Z1_arcell] - dZmid_speed); // ВЫЧИТАЕМ ИЗ УСТАНВЛОЕННОЙ СКОРОСТИ ДЛЯ КАРЕТКИ Z1 И ДЕЛАЕМ АБСОЛЮТНЫМ (ПО МОДУЛЮ)
  int Z2_sp = abs(speed_ar[Z2_arcell] + dZmid_speed); // ВЫЧИТАЕМ ИЗ УСТАНВЛОЕННОЙ СКОРОСТИ ДЛЯ КАРЕТКИ Z2 И ДЕЛАЕМ АБСОЛЮТНЫМ (ПО МОДУЛЮ)
  int Z3_sp = abs(speed_ar[Z3_arcell] - dZmid_speed); // ВЫЧИТАЕМ ИЗ УСТАНВЛОЕННОЙ СКОРОСТИ ДЛЯ КАРЕТКИ Z3 И ДЕЛАЕМ АБСОЛЮТНЫМ (ПО МОДУЛЮ)
  int Z4_sp = abs(speed_ar[Z4_arcell] + dZmid_speed); // ВЫЧИТАЕМ ИЗ УСТАНВЛОЕННОЙ СКОРОСТИ ДЛЯ КАРЕТКИ Z4 И ДЕЛАЕМ АБСОЛЮТНЫМ (ПО МОДУЛЮ)
  Z1_sp = constrain (Z1_sp, 0, 1020); // ОГРАНИЧИВАЕМ НУЖНУЮ СКОРОСТЬ В ПРЕДЕЛАХ МИНИМАЛЬНОЙ И МАКСИМАЛЬНОЙ ДЛЯ КАРЕТКИ Z1
  Z2_sp = constrain (Z2_sp, 0, 1020); // ОГРАНИЧИВАЕМ НУЖНУЮ СКОРОСТЬ В ПРЕДЕЛАХ МИНИМАЛЬНОЙ И МАКСИМАЛЬНОЙ ДЛЯ КАРЕТКИ Z2
  Z3_sp = constrain (Z3_sp, 0, 1020); // ОГРАНИЧИВАЕМ НУЖНУЮ СКОРОСТЬ В ПРЕДЕЛАХ МИНИМАЛЬНОЙ И МАКСИМАЛЬНОЙ ДЛЯ КАРЕТКИ Z3
  Z4_sp = constrain (Z4_sp, 0, 1020); // ОГРАНИЧИВАЕМ НУЖНУЮ СКОРОСТЬ В ПРЕДЕЛАХ МИНИМАЛЬНОЙ И МАКСИМАЛЬНОЙ ДЛЯ КАРЕТКИ Z4

  switch (mode) // СМОТРИМ КАКОЙ РЕЖИМ У НАС ПРОСЯТ
  {
    case move_up: // ЕДЕМ ВПЕРЕД (В СТОРОНУ УВЕЛЕЧЕНИЯ КООРДИНАТЫ)
      if (on1 == true) // ЕСЛИ ЕСТЬ РАЗРЕШЕНИЕ ДВИГАТЬСЯ ТО ДВИГАЕМСЯ
        Dynamixel.turn(dyn_id_ar[Z1_arcell], RIGHT, Z1_sp);
      else // ИНАЧЕ НЕ ДВИГАЕМСЯ
        Dynamixel.turn(dyn_id_ar[Z1_arcell], RIGHT, 0);

      if (on2 == true) // ЕСЛИ ЕСТЬ РАЗРЕШЕНИЕ ДВИГАТЬСЯ ТО ДВИГАЕМСЯ
        Dynamixel.turn(dyn_id_ar[Z2_arcell], LEFT, Z2_sp);
      else // ИНАЧЕ НЕ ДВИГАЕМСЯ
        Dynamixel.turn(dyn_id_ar[Z2_arcell], LEFT, 0);

      if (on3 == true) // ЕСЛИ ЕСТЬ РАЗРЕШЕНИЕ ДВИГАТЬСЯ ТО ДВИГАЕМСЯ
        Dynamixel.turn(dyn_id_ar[Z3_arcell], LEFT, Z3_sp);
      else // ИНАЧЕ НЕ ДВИГАЕМСЯ
        Dynamixel.turn(dyn_id_ar[Z3_arcell], RIGHT, 0);

      if (on4 == true) // ЕСЛИ ЕСТЬ РАЗРЕШЕНИЕ ДВИГАТЬСЯ ТО ДВИГАЕМСЯ
        Dynamixel.turn(dyn_id_ar[Z4_arcell], RIGHT, Z4_sp);
      else // ИНАЧЕ НЕ ДВИГАЕМСЯ
        Dynamixel.turn(dyn_id_ar[Z4_arcell], RIGHT, 0);

      break;
    case move_stop: //ПОЛНЫЙ СТОП!!!!
      Dynamixel.turn(dyn_id_ar[Z1_arcell], RIGHT, 0);
      Dynamixel.turn(dyn_id_ar[Z2_arcell], LEFT, 0);
      Dynamixel.turn(dyn_id_ar[Z3_arcell], RIGHT, 0);
      Dynamixel.turn(dyn_id_ar[Z4_arcell], LEFT, 0);
      break;
    case move_down: // ЕДЕМ НАЗАД (В СТОРОНУ УМЕНЬШЕНИЯ КООРДИНАТЫ)
      if (on1 == true) // ЕСЛИ ЕСТЬ РАЗРЕШЕНИЕ ДВИГАТЬСЯ ТО ДВИГАЕМСЯ
        Dynamixel.turn(dyn_id_ar[Z1_arcell], LEFT, Z1_sp);
      else // ИНАЧЕ НЕ ДВИГАЕМСЯ
        Dynamixel.turn(dyn_id_ar[Z1_arcell], LEFT, 0);

      if (on2 == true) // ЕСЛИ ЕСТЬ РАЗРЕШЕНИЕ ДВИГАТЬСЯ ТО ДВИГАЕМСЯ
        Dynamixel.turn(dyn_id_ar[Z2_arcell], RIGHT, Z2_sp);
      else // ИНАЧЕ НЕ ДВИГАЕМСЯ
        Dynamixel.turn(dyn_id_ar[Z2_arcell], RIGHT, 0);

      if (on3 == true) // ЕСЛИ ЕСТЬ РАЗРЕШЕНИЕ ДВИГАТЬСЯ ТО ДВИГАЕМСЯ
        Dynamixel.turn(dyn_id_ar[Z3_arcell], RIGHT, Z3_sp);
      else // ИНАЧЕ НЕ ДВИГАЕМСЯ
        Dynamixel.turn(dyn_id_ar[Z3_arcell], RIGHT, 0);

      if (on4 == true) // ЕСЛИ ЕСТЬ РАЗРЕШЕНИЕ ДВИГАТЬСЯ ТО ДВИГАЕМСЯ
        Dynamixel.turn(dyn_id_ar[Z4_arcell], LEFT, Z4_sp);
      else // ИНАЧЕ НЕ ДВИГАЕМСЯ
        Dynamixel.turn(dyn_id_ar[Z4_arcell], LEFT, 0);
      break;
  }
}

void move_Y(int mode = 0) // ФУНКЦИЯ ПЕРЕМЕЩЕНИЯ ОСИ Y
{
  switch (mode) // СМОТРИМ КАКОЙ РЕЖИМ У НАС ПРОСЯТ
  {
    case move_down: // ЕДЕМ ВПЕРЕД (В СТОРОНУ УВЕЛЕЧЕНИЯ КООРДИНАТЫ)
      Dynamixel.turn(dyn_id_ar[Y_arcell], RIGHT, speed_ar[Y_arcell]);
      break;
    case move_stop: //ПОЛНЫЙ СТОП!!!!
      Dynamixel.turn(dyn_id_ar[Y_arcell], RIGHT, 0);
      break;
    case move_up: // ЕДЕМ НАЗАД (В СТОРОНУ УМЕНЬШЕНИЯ КООРДИНАТЫ)
      Dynamixel.turn(dyn_id_ar[Y_arcell], LEFT, speed_ar[Y_arcell]);
      break;
  }
}
void goMode(int mode = 0)
{
  switch (mode)
  {
    case _MAX_:
      goMode_ = _MAX_;
    break;
    case _MIN_:
      goMode_ = _MIN_;
    break;
    case _PARK_:
      goMode_ = _PARK_;
    break;
  }
}
void go_home()
{
  goMode(_PARK_);
  read_endstops();
  if (endstop_read[Y_arcell] == true){}
  else
  {
      do 
      {
        read_endstops(); // ЧИТАЕМ КОНЦЕВИКИ
        move_Y(move_down); // СДВИГАЕМ ОСЬ Y
      } while (endstop_read[Y_arcell] != true); // СДВИГАЕМ ОСЬ Y ПОКА КОНЦЕВИК НЕ БУДЕТ НАЖАТ

    move_Y(move_stop); // ОСТАНАВЛИВАЕМ ОСЬ Y
  }
  if (endstop_read[X1_arcell] == true || endstop_read[X2_arcell] == true){}
  else
  {
      do
      {
        read_endstops(); // ЧИТАЕМ КОНЦЕВИКИ
        move_X(move_down, true, true); // ДВИГАЕМ ОСЬ Z ( "!endstop_read[X1_arcell]" ЕСЛИ КОНЦЕВИК НЕ НАЖАТ ТО МОТОР МОЖЕТ ДВИГАТЬСЯ)
    
      } while (endstop_read[X1_arcell] != true || endstop_read[X2_arcell] != true); // СДВИГАЕМ ОСЬ Х ПОКА ВСЕ КОНЦЕВИКИ НЕ БУДУТ НАЖАТЫ

    move_X(move_stop, false, false); // ОСТАНАВЛИВАЕМ ОСЬ X
  }

//  do
//  {
//    //if((char) Serial.read() != '2')break;
//    read_endstops(); // ЧИТАЕМ КОНЦЕВИКИ
//    move_Z(move_up, !endstop_read[Z1_arcell], !endstop_read[Z2_arcell], !endstop_read[Z3_arcell], !endstop_read[Z4_arcell] ); // ДВИГАЕМ ОСЬ Z ( "!endstop_read[Z1_arcell]" ЕСЛИ КОНЦЕВИК НЕ НАЖАТ ТО МОТОР МОЖЕТ ДВИГАТЬСЯ)
//
//  } while ((endstop_read[Z1_arcell] != true && endstop_read[Z2_arcell] != true) && (endstop_read[Z3_arcell] != true && endstop_read[Z4_arcell] != true)); // ПОДНИМАЕМ ОСЬ Z ПОКА ВСЕ КОНЦЕВИКИ НЕ БУДУТ НАЖАТЫ

  move_Z(move_stop, false, false, false, false); // ОСТАНАВЛИВАЕМ ОСЬ Z

  move_Y(move_stop);
  move_X(move_stop, false, false);
  move_Z(move_stop, false, false, false, false);
  encoder_reset();
  COM.println("HOME");
}

void rotate_gripper(int deg = 0) // ФУНКЦИЯ ПОВОРОТА ЗАХВАТА
{
  Dynamixel.move(dyn_id_ar[ROT_GRIP_arcell], map(deg, 0, 1020, 0, 300));
}

void gripper(int pos = 0) // ФУНКЦИЯ ОТКРЫТИЯ/ЗАКРЫТИЯ ЗАХВАТА (НЕОБХОДИМО ПОДОБРАТЬ НАЖНЫЕ КРАЙНИЕ ЗНАЧЕНИЯ)
{
  Dynamixel.move(dyn_id_ar[POS_GRIP_arcell], pos);
}

void pump(int mode = 0) // ФУНКЦИЯ РАБОТЫ ВАККУМНОЙ ПРИСОСКИ
{
  switch (mode) // СМОТРИМ КАКОЙ РЕЖИМ НАДО
  {
    case PUT: // РЕЖИМ "ПОЛОЖИТЬ"
      Dynamixel.move(dyn_id_ar[Valve_arcell], valve_open); // ОТКРЫВАЕМ КЛАПАН
      digitalWrite(pump_pin, LOW); // ОТКЛЮЧАЕМ ПОМПУ
      break;
    case HOLD: // РЕЖИМ "УДЕРЖАТЬ" (НЕОБЯЗАТЕЛЬНЫЙ)
      Dynamixel.move(dyn_id_ar[Valve_arcell], valve_close); // ЗАКРЫВАЕМ КЛАПАН
      digitalWrite(pump_pin, LOW); // ОТКЛЮЧАЕМ ПОМПУ
      break;
    case TAKE: // РЕЖИМ "ВЗЯТЬ"
      Dynamixel.move(dyn_id_ar[Valve_arcell], valve_close); // ЗАКРЫВАЕМ КЛАПАН
      digitalWrite(pump_pin, HIGH); // ВКЛЮЧАЕМ ПОМПУ
  }
}
void encoder_reset()
{
  Z1_enc_value = 0;
  Z2_enc_value = 0;
  Z3_enc_value = 0;
  Z4_enc_value = 0;

  X1_enc_value = 0;
  X2_enc_value = 0;

  Y_enc_value = 0;
}

int getLenth(int _Axis_ = 3)
{
  switch(_Axis_)
  {
    case _X_:

    return round(((((X1_enc_value + X2_enc_value) / 2) / Wheel_tiks) * PI * Wheel_deametr) / 2000);
    
    break;

    case _Y_:
      
    return round(((Y_enc_value / Wheel_tiks) * PI * Wheel_deametr) / 1000);
    
    break;

    case _Z_:

    return round(((((Z1_enc_value + Z2_enc_value + Z3_enc_value + Z4_enc_value) / 4 ) / Wheel_tiks) * PI * Wheel_deametr)/ 4000);

    break;
  }
}


void print_need_data()
{
  COM.print("nextPos:");
  COM.print("{");
  COM.print(nextPos[_X_]);
  COM.print(", ");
  COM.print(nextPos[_Y_]);
  COM.print(", ");
  COM.print(nextPos[_Z_]);
  COM.println("};");


  COM.print("currentPos:");
  COM.print("{");
  COM.print(currPos[_X_]);
  COM.print(", ");
  COM.print(currPos[_Y_]);
  COM.print(", ");
  COM.print(currPos[_Z_]);
  COM.println("};");


  COM.print("lastPos:");
  COM.print("{");
  COM.print(lastPos[_X_]);
  COM.print(", ");
  COM.print(lastPos[_Y_]);
  COM.print(", ");
  COM.print(lastPos[_Z_]);
  COM.println("};");
  COM.println();
}
 
void go_to()
{
  encoder_reset();
  goMode(_MAX_);
  if (nextPos[_X_] < lastPos[_X_])
    while (getLenth(_X_) < lastPos[_X_] - nextPos[_X_])
    {
      read_endstops();
      move_X(move_down, !endstop_read[X1_arcell], !endstop_read[X2_arcell]);
      if (endstop_read[X1_arcell] == true && endstop_read[X2_arcell] == true) { break; }
    }
  else
    while (getLenth(_X_) < nextPos[_X_] - lastPos[_X_])
    {
      read_endstops();
      move_X(move_up, !endstop_read[X1_arcell], !endstop_read[X2_arcell]);
      if (endstop_read[X1_arcell] == true && endstop_read[X2_arcell] == true) { break; }
    }
      
  move_X(move_stop, false, false);

  delay(100);
  
  if (nextPos[_Y_] < lastPos[_Y_])
    while(getLenth(_Y_) < lastPos[_Y_] - nextPos[_Y_])
     move_Y(move_down);
  else
    while(getLenth(_Y_) < nextPos[_Y_] - lastPos[_Y_])
     move_Y(move_up);
  
  move_Y(move_stop);

  delay(100);

  if (nextPos[_Z_] < lastPos[_Z_])
    while(getLenth(_Z_) < lastPos[_Z_] - nextPos[_Z_])
      move_Z(move_down, true, true, true, true);
  else
    while(getLenth(_Z_) < nextPos[_Z_] - lastPos[_Z_])
      move_Z(move_up, true, true, true, true);
      
  move_Z(move_stop, false, false, false, false);
    
  lastPos[_X_] = nextPos[_X_];
  lastPos[_Y_] = nextPos[_Y_];
  lastPos[_Z_] = nextPos[_Z_];
  encoder_reset();
}

void upgrade_pos(float x, float y, float z)
{
  nextPos[_X_] = x;
  nextPos[_Y_] = y;
  nextPos[_Z_] = z;
  print_need_data();
  go_to();
  print_need_data();
}
//////////////////////////////////////////////////////////////////////////////////////////////////////////////////////////////////////////////////////////////////////////////////////////////////////////////
void loop()
{
 
 while (1)
  {
    if ((char) COM.read() == 'h')
      go_home();
  }
}
//////////////////////////////////////////////////////////////////////////////////////////////////////////////////////////////////////////////////////////////////////////////////////////////////////////////

void Z1_counter() // СЧЕТЧИК ОСИ Z1
{
  Z1_enc_value++;
}

void Z2_counter() // СЧЕТЧИК ОСИ Z2
{
  Z2_enc_value++;
}

void Z3_counter() // СЧЕТЧИК ОСИ Z3
{
  Z3_enc_value++;
}

void Z4_counter() // СЧЕТЧИК ОСИ Z4
{
  Z4_enc_value++;
}

void X1_counter() // СЧЕТЧИК ОСИ X1
{
  X1_enc_value++;
}

void X2_counter() // СЧЕТЧИК ОСИ X2
{
  X2_enc_value++;
}

void Y_counter() // СЧЕТЧИК ОСИ Y
{
  Y_enc_value++;
}
