Kvantorium-33/optimal_gripper/(commit log)

2019-07-16 Добавлены 3D модели
    [КВ33.044.000 - Сортирующая ячейка.iam, КВ33.044.001 - Дно.ipt, КВ33.044.200 - Каретка оси Х.iam, КВ33.044.201 - Щека каретки.ipt, КВ33.044.202 - Фиксатор каретки.ipt, Подшипник 626Z.0004.ipt, Подшипник 626Z.ipt, Профиль станочный 30x30x740.0003.ipt]
2019-07-16 Подвинул
    [КВ33.044.000 - Сортирующая ячейка.iam]
2019-07-16 1. Изменены каретки
    2. Изменена конструкция манипулятора
    3. Добавлен станочный профиль 30х30х728
    [КВ33.044.000 - Сортирующая ячейка.iam, КВ33.044.200 - Каретка оси Х.iam, КВ33.044.201 - Щека каретки.ipt, Профиль станочный 30x30x728.ipt, Профиль станочный 30x30x740.0003.ipt, Профиль станочный 30x30x740.0004.ipt, Профиль станочный 30x30x740.ipt]
2019-07-16 Сортирующая ячейка
    [КВ33.044.000 - Сортирующая ячейка.iam]
2019-07-16 Изменена конструкция кареток оси Х
    [КВ33.044.000 - Сортирующая ячейка.iam, КВ33.044.200 - Каретка оси Х.iam, КВ33.044.201 - Щека каретки.ipt, КВ33.044.202 - Фиксатор каретки.ipt, Угол соединительный 30х30х30.0007.ipt, Угол соединительный 30х30х30.ipt]
2019-07-16 Исправлен недочет Фиксатора каретки
    [КВ33.044.000 - Сортирующая ячейка.iam, КВ33.044.200 - Каретка оси Х.iam, КВ33.044.202 - Фиксатор каретки.ipt]
2019-07-17 изменена щека каретки
    [КВ33.044.000 - Сортирующая ячейка.iam, КВ33.044.002 - Деражатель мотора.ipt, КВ33.044.002 - Держатель катка.ipt, КВ33.044.200 - Каретка оси Х.iam, КВ33.044.201 - Щека каретки.ipt, КВ33.044.202 - Фиксатор каретки.ipt]
2019-07-17 щека каретки
    [КВ33.044.000 - Сортирующая ячейка.iam, КВ33.044.200 - Каретка оси Х.iam]
2019-07-17 Обновлена "сортирующая ячейка"
    [КВ33.044.000 - Сортирующая ячейка.iam, КВ33.044.002 - Деражатель мотора.ipt, КВ33.044.002 - Держатель катка.ipt, КВ33.044.300 - Сборка мотора Makeblock с крепление.iam, КВ33.044.301 - Деражатель мотора.ipt, КВ33.044.400 - Сборка деражтеля катка 6 мм.iam, КВ33.044.401 - Держатель катка 6 мм.ipt, КВ33.044.402 - Каток.ipt]
2019-07-17 Поправлены "Свойства Inventor" деталей
    [Шаговый двигатель Makeblock.0001.ipt, Шаговый двигатель Makeblock.ipt, шкив Makeblock.0001.ipt, шкив Makeblock.ipt]
2019-07-18 изменена сборка
    [КВ33.044.000 - Сортирующая ячейка.iam, КВ33.044.200 - Каретка оси Х.iam, КВ33.044.201 - Щека каретки.ipt, КВ33.044.202 - Фиксатор каретки.ipt, КВ33.044.300 - Сборка мотора Makeblock с крепление.iam, КВ33.044.301 - Деражатель мотора.ipt, КВ33.044.400 - Сборка деражтеля катка 6 мм.iam, КВ33.044.401 - Держатель катка 6 мм.ipt]
2019-07-18 изменена каретка
    [КВ33.044.200 - Каретка оси Х.iam, КВ33.044.201 - Щека каретки.ipt, Подшипник 624Z.0005.ipt, Подшипник 624Z.0006.ipt, Подшипник 624Z.ipt, шкив Makeblock.ipt]
2019-07-21 изменена каретка
    центральное отверстие d=8,2
    [КВ33.044.000 - Сортирующая ячейка.iam, КВ33.044.200 - Каретка оси Х.iam, КВ33.044.201 - Щека каретки.ipt]
2019-07-21 Создана каретка захвата
    изменены каретка оси Х
    обновлена сборка
    [КВ33.044.000 - Сортирующая ячейка.iam, КВ33.044.100 - Механизм перемещения захвата.iam, КВ33.044.200 - Каретка оси Х.iam, КВ33.044.201 - Щека каретки.ipt, КВ33.044.300 - Сборка мотора Makeblock с крепление.iam, КВ33.044.302 - Шкив с резьбой.ipt, КВ33.044.500 - Каретка оси Y.iam, КВ33.044.501 - Каретка оси Y.ipt]
2019-08-02 Добавлена опора держателя катка
    [КВ33.044.201 - Щека каретки.ipt, КВ33.044.302 - Шкив с резьбой.ipt, КВ33.044.302 - Шкив.ipt, КВ33.044.500 - Каретка оси Y.iam, КВ33.044.601 - Опора держателя катка.ipt, КВ33.044.602 - Держатель катка.ipt, Шкив Makeblock.ipt]
2019-08-02 изменены каретки оси Z и Y
    [КВ33.044.000 - Сортирующая ячейка.iam, КВ33.044.100 - Механизм перемещения захвата.iam, КВ33.044.200 - Каретка оси Х.iam, КВ33.044.201 - Щека каретки.ipt, КВ33.044.400 - Сборка деражтеля катка 6 мм.iam, КВ33.044.500 - Каретка оси Y.iam, КВ33.044.501 - Каретка оси Y.ipt, КВ33.044.502 - Фиксатор оси Y.ipt]
2019-08-04 изменена основная сборка, созданы крепления для ремней у щек кареток
    [Винт М5х10 с потайной головкой.0002.ipt, Винт М5х10 с потайной головкой.ipt, Винт М8х25 с потайной головкой.0002.ipt, Винт М8х25 с потайной головкой.ipt, КВ33.044.000 - Сортирующая ячейка.iam, КВ33.044.200 - Каретка оси Х.iam, КВ33.044.201 - Щека каретки.ipt, КВ33.044.203 - Прижим ремня.ipt]
2019-08-05 Change camera
2019-08-05 изменены крепления под моторы, на Dynamixel AX-12A
    [AX-12A_body.0003.ipt, AX-12A_body.ipt, AX-12A_wheel.0001.ipt, AX-12A_wheel.ipt, ax-12a.0003.iam, ax-12a.iam, КВ33.044.000 - Сортирующая ячейка.iam, КВ33.044.300 - Сборка мотора Makeblock с крепление.iam]
2019-08-06 изменен держатель мотора
    [КВ33.044.300 - Сборка сервомотора Makeblock с крепление.iam, КВ33.044.301 - Деражатель мотора.ipt, Оптический датчик.0002.ipt, Оптический датчик.ipt, проставка.ipt]
2019-08-06 изменена сборка держателя мотора, изменен шкив
    [КВ33.044.000 - Сортирующая ячейка.iam, КВ33.044.201 - Щека каретки.ipt, КВ33.044.300 - Сборка сервомотора Dynamixel с крепление.iam, КВ33.044.300 - Сборка сервомотора Makeblock с крепление.iam, КВ33.044.301 - Деражатель мотора.ipt, КВ33.044.303 - Шкив.ipt, КВ33.044.304 - Колесо энкодера.ipt, КВ33.044.304 -Проставка.ipt]
2019-08-06 добавлены концевики на держатели моторов
    [Датчик оптический (с контактами с противоположной стороны(спец. разъем)).ipt, Датчик оптический (с контактами с противоположной стороны).ipt, Датчик оптический (стандартный).ipt, КВ33.044.000 - Сортирующая ячейка.iam, КВ33.044.300 - Сборка сервомотора Dynamixel с крепление.iam, КВ33.044.301 - Деражатель мотора.ipt, КВ33.044.302 - Шкив с резьбой.ipt, КВ33.044.400 - Сборка сервомотора Dynamixel с к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]
2019-08-08 прошивка без ROS
2019-08-08 Создана каретка оси X
    [КВ33.044.000 - Сортирующая ячейка.iam, КВ33.044.200 - Каретка оси Z.iam, КВ33.044.200 - Каретка оси Х.iam, КВ33.044.201 - Щека каретки Z.ipt, КВ33.044.201 - Щека каретки.ipt, КВ33.044.201 - Щека каретки.stl, КВ33.044.202 - Фиксатор каретки Z.ipt, КВ33.044.203 - Прижим ремня каретки Z.ipt]
2019-08-08 программа для управления динамикселями
2019-08-08 изменена каретка оси X
    [КВ33,044,304 - Колесо энкодера.dxf, КВ33,044,305 - Боковина шкива.dxf, КВ33.044.000 - Сортирующая ячейка.iam, КВ33.044.201 - Щека каретки.stl, КВ33.044.203 - Прижим ремня.stl, КВ33.044.301 - Деражатель мотора.stl, КВ33.044.304 -Проставка.stl, КВ33.044.401 - Деражатель мотора обратный.stl]
2019-08-11 Добавлен корпус блока управления
    [КВ33.044.000 - Сортирующая ячейка.iam, КВ33.044.002 - Дно блока управления.ipt, КВ33.044.003 - крепеж дна блока управления.ipt, КВ33.044.004 - Стенка блока управления.ipt, КВ33.044.005 - Крышка блока управления.ipt, КВ33.044.100 - Блок управления.iam, КВ33.044.100 - Механизм перемещения захвата.iam, КВ33.044.200 - Каретка оси Z.iam]
2019-08-13 Убран блок управления
    [AX-12A_body.0003.ipt, AX-12A_body.0004.ipt, AX-12A_body.ipt, ax-12a.0003.iam, ax-12a.0004.iam, ax-12a.iam, КВ33.044.000 - Сортирующая ячейка.iam, КВ33.044.002 - Дно блока управления.ipt]
2019-08-13 изменен крепеж ремня
    [КВ33,044,304 - Крепеж ремня х2.dxf, КВ33.044.000 - Сортирующая ячейка.iam, КВ33.044.204 - Держатель ремня.ipt, КВ33.044.300 - Каретка оси X.iam, КВ33.044.400 - Сборка сервомотора Dynamixel с крепление.iam, КВ33.044.500 - Сборка сервомотора Dynamixel с крепление обратный.iam, КВ33.044.600 - Каретка оси Y.iam]
2019-08-13 изменена каретка оси Y
    [Датчик оптический (стандартный).0003.ipt, Датчик оптический (стандартный).ipt, КВ33.044.000 - Сортирующая ячейка.iam, КВ33.044.200 - Каретка оси Z.iam, КВ33.044.600 - Каретка оси Y.iam, КВ33.044.601 - Щека каретка оси Y.ipt, КВ33.044.604 - Щека 2 каретка оси Y.ipt]
2019-08-14 изменена каретка Y
    [КВ33.044.000 - Сортирующая ячейка.iam, КВ33.044.300 - Каретка оси X.iam, КВ33.044.600 - Каретка оси Y.iam, КВ33.044.601 - Щека каретка оси Y.ipt, КВ33.044.901 - Щека каретки X.stl]
2019-08-14 Наложены ограничения на передвижения кареток по всем осям
    [AX-12A_body.0004.ipt, AX-12A_body.0005.ipt, AX-12A_body.ipt, AX-12A_wheel.0001.ipt, AX-12A_wheel.0002.ipt, AX-12A_wheel.ipt, UM2_КВ33.044.201 - Щека каретки Z.3mf, Боковина шкива.dxf]
2019-08-18 Добавлен захват
    изменен держатель ремня
    [ax-12a.0004.iam, ax-12a.0007.iam, ax-12a.iam, База.ipt, Боковина шкива уменьшанная.0007.ipt, Боковина шкива уменьшанная.0008.ipt, Боковина шкива уменьшанная.ipt, КВ33.044.000 - Сортирующая ячейка.iam]
2019-08-18 изменен крепеж ремня каретки Y
    [AX-12A_wheel.0002.ipt, AX-12A_wheel.0003.ipt, AX-12A_wheel.ipt, КВ33.044.000 - Сортирующая ячейка.iam, КВ33.044.100 - Захват.iam, КВ33.044.200 - Сборка зажима.iam, КВ33.044.300 - Каретка оси Z.iam, КВ33.044.400 - Каретка оси X.iam]
2019-08-19 изменен зажим ремня
    [ax-12a.0007.iam, ax-12a.0008.iam, ax-12a.iam, КВ33.044.000 - Сортирующая ячейка.iam, КВ33.044.204 - Крепеж ремня.dxf, КВ33.044.305 - Крепеж держателя ремня.ipt, КВ33.044.305 - Крепеж держателя ремня.stl, КВ33.044.305 - Крепеж ремня оси Y.stl]
2019-08-19 Исправлены ошибки каретки оси Y
    [UM2_КВ33.044.701 - Щека каретка оси Y.3mf, ax-12a.0008.iam, ax-12a.0010.iam, ax-12a.iam, КВ33.044.000 - Сортирующая ячейка.iam, КВ33.044.100 - Захват.iam, КВ33.044.101 - Опора захвата.ipt, КВ33.044.300 - Каретка оси Z.iam]
2019-08-20 изменен прижим ремня
    [КВ33.044.000 - Сортирующая ячейка.iam, КВ33.044.100 - Захват.iam, КВ33.044.200 - Сборка зажима.iam, КВ33.044.300 - Каретка оси Z.iam, КВ33.044.305 - Крепеж держателя ремня.ipt, КВ33.044.305 - Прижим ремня.ipt, КВ33.044.306 - Прижим ремня.ipt, КВ33.044.400 - Каретка оси X.iam]
2019-08-22 изменены крепежи моторов оси Z
    [KV33_044_101_-_Opora_zakhvata.stl, KV33_044_102_-_Koleso_zubchatoe_servomotora.stl, KV33_044_201_-_Opora_zazhimnogo_mekhanizma.stl, KV33_044_202_-Prikhvat.stl, KV33_044_203_-_Rychag_tolsty.stl, KV33_044_204_-Rychag_tonkiy_4sht.stl, KV33_044_205_-_Rychag_privodnoy_17_zubyev.stl, KV33_044_206_-_Rychag_privodnoy_16_zubyev.stl]
2019-08-22 Изменена сборка
    Добавлена плата принимающая
    [UM2_KV33_044 - zahvat.3mf, ax-12a.0010.iam, ax-12a.0011.iam, ax-12a.iam, КВ33.044.000 - Сортирующая ячейка.iam, КВ33.044.100 - Захват.iam, КВ33.044.100 - Захват.stp, КВ33.044.101 - Опора захвата.stl]
2019-08-23 Изменена плата принимающая под ось Z
    [Печатная плата принимающая.brd, Печатная плата принимающая.sch]
2019-08-24 Изменена управляющая плата
    [Печатная плата принимающая ось Z.brd, Печатная плата принимающая ось Z.sch, Печатная плата управляющая.sch]
2019-08-25 Добавлен клапан впускной
    [AX-12A_body.0005.ipt, AX-12A_wheel.0003.ipt, UM2_КВ33.044.900 - Клапан впускной.3mf, ax-12a.0011.iam, ax-12a.0012.iam, ax-12a.iam, База.0009.ipt, Боковина шкива уменьшанная.0008.ipt]
2019-08-25 Изменена программа
    [КВ33.044.000 - Сортирующая ячейка.iam, КВ33.044.100 - Захват.iam, КВ33.044.200 - Сборка зажима.iam, КВ33.044.900 - Клапан присоски впускной.iam, КВ33.044.901 - Опора клапана присоски.ipt]
2019-08-27 принимающие платы разделены по осям
    [copper_bottom.gbr, copper_top.gbr, drills.xln, gerber_job.gbrjob, profile.gbr, silkscreen_bottom.gbr, silkscreen_top.gbr, soldermask_bottom.gbr]
2019-08-27 Добавлена отзеркаленная принимающая плата оси Z
    [КВ33.044.000 - Сортирующая ячейка.iam, Печатная плата принимающая ось Z - обратная.0009.ipt, Печатная плата принимающая ось Z - обратная.0010.ipt, Печатная плата принимающая ось Z - обратная.ipt, Печатная плата принимающая ось Z - обратная.sch, Печатная плата принимающая ось Z -обратная.brd, Печатная плата принимающая ось Z.0004.ipt, Печатная плата принимающая ось Z.dxf]
2019-08-29 Добавлен ROS пакет распознавания речи
    [copper_bottom.gbr, copper_top.gbr, drills.xln, gerber_job.gbrjob, profile.gbr, silkscreen_bottom.gbr, silkscreen_top.gbr, soldermask_bottom.gbr]
2019-08-29 Добавлена папка "документация"
    добавлен держатель присоски
    [099990987___.0001.ipt, 099990987___.ipt, ASSY_DUMMY__.0002.ipt, ASSY_DUMMY__.ipt, ASSY_GEAR-WHEEL__.0001.ipt, ASSY_GEAR-WHEEL__.ipt, AX-12.0003.iam, AX-12.iam]
2019-08-30 Добавлены чертежи
    [Боковина шкива.0004.ipt, Боковина шкива.ipt, Винт М5х10 с потайной головкой.0003.ipt, Винт М5х10 с потайной головкой.0004.ipt, Винт М5х10 с потайной головкой.ipt, Винт М8х25 с потайной головкой.0003.ipt, Винт М8х25 с потайной головкой.0004.ipt, Винт М8х25 с потайной головкой.ipt]
2019-09-22 Add urdf_tutorial files
    [01-myfirst.urdf, 02-multipleshapes.urdf, 03-origins.urdf, 04-materials.urdf, 05-visual.urdf, 06-flexible.urdf, 07-physics.urdf, 08-macroed.urdf.xacro]
2019-09-22 Add smart_gripper package
    [09-publishjoints.urdf.xacro, 10-firsttransmission.urdf.xacro, 11-limittransmission.urdf.xacro, 12-gripper.urdf.xacro, 13-diffdrive.urdf.xacro, model.urdf.xacro]
2019-10-25 Добавлена новая прошивка
    Пока не работает
    [КВ33.044.000 - Сортирующая ячейка.iam, КВ33.044.100 - Захват.iam, КВ33.044.200 - Сборка зажима.iam, КВ33.044.201 - Опора зажимного механизма.ipt, КВ33.044.304 - Держатель ремня.ipt, КВ33.044.305 - Прижим ремня.ipt]
2019-10-26 добавлен словарь
2019-10-26 Захват переделан на подшипники
    [КВ33.044.000 - Сортирующая ячейка.iam, КВ33.044.100 - Захват.iam, КВ33.044.200 - Сборка зажима.iam, КВ33.044.201 - Опора зажимного механизма.ipt, КВ33.044.205 - Рычаг приводной 17 зубьев.ipt, КВ33.044.206 - Рычаг приводной 16 зубьев.ipt]
2019-10-26 Обновлен захват под винт М4
    [КВ33.044.000 - Сортирующая ячейка.iam, КВ33.044.100 - Захват.iam, КВ33.044.200 - Сборка зажима.iam, КВ33.044.201 - Опора зажимного механизма.ipt, КВ33.044.202 -Прихват.ipt, КВ33.044.203 - Рычаг толстый.ipt, КВ33.044.204 -Рычаг тонкий.ipt, КВ33.044.205 - Рычаг приводной 17 зубьев.ipt]
2019-10-30 Добавлен держатель для плат
    [untitled.brd, untitled.sch, КВ33.044.000 - Сортирующая ячейка.iam, КВ33.044.002 - Дно платы .ipt, КВ33.044.700 - Каретка оси Y.iam, КВ33.044.701 - Щека каретка оси Y.ipt]
2019-10-30 Изменен крепеж платы
    [КВ33.044.002 - Дно платы .ipt, дно плат.dxf]
2019-10-30 изменена основа блока управления
    [КВ33.044.000 - Сортирующая ячейка.iam, КВ33.044.002 - Дно платы .ipt, КВ33.044.1000 - Блок управления.iam, КВ33.044.1001 - Дно платы.ipt, КВ33.044.1002 - Плата распределительная.ipt, КВ33.044.1003 - Плата контроля сервомоторами.ipt, дно плат.dxf]
2019-10-31 Прошивка разделена для OpenCM и Arduino
    [AX-12.0009.iam, AX-12.0010.iam, AX-12.iam, КВ33.044.000 - Сортирующая ячейка.iam, КВ33.044.100 - Захват.iam, КВ33.044.1000 - Блок управления.iam, КВ33.044.1001 - Дно платы.ipt, КВ33.044.1002 - Плата распределительная.ipt]
2019-11-02 Добавлена программа для Arduino mega
    Программа не работает
2019-11-04 изменена программа под arduino mega
    программа не работает
2019-11-05 Изменена прошивка
2019-11-07 Изменена прошивка. Добавлен чек-лист для отправления
    Программа компилируется. Чек-лист может измениться
2019-11-08 Исправлены ошибки прошивки
    нереализовано прерывание на 1 из пинов
    [Kvantoriada_MEGA.ino, Pinout_config.h]
2019-11-09 Добавлена поддержка прерываний на 4 пине
2019-11-13 Изменен блок управления
    [BluePill_Board.ipt, BluePill_Jumper_2.54.ipt, BluePill_Led0603_Green.ipt, BluePill_Led0603_Red.ipt, BluePill_Pin_Header_1x20.ipt, BluePill_Pin_Header_1x3.ipt, BluePill_Pin_Header_1x4.ipt, BluePill_Pushbutton.ipt]
2019-11-15 Добавлен шаблон прошивки для STM32duino
2019-11-16 изменена программа для STM32duino
2019-11-18 Начата новая прогамма для STM32duino
2019-11-19 Добавлены комментарии к программе для STM32duino
2019-11-19 Изменена программа. Работают энкодеры и концевики
2019-11-19 Изменена программа. Добавлена заглушка на оси X
    Великая сила не подключена
    [КВ33.044.000 - Сортирующая ячейка.iam, КВ33.044.400 - Каретка оси X.iam, КВ33.044.405 - Крепеж ремня оси Y.ipt, КВ33.044.407 - Заглушка разъема.ipt]
2019-11-22 В программе добавлены функции для перемещения осей Z и Y
2019-11-23 Исправлены ошибки программы
2019-11-23 Изменена программа(добавлены новые функции)
2019-11-23 Изменена программа(добавлены новые функции)
    необходимо обновить библиотеку DynamixelSerial3
2019-11-24 Изменена папка прошивки
2019-11-24 Изменена библиотека управления динамикселями
2019-11-26 Добавлена функция движения по координатам
2019-11-28 Исправлена прошивка
2019-11-29 Добавлены ограничители по оси Z
    [КВ33.044.000 - Сортирующая ячейка.iam, КВ33.044.002 - ограничитель перемещения по оси Z.ipt]
2019-11-29 изменен координатный метод
2019-11-30 Исправлен координатный метод
2019-12-01 Исправлены недочеты программы
2019-12-02 Изменен метод передвижения
2019-12-04 Добавлена функция изменения скорости моторов
