Kvantorium-33/optimal_gripper/(notices)

Notices in the files:
parts and their libraries:
SparkFun-LED: Licensing: Creative Commons ShareAlike 4.0 International - https://creativecommons.org/licenses/by-sa/4.0
Wurth_Elektronik_Electromechanic_Input-O: Copyright: Würth Elektronik
